streamy2008/jinshanling-yard-dashboard/金山岭小院施工协同网页/planD-3d/sky.jpg

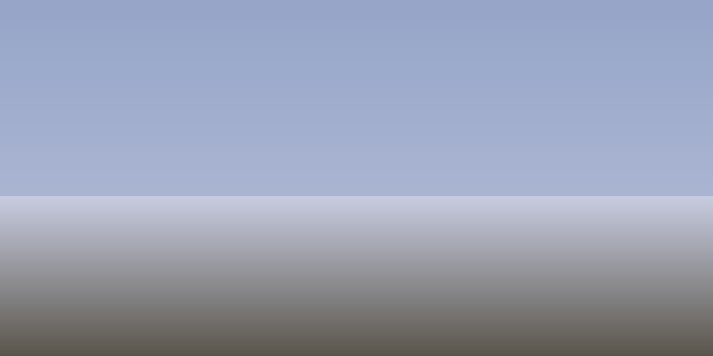
金山岭小院施工协同网页/planD-3d/sky.jpg
