streamy2008/jinshanling-yard-dashboard/20260624金山岭庭院合同/02_栏杆 杆件 置物架 详图_202607.pdf

# 金山岭庭院装置

## 圆钢栏杆、圆钢杆件、置物架详图

## 即作建筑 MINOR lab

（此文件标注为设计尺寸，详厂家二次深化）

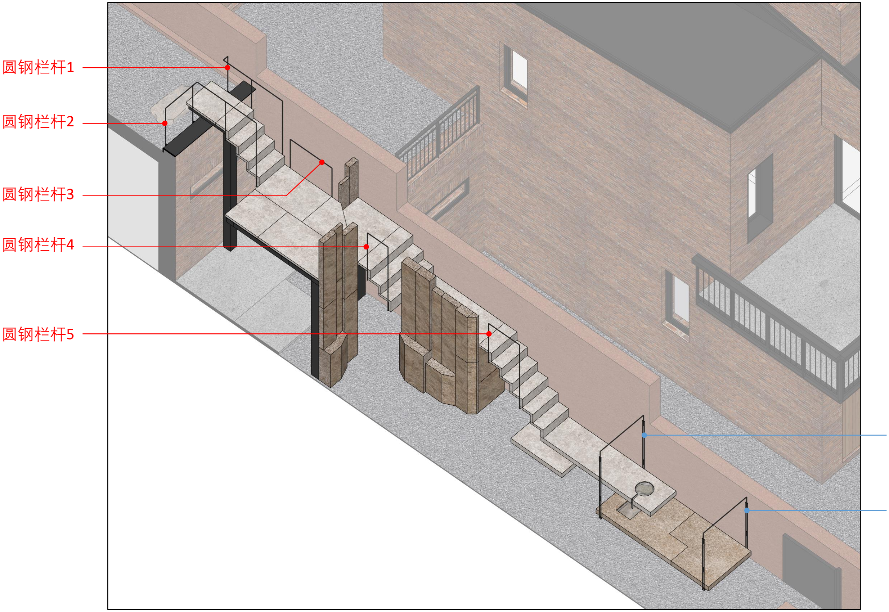
[picture p2: figure]
圆钢栏杆1; 圆钢栏杆2; 圆钢栏杆3; 圆钢栏杆4; 圆钢栏杆5

圆钢杆件A

圆钢杆件B

## 圆钢栏杆、圆钢杆件 索引图

## 圆钢栏杆1

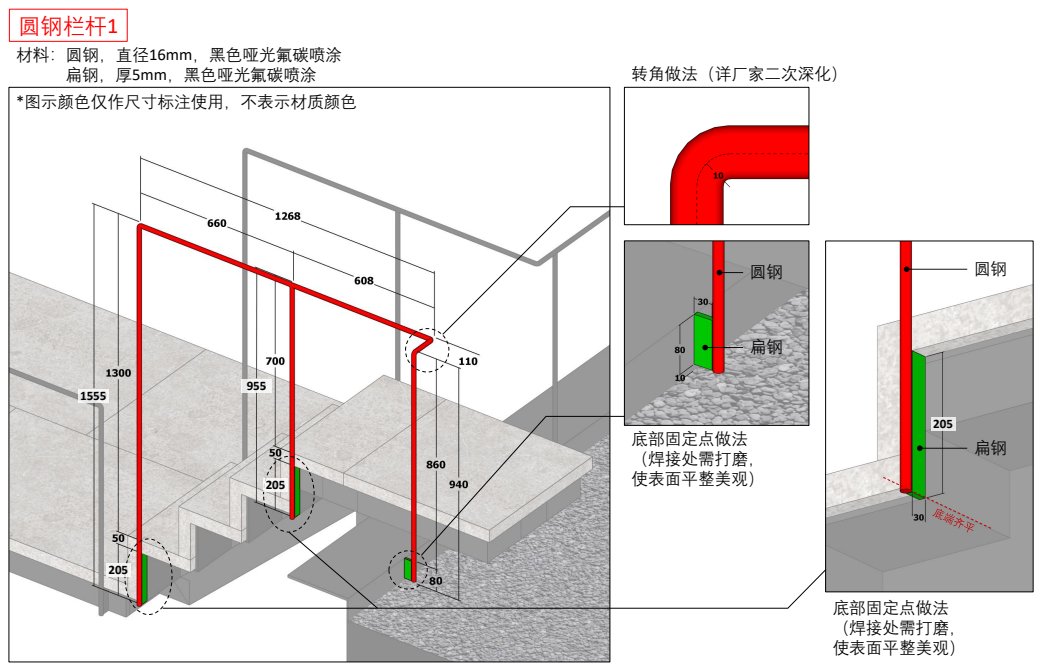
[picture p3: page 3]
转角做法（详厂家二次深化）; 底部固定点做法 （焊接处需打磨， 使表面平整美观）

材料：圆钢，直径16mm，黑色哑光氟碳喷涂
扁钢，厚5mm，黑色哑光氟碳喷涂
*图示颜色仅作尺寸标注使用，不表示材质颜色

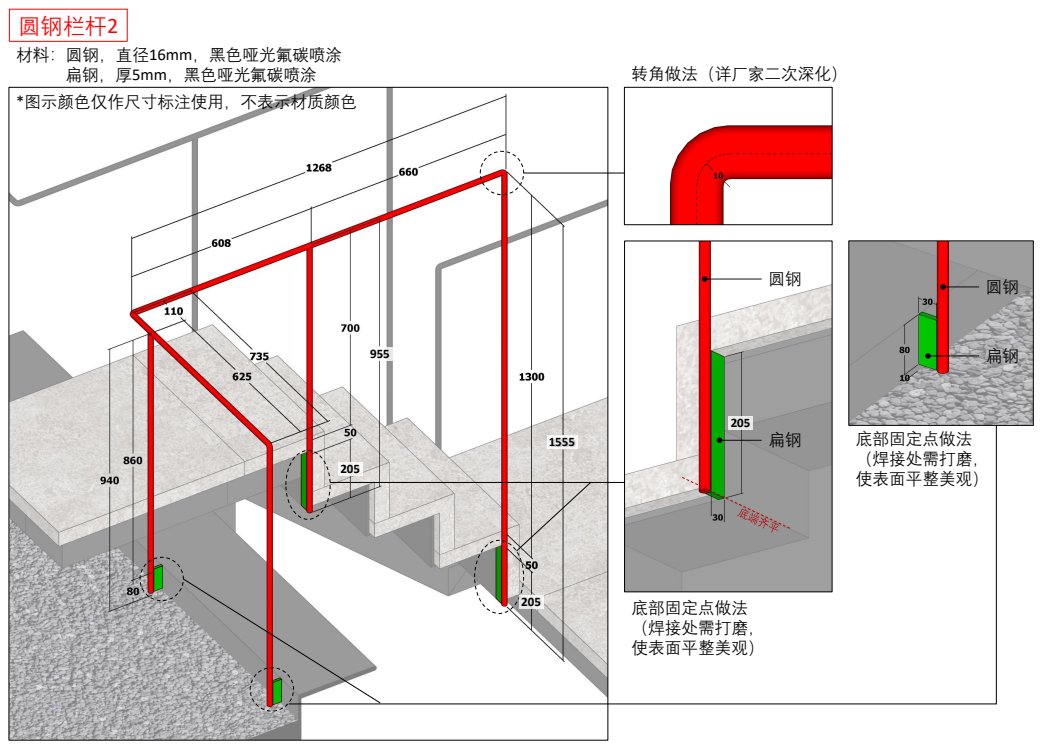
[picture p4: page 4]
底部固定点做法 （焊接处需打磨， 使表面平整美观）; 转角做法（详厂家二次深化）

材料：圆钢，直径16mm，黑色哑光氟碳喷涂
扁钢，厚5mm，黑色哑光氟碳喷涂
*图示颜色仅作尺寸标注使用，不表示材质颜色

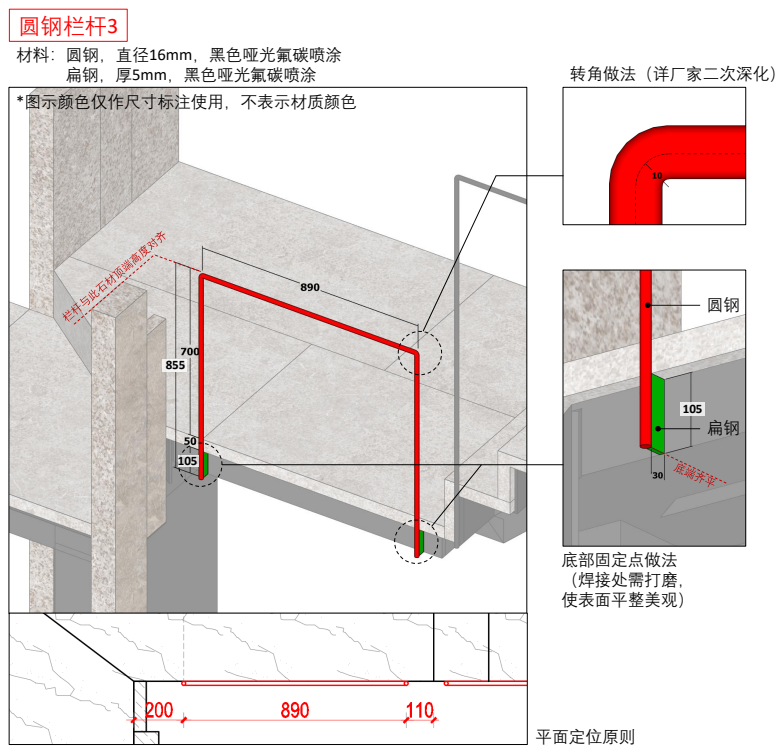
[picture p5: page 5]
底部固定点做法 （焊接处需打磨， 使表面平整美观）; 转角做法（详厂家二次深化）; 平面定位原则

材料：圆钢，直径16mm，黑色哑光氟碳喷涂
扁钢，厚5mm，黑色哑光氟碳喷涂
*图示颜色仅作尺寸标注使用，不表示材质颜色

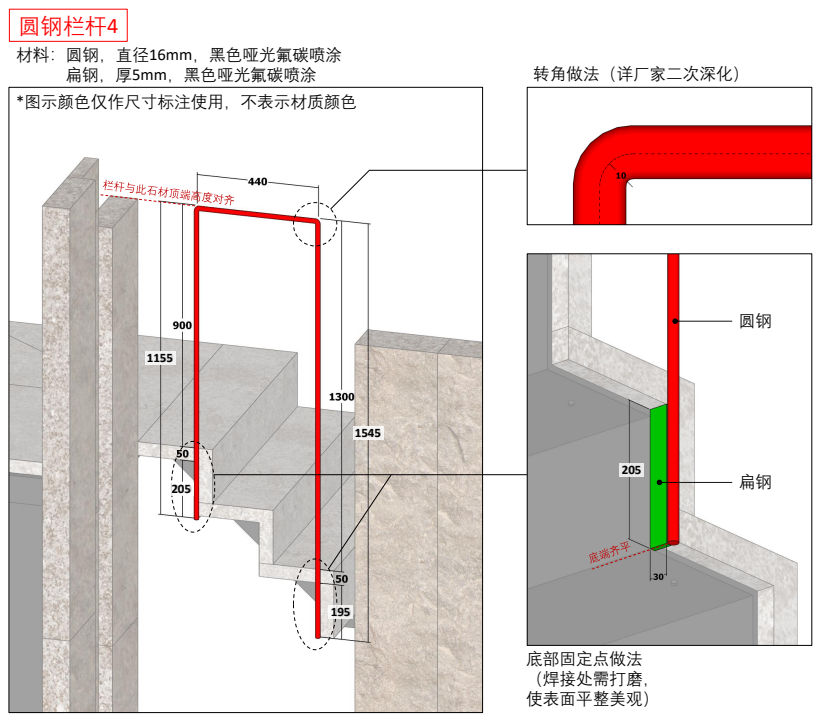
[picture p6: page 6]
底部固定点做法 （焊接处需打磨， 使表面平整美观）; 转角做法（详厂家二次深化）

材料：圆钢，直径16mm，黑色哑光氟碳喷涂
扁钢，厚5mm，黑色哑光氟碳喷涂
*图示颜色仅作尺寸标注使用，不表示材质颜色

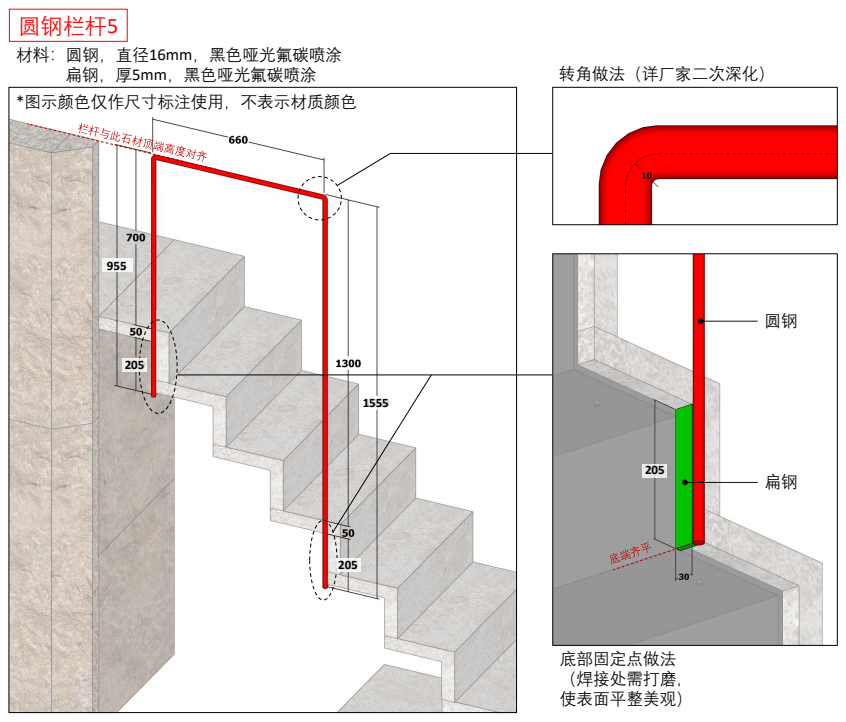
[picture p7: page 7]
底部固定点做法 （焊接处需打磨， 使表面平整美观）; 转角做法（详厂家二次深化）

材料：圆钢，直径16mm，黑色哑光氟碳喷涂
扁钢，厚5mm，黑色哑光氟碳喷涂
*图示颜色仅作尺寸标注使用，不表示材质颜色

## 圆钢杆件A

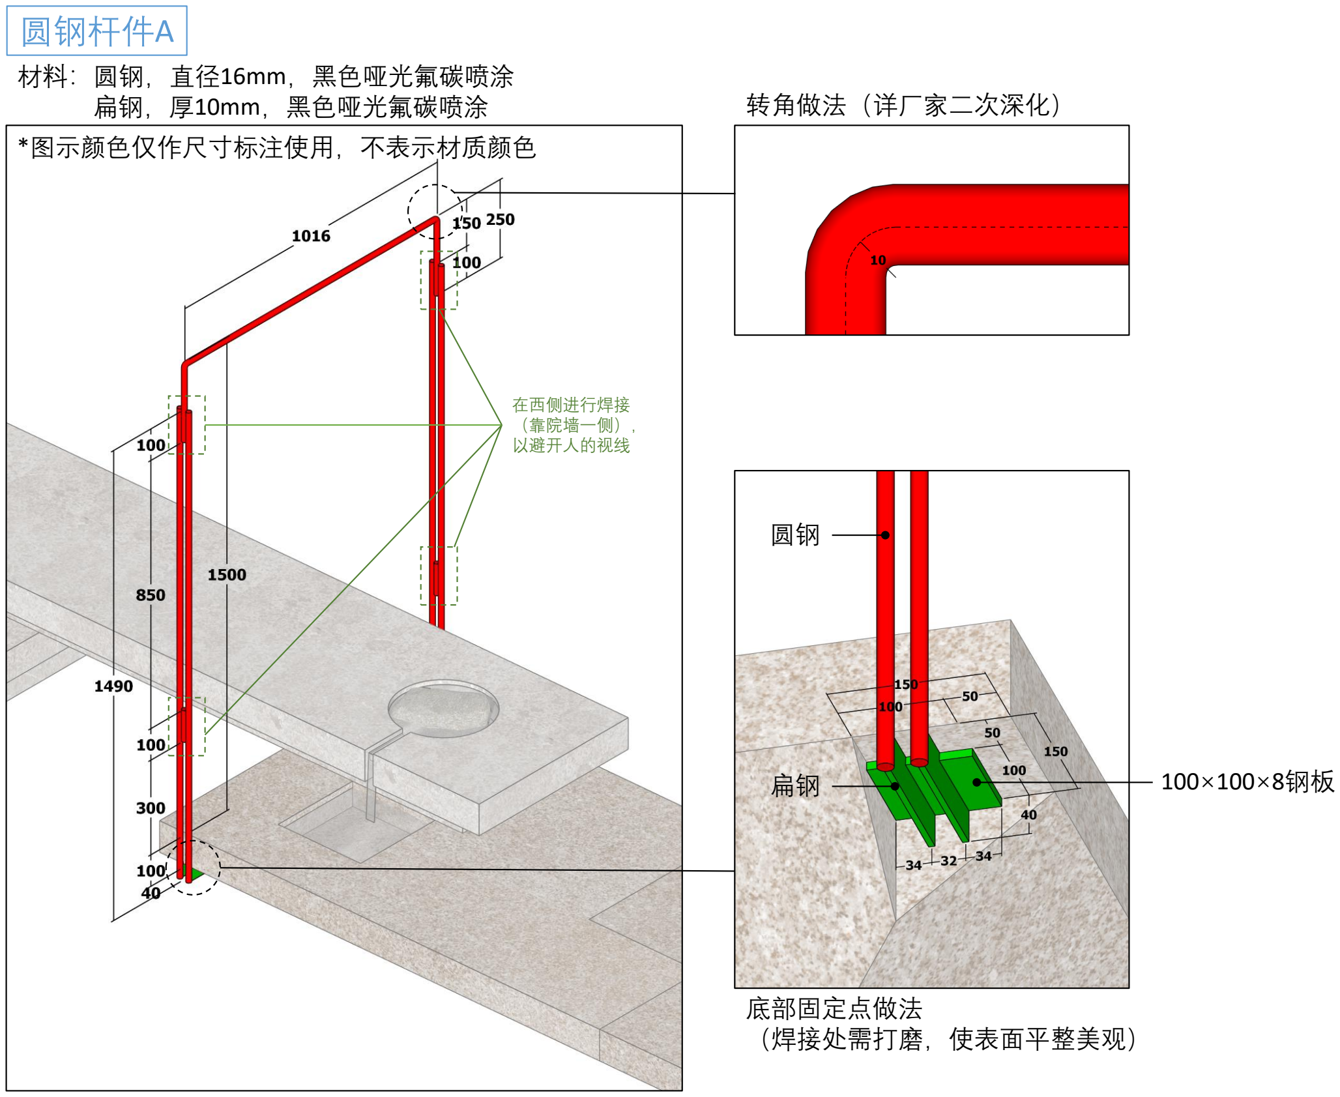
[picture p8: page 8]

*图示颜色仅作尺寸标注使用，不表示材质颜色

材料：圆钢，直径16mm，黑色哑光氟碳喷涂
扁钢，厚10mm，黑色哑光氟碳喷涂

在西侧进行焊接
（靠院墙一侧），
以避开人的视线

转角做法（详厂家二次深化）

底部固定点做法
（焊接处需打磨，使表面平整美观）

扁钢

圆钢

100×100×8钢板

## 圆钢杆件B

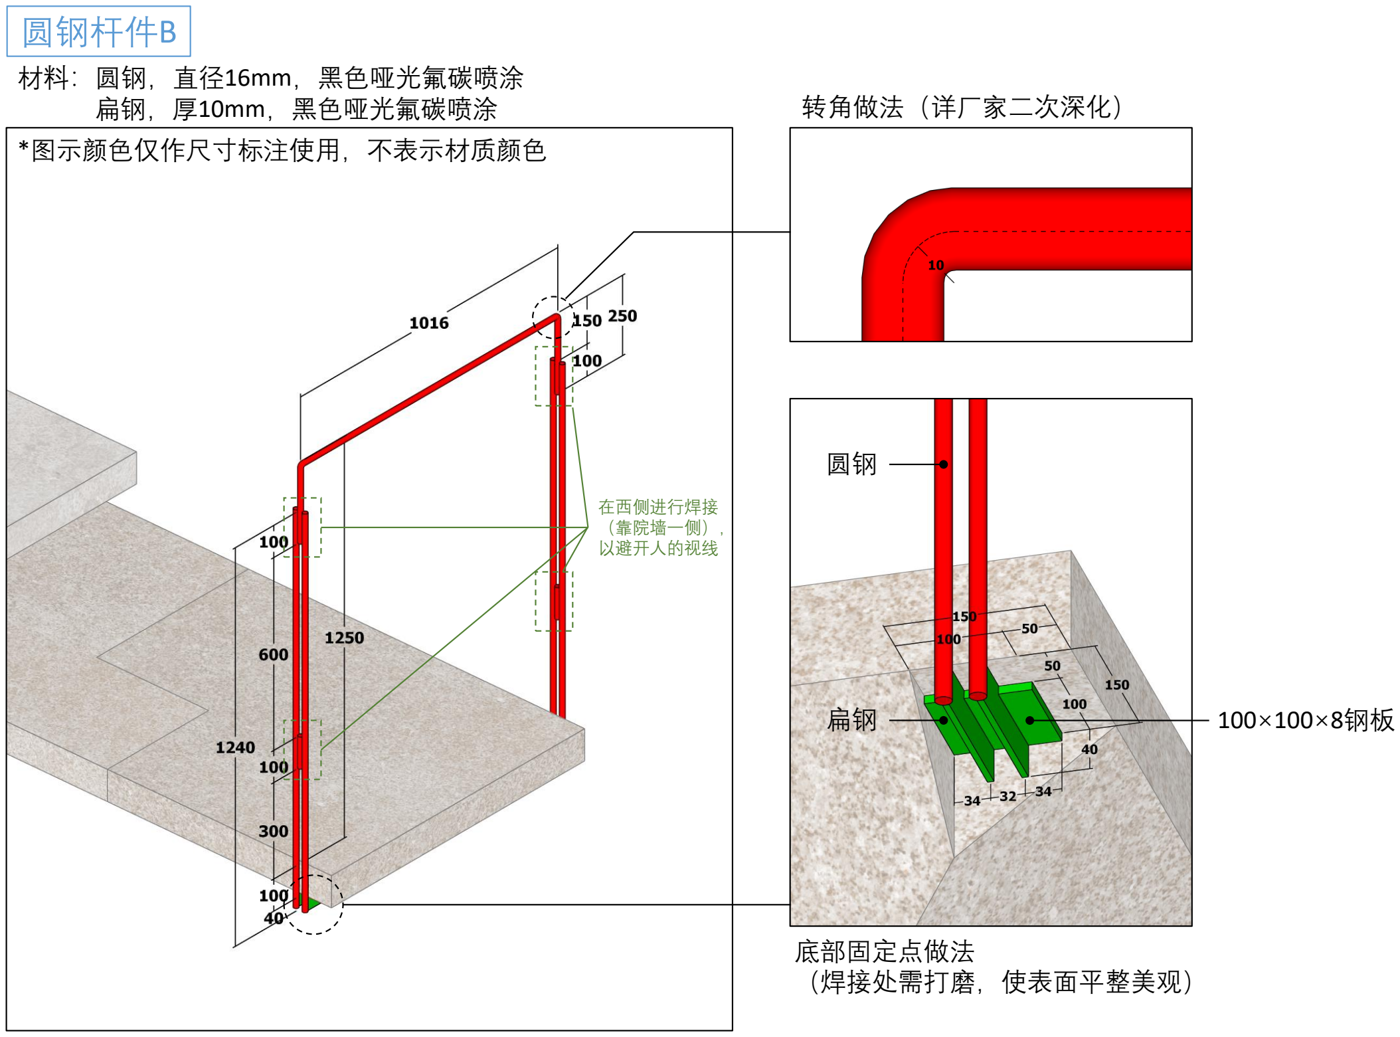
[picture p9: page 9]

*图示颜色仅作尺寸标注使用，不表示材质颜色

材料：圆钢，直径16mm，黑色哑光氟碳喷涂
扁钢，厚10mm，黑色哑光氟碳喷涂

扁钢

圆钢

在西侧进行焊接
（靠院墙一侧），
以避开人的视线

转角做法（详厂家二次深化）

底部固定点做法
（焊接处需打磨，使表面平整美观）

100×100×8钢板

## 置物架

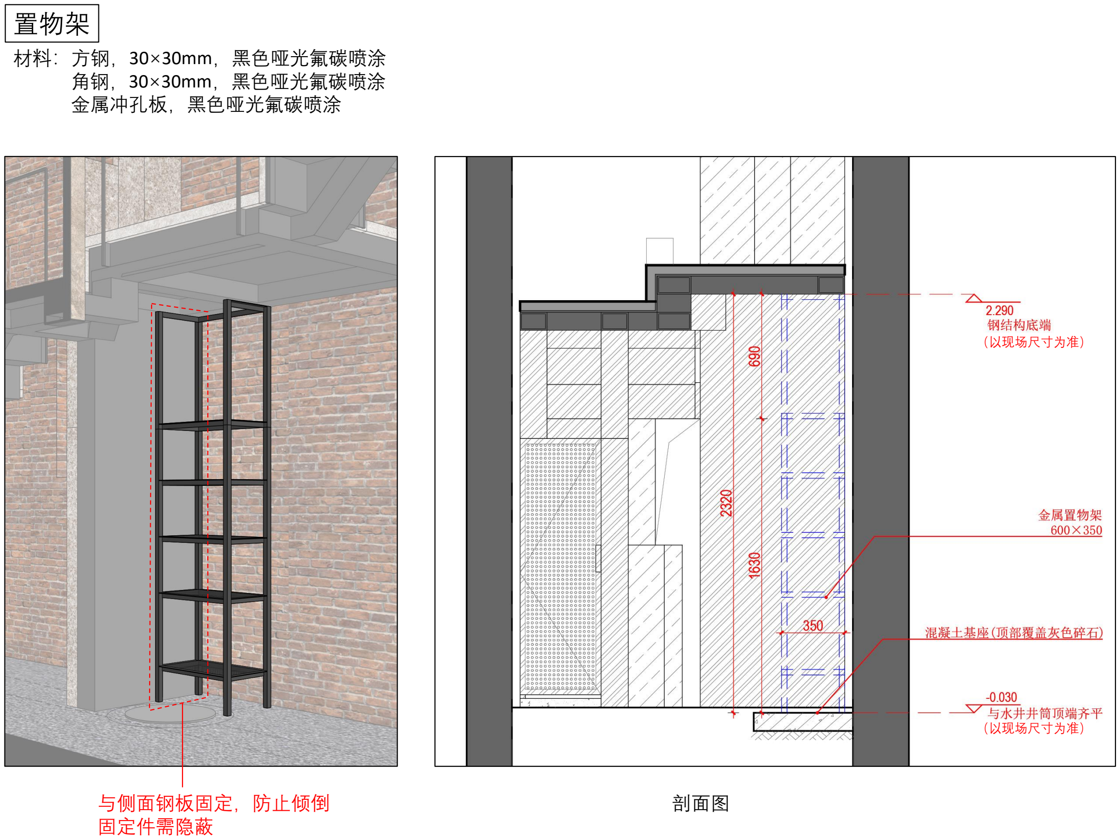
[picture p10: page 10]

材料：方钢，30×30mm，黑色哑光氟碳喷涂
角钢，30×30mm，黑色哑光氟碳喷涂
金属冲孔板，黑色哑光氟碳喷涂

与侧面钢板固定，防止倾倒
固定件需隐蔽

剖面图

（以现场尺寸为准）

（以现场尺寸为准）

## 置物架

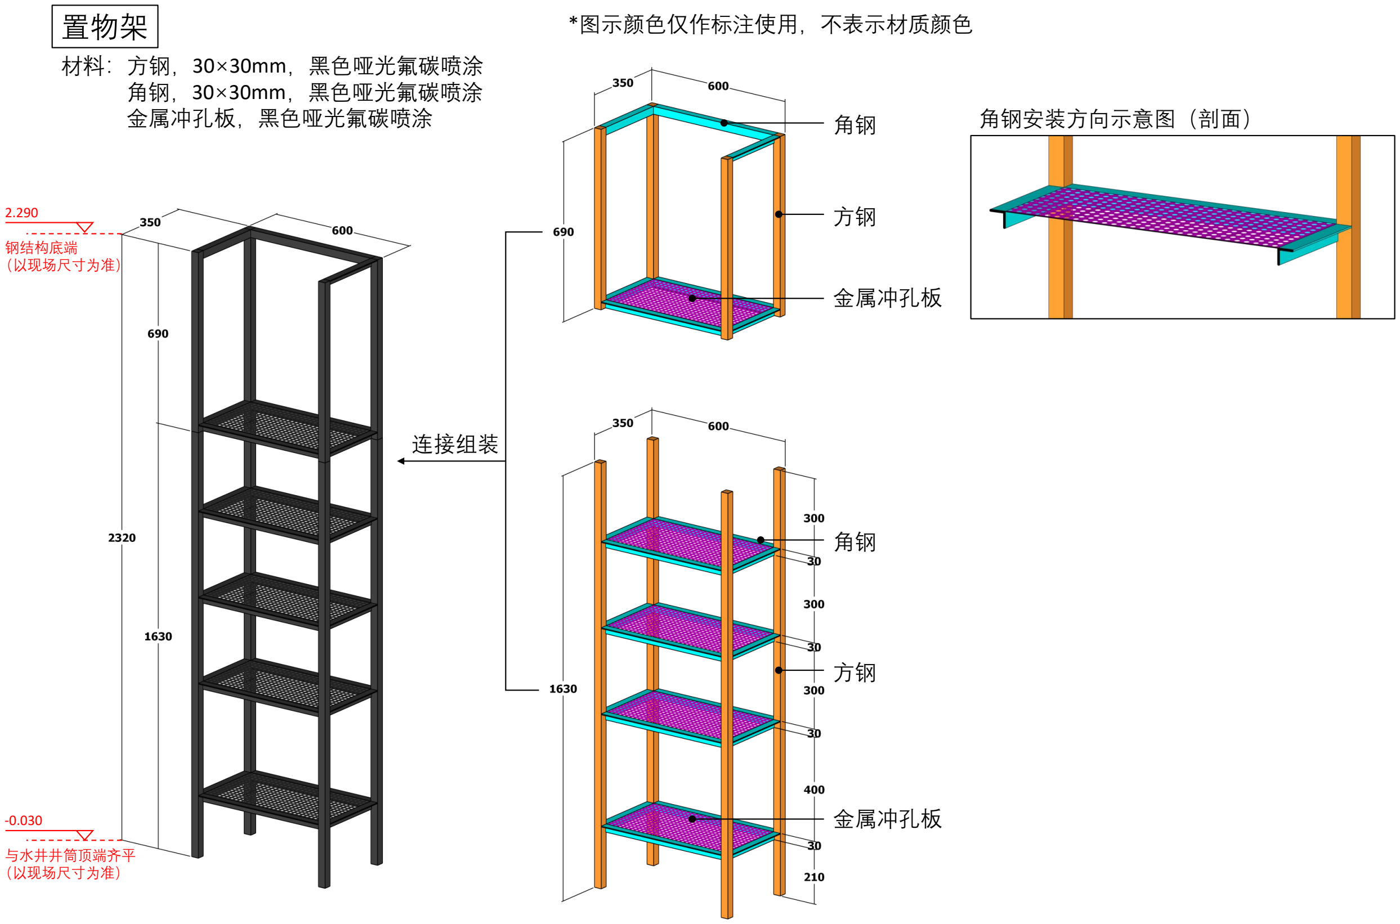
[picture p11: page 11]

2.290

钢结构底端
（以现场尺寸为准）

连接组装

材料：方钢，30×30mm，黑色哑光氟碳喷涂
角钢，30×30mm，黑色哑光氟碳喷涂
金属冲孔板，黑色哑光氟碳喷涂

方钢

金属冲孔板

角钢

方钢

金属冲孔板

角钢

角钢安装方向示意图（剖面）

-0.030

与水井井筒顶端齐平
（以现场尺寸为准）

*图示颜色仅作标注使用，不表示材质颜色
