streamy2008/jinshanling-yard-dashboard/20260624金山岭庭院合同/03_主要产品选型_202607.pdf

# 金山岭庭院装置

# 主 要 产 品 选 型

# 即作建筑 MINOR lab

## （此文件包含跌水装置所需设备选型，建议在石材加工阶段，将相关设备寄送至石材厂家进行安装测试与出水效果测试）

# 跌水装置水循环系统 装配图示

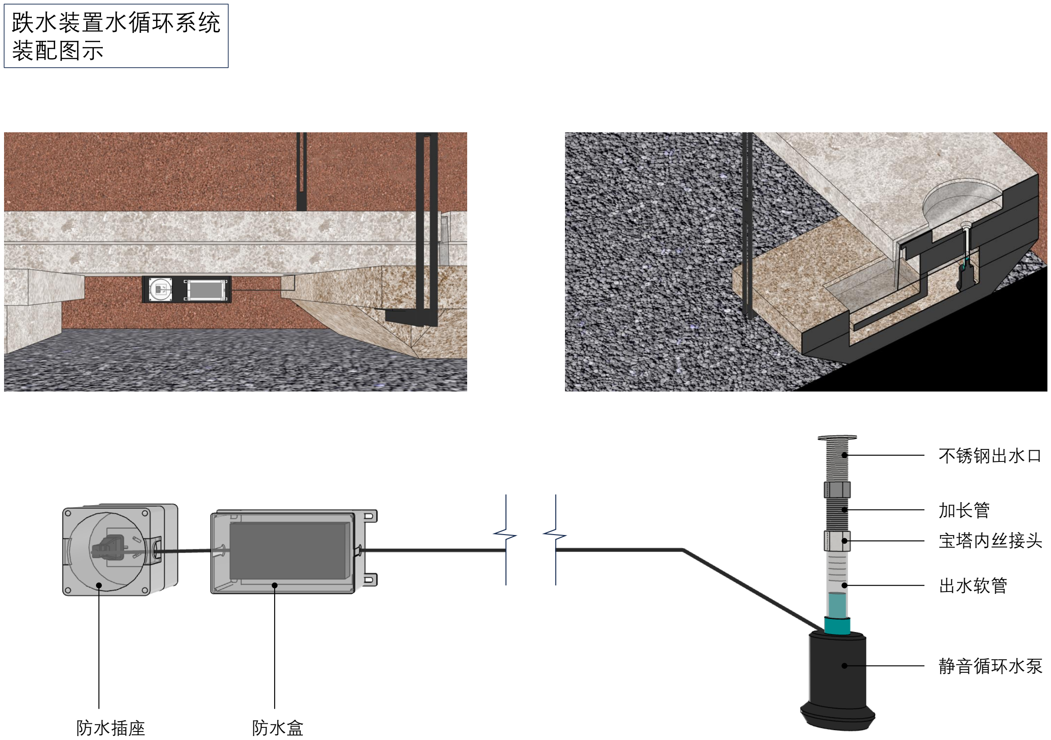
[picture p12: page 2]

## 静音循环水泵

## 出水软管

## 宝塔内丝接头

## 加长管

## 不锈钢出水口

防水插座 | 防水盒

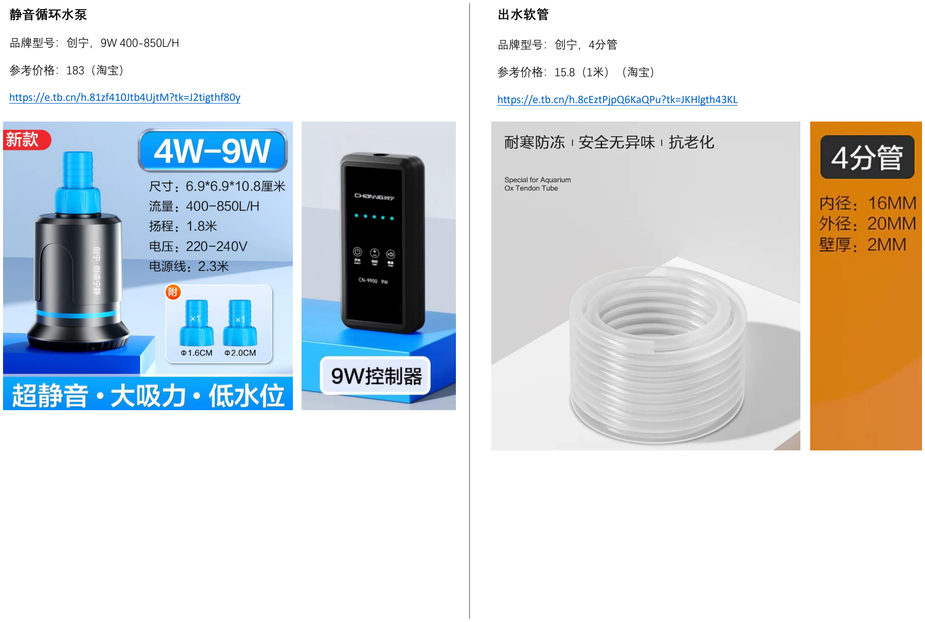
[picture p13: page 3]

静音循环水泵

品牌型号：创宁，9W 400-850L/H

参考价格：183（淘宝）

https://e.tb.cn/h.81zf410Jtb4UjtM?tk=J2tigthf80y

出水软管

品牌型号：创宁，4分管

参考价格：15.8（1米）（淘宝）

https://e.tb.cn/h.8cEztPjpQ6KaQPu?tk=JKHlgth43KL

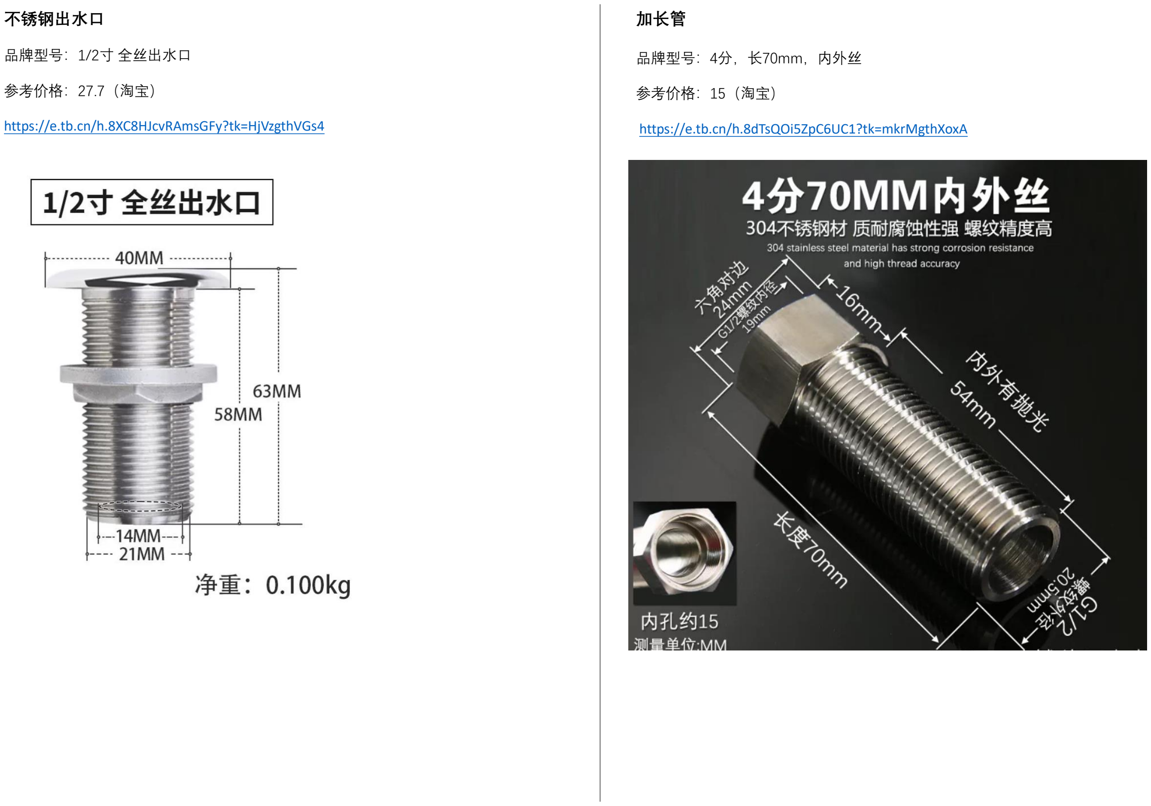
[picture p14: page 4]

加长管

品牌型号：4分，长70mm，内外丝

参考价格：15（淘宝）

https://e.tb.cn/h.8dTsQOi5ZpC6UC1?tk=mkrMgthXoxA

不锈钢出水口

品牌型号：1/2寸 全丝出水口

参考价格：27.7（淘宝）

https://e.tb.cn/h.8XC8HJcvRAmsGFy?tk=HjVzgthVGs4

硅胶垫片

品牌型号：4分，2个（视所需数量购买）

参考价格：0.05（淘宝）

https://e.tb.cn/h.81zX8YceLOrnqbb?tk=CrrwgthcYmJ

宝塔内丝接头

品牌型号：DN15，φ16mm

参考价格：2.6（淘宝）

https://e.tb.cn/h.8dTwWUBnoLqEItm?tk=5Xmhgth4VDz

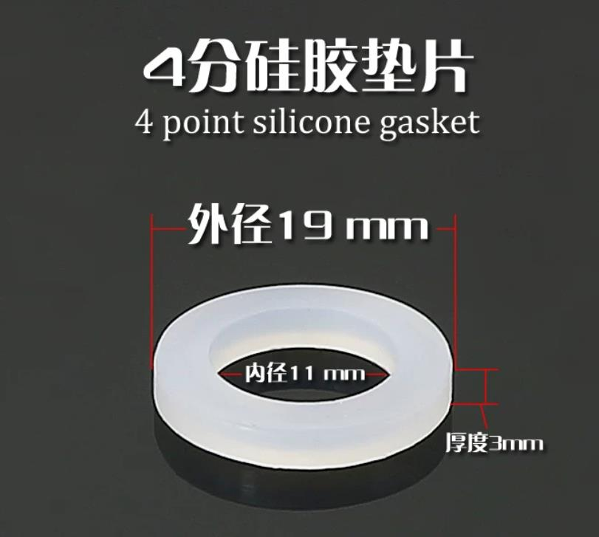
[picture p15: figure]
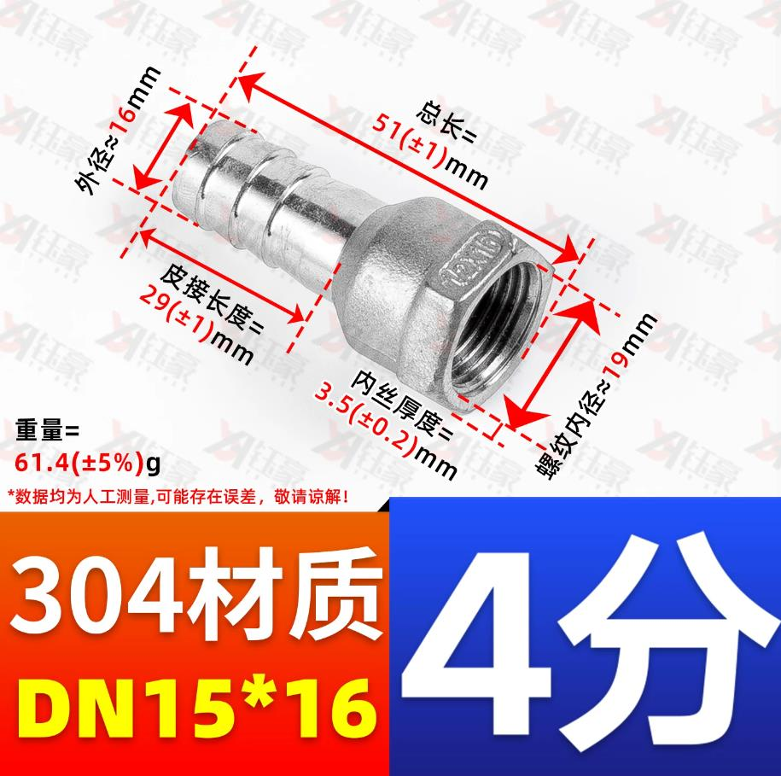
[picture p16: figure]

不锈钢喉箍
品牌型号：16~25，2个（视所需数量购买）

参考价格：0.7（淘宝）

https://e.tb.cn/h.8dTIQYuLtASYbxF?tk=EZXzgth1vkF

*配件

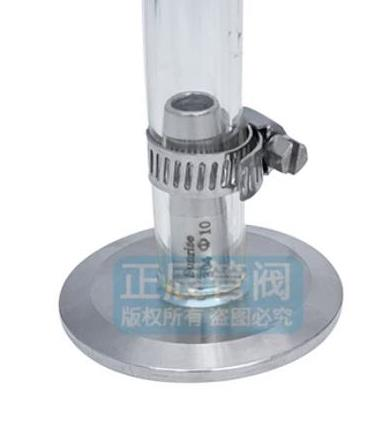
[picture p17: figure]
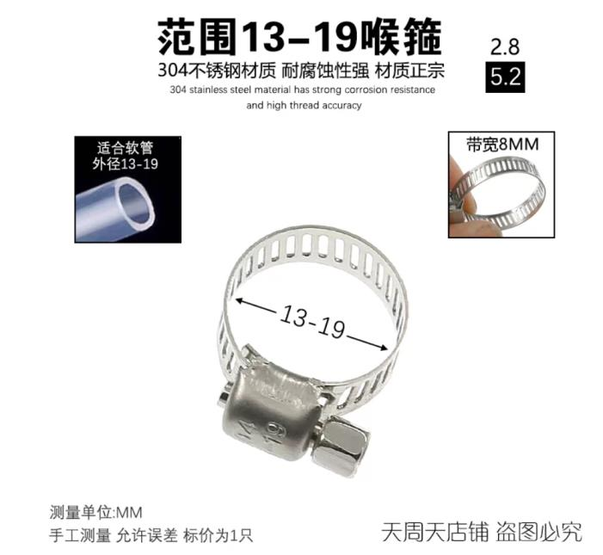
[picture p18: figure]
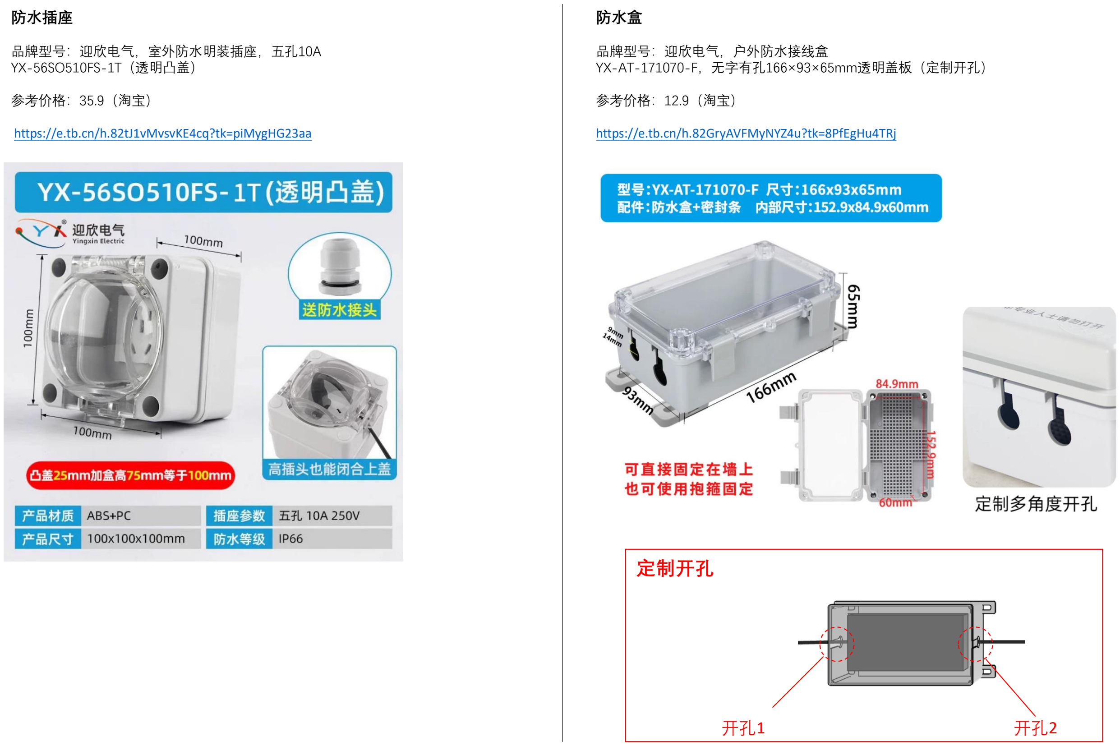
[picture p19: page 6]

防水插座

品牌型号：迎欣电气，室外防水明装插座，五孔10A
YX-56SO510FS-1T（透明凸盖）

参考价格：35.9（淘宝）

https://e.tb.cn/h.82tJ1vMvsvKE4cq?tk=piMygHG23aa

防水盒

品牌型号：迎欣电气，户外防水接线盒
YX-AT-171070-F，无字有孔166×93×65mm透明盖板（定制开孔）

参考价格：12.9（淘宝）

https://e.tb.cn/h.82GryAVFMyNYZ4u?tk=8PfEgHu4TRj

开孔1 | 开孔2

## 定制开孔

地面嵌入式防水射灯

品牌型号：西铁照明
色温：2700K（具体色温需结合现场及周边景观光环境综合确定） 厂家对接人：西铁照明 孙工
微信号：mhksjt

明装防水筒灯

品牌型号：西铁照明
尺寸：长宽80*80 高度83
颜色：黑色
色温：2700K（具体色温需结合现场及周边景观光环境综合确定） 厂家对接人：西铁照明 孙工
微信号：mhksjt

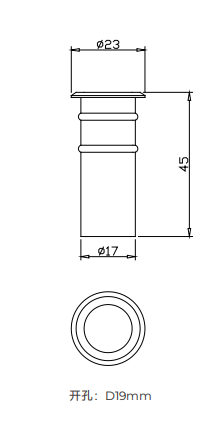
[picture p20: figure]
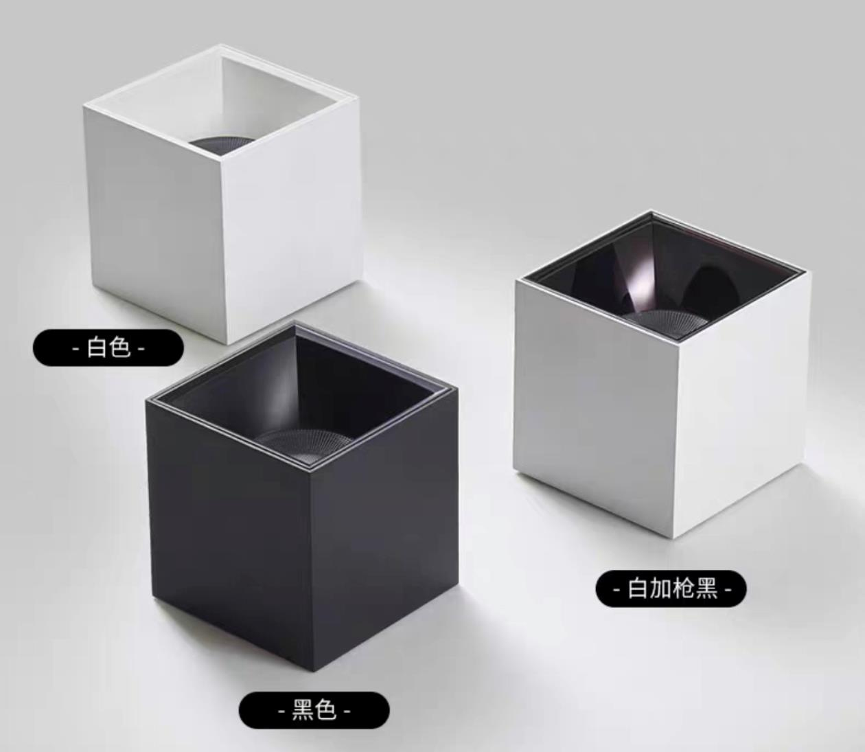
[picture p21: figure]
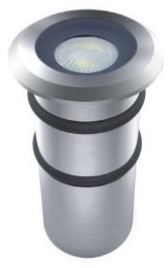
[picture p22: figure]
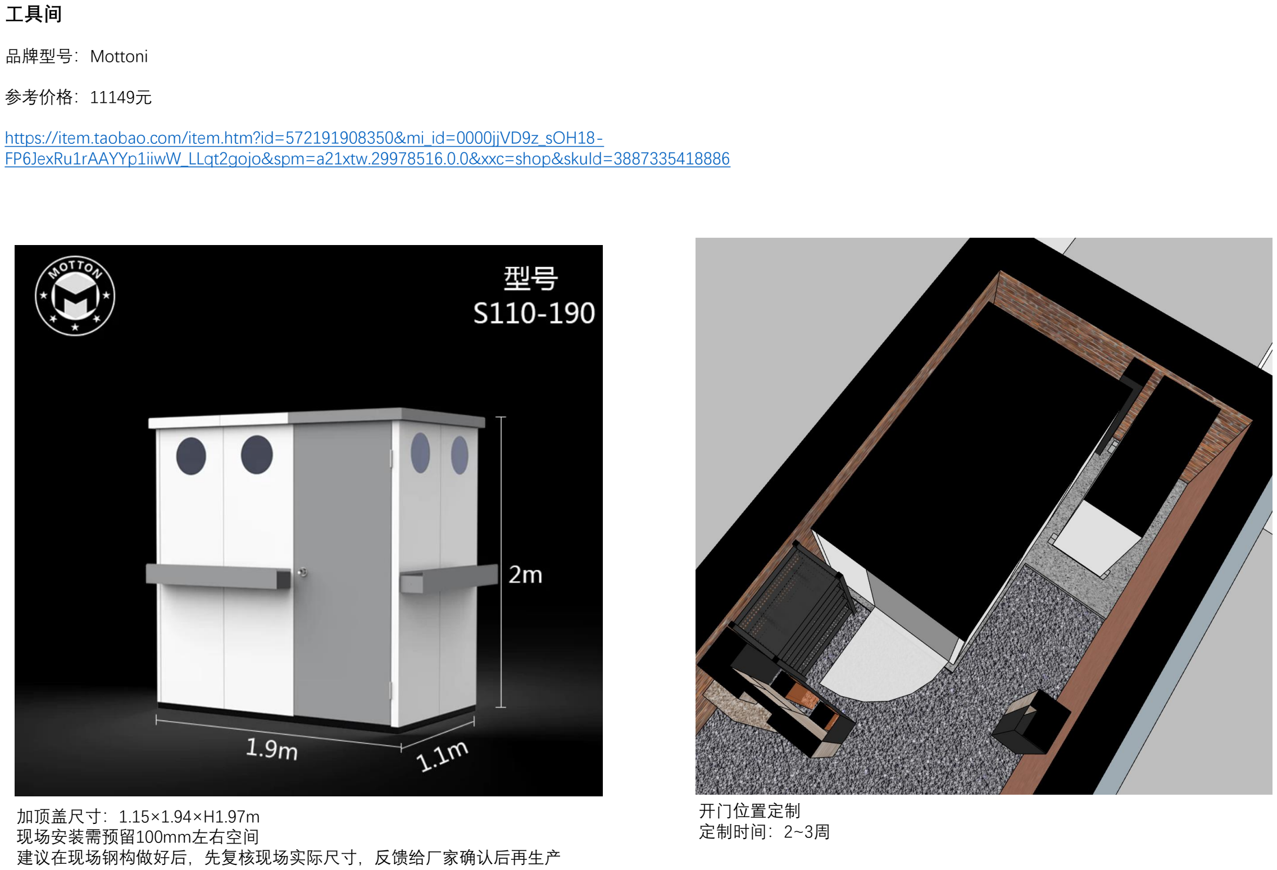
[picture p23: page 8]

工具间

品牌型号：Mottoni

参考价格：11149元

https://item.taobao.com/item.htm?id=572191908350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 (https://item.taobao.com/item.htm?id=572191908350&xxc=shop&skuId=3887335418886)

开门位置定制
定制时间：2~3周

加顶盖尺寸：1.15×1.94×H1.97m
现场安装需预留100mm左右空间
建议在现场钢构做好后，先复核现场实际尺寸，反馈给厂家确认后再生产
