streamy2008/jinshanling-yard-dashboard/20260624金山岭庭院合同/钢楼梯平台报价单_自由写_2026081_自由写_20260811174246.pdf

项目 | 价格（元）
材料 | 12500
加工费 | 3000
安装运输 | 7000
油漆 | 6000
混凝土浇筑 | 23000
栏杆置物架 | 6300
总价 | 57800
