streamy2008/jinshanling-yard-dashboard/金山岭小院施工协同网页/方案C_远山入水_深化大样.jpg

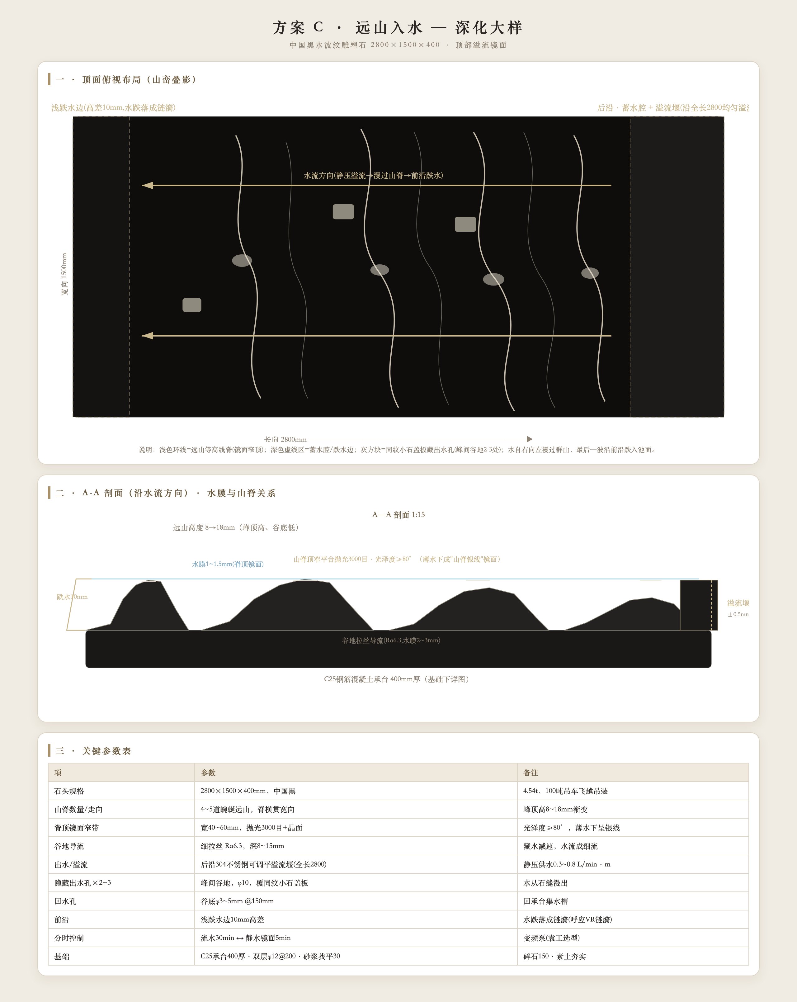
金山岭小院施工协同网页/方案C_远山入水_深化大样.jpg
