streamy2008/jinshanling-yard-dashboard/金山岭小院施工协同网页/水波纹4方案对比.jpg

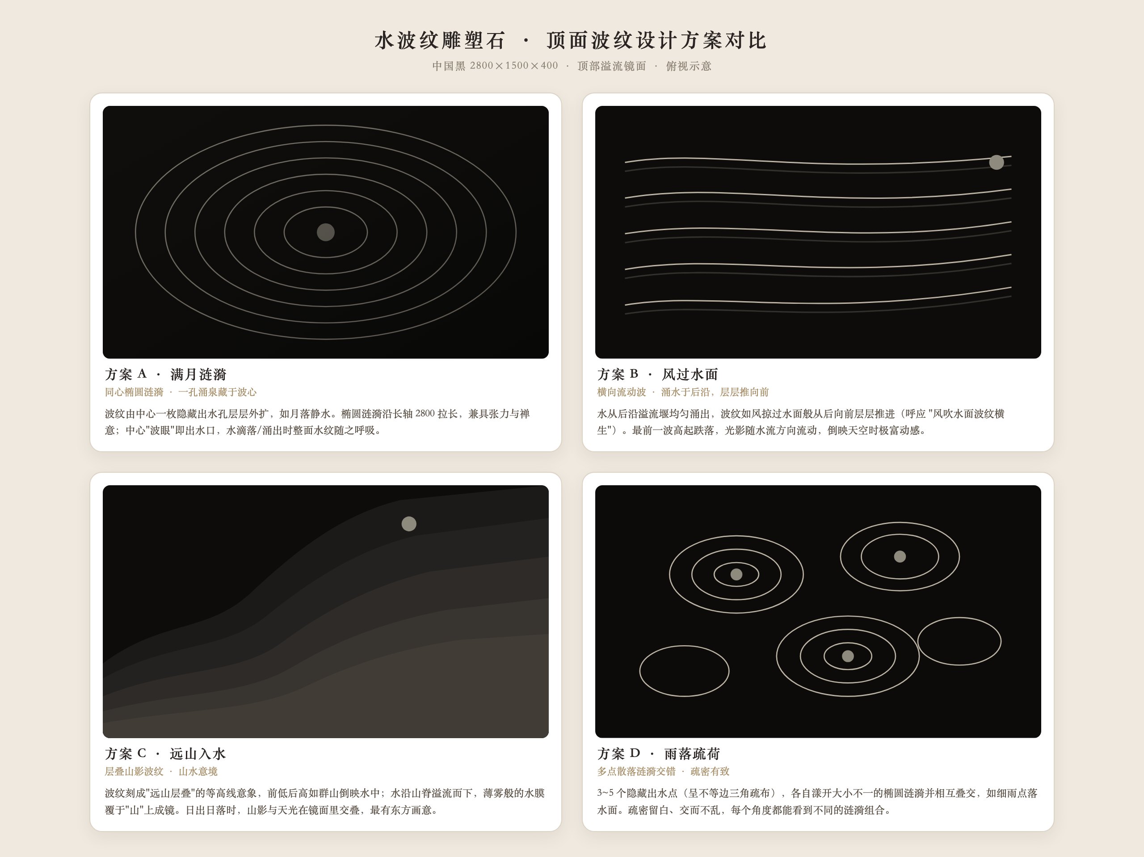
金山岭小院施工协同网页/水波纹4方案对比.jpg
