streamy2008/jinshanling-yard-dashboard/20260624金山岭庭院合同/里山墨石—阿那亚报价清单_按金额排序.xlsx

排序 | 原序号 | 商品名称 | 长 | 宽 | 高/厚 | 单位 | 工程量 | 单价 | 总价（元） | 说明 | 备注
1 | 6 | 中国黑雕塑石 | 3025 | 1400 | 400 | 块 | 1 | 30000 | 30000 | 水波纹雕塑加工
2 | 26 | 黄锈石雕塑D1 | 2400 | 1200 | 250 | 块 | 1 | 26000 | 26000 | 深化分板
3 | 1 | 中国黑石皮 | 1000左右 | 600以内 | 30-80 | m2 | 8.54 | 1800 | 15372
4 | 7 | 黄锈石台阶 | 600 | 270 | 200 | 块 | 10 | 1200 | 12000 | 台阶加工，L加工
5 | 27 | 黄锈石雕塑D2 | 1080 | 750 | 240 | 块 | 1 | 7000 | 7000 | 加工
6 | 9 | 黄锈石平台板 | 1000左右 | 600以内 | 100 | m2 | 3.75 | 1800 | 6750 | 深化分板
7 | 8 | 黄锈石台阶 | 1100 | 270 | 200 | 块 | 3 | 2100 | 6300 | 台阶加工，L加工
8 | 30 | 黄锈石雕塑D5 | 2245 | 600 | 100 | 块 | 1 | 4800 | 4800 | 加工
9 | 18 | 黄锈石雕塑C1 | 380 | 150 | 2150 | 块 | 1 | 4000 | 4000 | 深化分板，雕塑加工
10 | 29 | 黄锈石雕塑D4 | 1640 | 600 | 100 | 块 | 1 | 3500 | 3500 | 深化分板
11 | 21 | 黄锈石雕塑C4 | 400 | 100 | 2300 | 块 | 1 | 3300 | 3300 | 深化分板，雕塑加工
12 | 24 | 黄锈石雕塑C7 | 500 | 200 | 900 | 块 | 1 | 3200 | 3200 | 雕塑加工
13 | 19 | 黄锈石雕塑C2 | 400 | 100 | 2150 | 块 | 1 | 3100 | 3100 | 深化分板，雕塑加工
14 | 3 | 中国黑景石 | 1200 | 800 | 600 | 块 | 3 | 1000 | 3000 | 不加工
15 | 15 | 黄锈石雕塑B2 | 250 | 100 | 3300 | 块 | 1 | 3000 | 3000 | 深化分板，雕塑加工
16 | 20 | 黄锈石雕塑C3 | 300 | 100 | 2300 | 块 | 1 | 2500 | 2500 | 深化分板，雕塑加工
17 | 22 | 黄锈石雕塑C5 | 300 | 100 | 2300 | 块 | 1 | 2500 | 2500 | 深化分板，雕塑加工
18 | 14 | 黄锈石雕塑B1 | 200 | 100 | 3300 | 块 | 1 | 2400 | 2400 | 深化分板，雕塑加工
19 | 25 | 黄锈石雕塑C8 | 450 | 200 | 750 | 块 | 1 | 2400 | 2400 | 雕塑加工
20 | 16 | 黄锈石雕塑B3 | 200 | 100 | 3050 | 块 | 1 | 2200 | 2200 | 深化分板，雕塑加工
21 | 4 | 中国黑景石 | 460 | 300 | 300 | 块 | 4 | 500 | 2000 | 不加工
22 | 17 | 黄锈石雕塑B4 | 350 | 200 | 750 | 块 | 1 | 1900 | 1900 | 雕塑加工
23 | 28 | 黄锈石雕塑D3 | 900 | 600 | 100 | 块 | 1 | 1900 | 1900 | 雕塑加工
24 | 10 | 黄锈石雕塑A1 | 300 | 200 | 850 | 块 | 1 | 1800 | 1800 | 雕塑加工
25 | 2 | 中国黑景石 | 2200 | 800 | 600 | 块 | 1 | 1700 | 1700 | 不加工
26 | 13 | 黄锈石雕塑A4 | 200 | 100 | 2200 | 块 | 1 | 1600 | 1600 | 雕塑加工
27 | 23 | 黄锈石雕塑C6 | 200 | 100 | 1600 | 块 | 1 | 1200 | 1200 | 深化分板，雕塑加工
28 | 5 | 中国黑景石 | 1000 | 600 | 600 | 块 | 1 | 600 | 600 | 不加工
29 | 11 | 黄锈石雕塑A2 | 150 | 50 | 600 | 块 | 1 | 500 | 500 | 雕塑加工
30 | 12 | 黄锈石雕塑A3 | 150 | 100 | 600 | 块 | 1 | 500 | 500 | 雕塑加工
 | 合计 |  |  |  |  |  |  | 157022 | 157022
 | 税金1% |  |  |  |  |  |  | 1570 | 1570
 | 共计（不含安装、不含运费、不含卸车） |  |  |  |  |  |  | 158592 | 158592
