streamy2008/jinshanling-yard-dashboard/20260624金山岭庭院合同/里山墨石—阿那亚报价清单对比_20260829_vs_20260830.xlsx

Sheet: 总体对比汇总
里山墨石—阿那亚报价清单 (20260829 vs 20260830) 总体对比汇总表
生成时间: 2026-08-30 | 对比说明: 20260830版针对老皮黄锈石雕塑D4/D5及D1进行了单价与尺寸优化调整
对比维度 / 项目 | 20260829 版 | 20260830 版 | 差异额 (20260830 - 20260829) | 变化比例 | 核心变化说明
工程总条目数 | 56 项 | 56 项 | 0 项 | 0.0% | 品类与规格项完全一致 (均包含#1~#9景石及A~D组雕塑)
报价清单合计金额 (不含税) | ¥219716.00 | ¥205716.00 | -¥14000.00 | -6.37% | D4降1.2万，D5降2千，D1规格价格调整相抵
税金 (1%) | ¥2197.16 | ¥2057.16 | -¥140.00 | -6.37% | 按不含税小计金额的 1% 随动计算
共计总金额 (不含安装/运费/卸车) | ¥221913.16 | ¥207773.16 | -¥14140.00 | -6.37% | 整体造价直降 14,140 元 (下降 6.37%)

Sheet: 56项全明细对比
里山墨石—阿那亚报价清单 56项明细逐项对比表 (20260829 vs 20260830)
序号 | 商品名称 | 规格尺寸 (长×宽×高/厚 mm) | 单位 | 工程量 | 20260829 单价(元) | 20260829 总价(元) | 20260830 单价(元) | 20260830 总价(元) | 单价变动(元) | 总价变动(元) | 变化状态 | 加工/备注说明
1 | 中国黑石皮 | 1000左右 × 600以内 × 30-80 | m2 | 6.50 | ¥1800 | ¥11700 | ¥1800 | ¥11700 | ¥0 | ¥0 | 持平 | 加工
2 | 太行金踏步板 | 2700 × 600 × 100 | 块 | 1 | ¥5000 | ¥5000 | ¥5000 | ¥5000 | ¥0 | ¥0 | 持平 | 整板加工
3 | 中国黑景石#1 | 1600 × 1300 × 500 | 块 | 1 | ¥2000 | ¥2000 | ¥2000 | ¥2000 | ¥0 | ¥0 | 持平 | 不加工
4 | 中国黑景石#2 | 1100 × 700 × 350 | 块 | 1 | ¥1500 | ¥1500 | ¥1500 | ¥1500 | ¥0 | ¥0 | 持平 | 加工
5 | 中国黑景石#3 | 530 × 400 × 550 | 块 | 1 | ¥600 | ¥600 | ¥600 | ¥600 | ¥0 | ¥0 | 持平 | 加工，切角， 合缝
6 | 中国黑景石#4 | 580 × 300 × 250 | 块 | 1 | ¥500 | ¥500 | ¥500 | ¥500 | ¥0 | ¥0 | 持平 | 加工，合缝
7 | 中国黑景石#5 | 1250 × 500 × 600 | 块 | 1 | ¥2000 | ¥2000 | ¥2000 | ¥2000 | ¥0 | ¥0 | 持平 | 背切平，加工 合缝
8 | 中国黑雕塑石 | 2800 × 1500 × 400 | 块 | 1 | ¥30000 | ¥30000 | ¥30000 | ¥30000 | ¥0 | ¥0 | 持平 | 水波纹雕塑加 工
9 | 中国黑景石#6 | 650 × 330 × 250 | 块 | 1 | ¥600 | ¥600 | ¥600 | ¥600 | ¥0 | ¥0 | 持平 | 加工，切角，
10 | 中国黑雕塑石 | 200 × 200 × 350 | 块 | 2 | ¥1100 | ¥2200 | ¥1100 | ¥2200 | ¥0 | ¥0 | 持平 | 内凹磨光雕塑 景石
11 | 中国黑景石#7 | 600 × 600 × 350 | 块 | 1 | ¥700 | ¥700 | ¥700 | ¥700 | ¥0 | ¥0 | 持平 | 加工，切角， 合缝
12 | 中国黑景石#8 | 600 × 500 × 500 | 块 | 1 | ¥800 | ¥800 | ¥800 | ¥800 | ¥0 | ¥0 | 持平 | 加工，切角， 合缝
13 | 中国黑景石#9 | 650 × 500 × 200 | 块 | 1 | ¥800 | ¥800 | ¥800 | ¥800 | ¥0 | ¥0 | 持平 | 加工切底
14 | 黄绣石地铺 老皮拉槽面穿插 | 1300 × 800 × 80 | m2 | 4.14 | ¥1000 | ¥4140 | ¥1000 | ¥4140 | ¥0 | ¥0 | 持平 | 加工
15 | 黄绣石桥面 老皮拉槽面穿插 | 1400 × 800 × 130 | m2 | 1.03 | ¥1600 | ¥1648 | ¥1600 | ¥1648 | ¥0 | ¥0 | 持平 | 两块拼接蝴蝶 榫 底部内凹 50*50凹槽
16 | 黄绣石入户踏步 老皮拉槽面穿插 | 1600 × 1070 × 180 | m2 | 1.69 | ¥2200 | ¥3718 | ¥2200 | ¥3718 | ¥0 | ¥0 | 持平 | 加工
17 | 黄绣石 太行金老皮面穿 插地铺 | 1800 × 500 × 80 | m2 | 5.52 | ¥1000 | ¥5520 | ¥1000 | ¥5520 | ¥0 | ¥0 | 持平 | 加工
18 | 太行金老皮踏步 | 1400 × 350 × 100 | m2 | 0.38 | ¥1200 | ¥456 | ¥1200 | ¥456 | ¥0 | ¥0 | 持平 | 加工
19 | 太行金老皮踏步 | 1500 × 450 × 200 | m2 | 0.58 | ¥2400 | ¥1392 | ¥2400 | ¥1392 | ¥0 | ¥0 | 持平 | 加工
20 | 黄锈石台阶 | 600 × 270 × 200 | 块 | 10 | ¥1200 | ¥12000 | ¥1200 | ¥12000 | ¥0 | ¥0 | 持平 | 台阶加工，L 加工
21 | 黄锈石台阶 | 1100 × 270 × 200 | 块 | 3 | ¥2100 | ¥6300 | ¥2100 | ¥6300 | ¥0 | ¥0 | 持平 | 台阶加工，L 加工
22 | 黄锈石平台 | 1510 × 600 × 100 | m2 | 0.91 | ¥1800 | ¥1638 | ¥1800 | ¥1638 | ¥0 | ¥0 | 持平 | 加工
23 |  | 1300 × 700 × 100 | m2 | 0.91 | ¥1800 | ¥1638 | ¥1800 | ¥1638 | ¥0 | ¥0 | 持平 | 加工
24 |  | 700 × 700 × 100 | m2 | 0.49 | ¥1800 | ¥882 | ¥1800 | ¥882 | ¥0 | ¥0 | 持平 | 加工
25 |  | 1000 × 700 × 100 | m2 | 0.70 | ¥1800 | ¥1260 | ¥1800 | ¥1260 | ¥0 | ¥0 | 持平 | 加工
26 |  | 1000 × 700 × 200 | m2 | 0.70 | ¥3600 | ¥2520 | ¥3600 | ¥2520 | ¥0 | ¥0 | 持平 | 整石L角踏步
27 |  | 1000 × 900 × 100 | m2 | 0.90 | ¥1800 | ¥1620 | ¥1800 | ¥1620 | ¥0 | ¥0 | 持平 | 加工
28 |  | 600 × 630 × 100 | m2 | 0.38 | ¥1800 | ¥684 | ¥1800 | ¥684 | ¥0 | ¥0 | 持平 | 加工
29 | 老皮黄锈石雕塑 A1 | 300 × 200 × 850 | 块 | 1 | ¥2300 | ¥2300 | ¥2300 | ¥2300 | ¥0 | ¥0 | 持平 | 雕塑加工
30 | 老皮黄锈石雕塑 A2 | 150 × 50 × 600 | 块 | 1 | ¥700 | ¥700 | ¥700 | ¥700 | ¥0 | ¥0 | 持平 | 雕塑加工
31 | 老皮黄锈石雕塑 A3 | 150 × 100 × 600 | 块 | 1 | ¥1400 | ¥1400 | ¥1400 | ¥1400 | ¥0 | ¥0 | 持平 | 雕塑加工
32 | 老皮黄锈石雕塑 A4 | 200 × 100 × 1500 | 块 | 1 | ¥1400 | ¥1400 | ¥1400 | ¥1400 | ¥0 | ¥0 | 持平 | 加工
33 |  | 200 × 100 × 1700 | 块 | 1 | ¥1500 | ¥1500 | ¥1500 | ¥1500 | ¥0 | ¥0 | 持平
34 |  | 200 × 50 × 850 | 块 | 1 | ¥1000 | ¥1000 | ¥1000 | ¥1000 | ¥0 | ¥0 | 持平
35 | 老皮黄锈石雕塑 B1 | 300 × 100 × 1600 | 块 | 1 | ¥2200 | ¥2200 | ¥2200 | ¥2200 | ¥0 | ¥0 | 持平 | 加工
36 | 老皮黄锈石雕塑 B2 | 200 × 50 × 1300 | 块 | 1 | ¥600 | ¥600 | ¥600 | ¥600 | ¥0 | ¥0 | 持平 | 加工
37 | 老皮黄锈石雕塑 B3 | 300 × 100 × 1550 | 块 | 1 | ¥2100 | ¥2100 | ¥2100 | ¥2100 | ¥0 | ¥0 | 持平 | 加工
38 | 老皮黄锈石雕塑 B4 | 300 × 100 × 1000 | 块 | 1 | ¥1400 | ¥1400 | ¥1400 | ¥1400 | ¥0 | ¥0 | 持平 | 加工
39 | 老皮黄锈石雕塑 B5 | 200 × 50 × 1300 | 块 | 1 | ¥600 | ¥600 | ¥600 | ¥600 | ¥0 | ¥0 | 持平 | 加工
40 | 老皮黄锈石雕塑 B6 | 300 × 100 × 1650 | 块 | 1 | ¥2200 | ¥2200 | ¥2200 | ¥2200 | ¥0 | ¥0 | 持平 | 加工
41 | 老皮黄锈石雕塑 B7 | 500 × 250 × 850 | 块 | 1 | ¥4800 | ¥4800 | ¥4800 | ¥4800 | ¥0 | ¥0 | 持平 | 加工
42 | 老皮黄锈石雕塑 C1 | 300 × 150 × 1700 | 块 | 1 | ¥3000 | ¥3000 | ¥3000 | ¥3000 | ¥0 | ¥0 | 持平 | 加工
43 | 老皮黄锈石雕塑 C2 | 300 × 150 × 1700 | 块 | 1 | ¥3400 | ¥3400 | ¥3400 | ¥3400 | ¥0 | ¥0 | 持平 | 加工
44 | 老皮黄锈石雕塑 C3 | 200 × 100 × 1650 | 块 | 1 | ¥1500 | ¥1500 | ¥1500 | ¥1500 | ¥0 | ¥0 | 持平 | 加工
45 | 老皮黄锈石雕塑 C4 | 350 × 100 × 1650 | 块 | 1 | ¥2600 | ¥2600 | ¥2600 | ¥2600 | ¥0 | ¥0 | 持平 | 加工
46 | 老皮黄锈石雕塑 C5 | 360 × 150 × 1100 | 块 | 1 | ¥2700 | ¥2700 | ¥2700 | ¥2700 | ¥0 | ¥0 | 持平 | 加工
47 | 老皮黄锈石雕塑 C6 | 360 × 150 × 1300 | 块 | 1 | ¥3200 | ¥3200 | ¥3200 | ¥3200 | ¥0 | ¥0 | 持平 | 加工
48 | 老皮黄锈石雕塑 C7 | 550 × 250 × 750 | 块 | 1 | ¥4600 | ¥4600 | ¥4600 | ¥4600 | ¥0 | ¥0 | 持平 | 加工
49 | 老皮黄锈石雕塑 C8 | 600 × 300 × 950 | 块 | 1 | ¥7700 | ¥7700 | ¥7700 | ¥7700 | ¥0 | ¥0 | 持平 | 加工
50 | 老皮黄锈石雕塑 C9 | 900 × 600 × 50 | 块 | 1 | ¥1200 | ¥1200 | ¥1200 | ¥1200 | ¥0 | ¥0 | 持平 | 加工
51 | 老皮黄锈石雕塑 C10 | 750 × 600 × 50 | 块 | 1 | ¥1000 | ¥1000 | ¥1000 | ¥1000 | ¥0 | ¥0 | 持平 | 加工
52 | 老皮黄锈石雕塑 D1 | 2340 × 600 × 200 | 块 | 1 | ¥15000 | ¥15000 | ¥15000 | ¥15000 | ¥0 | ¥0 | 持平 | 雕塑加工
53 | 老皮黄锈石雕塑 D2 | 1090 × 671 × 100 | 块 | 1 | ¥3300 | ¥3300 | ¥3300 | ¥3300 | ¥0 | ¥0 | 持平 | 加工
54 | 老皮黄锈石雕塑 D3 | 990 × 570 × 100 | 块 | 1 | ¥2500 | ¥2500 | ¥2500 | ¥2500 | ¥0 | ¥0 | 持平 | 加工
55 | 老皮黄锈石雕塑 D4 | 1600 × 1000 × 200 | 块 | 1 | ¥29000 | ¥29000 | ¥17000 | ¥17000 | -¥12000 | -¥12000 | 单价下调 | 雕塑加工
56 | 老皮黄锈石雕塑 D5 | 1200 × 1000 × 200 | 块 | 1 | ¥13000 | ¥13000 | ¥11000 | ¥11000 | -¥2000 | -¥2000 | 单价下调 | 加工
合计 |  |  |  |  |  | ¥219716 |  | ¥205716 |  | -¥14000 | 总体下降1.4万

Sheet: 关键变化项分析
里山墨石—阿那亚报价清单 (20260829 vs 20260830) 关键差异变动分析
序号 | 商品名称 | 规格尺寸 (mm) | 20260829 单价 | 20260830 单价 | 单价降幅 | 总价差额 (元) | 调整原因及优化分析
55 | 老皮黄锈石雕塑 D4 | 1600 × 1000 × 200 | ¥29000 | ¥17000 | -41.38% | -¥12000 | 大幅调低单价 (-41.38%)。该雕塑构件尺寸较宽，经过优化切割分板方案与加工工时核算后大幅让利 12,000 元。
56 | 老皮黄锈石雕塑 D5 | 1200 × 1000 × 200 | ¥13000 | ¥11000 | -15.38% | -¥2000 | 调低单价 (-15.38%)。结合 D4 构件整体工艺让利 2,000 元。
52 | 老皮黄锈石雕塑 D1 | 2340 × 600 × 200 | ¥15000 | ¥15000 | 0.00% | ¥0 | 保持 15,000 元总价不变（相比0624初始版26,000元大幅瘦身降价后，在0829与0830两版中维持稳定优惠价格）。
