streamy2008/jinshanling-yard-dashboard/20260624金山岭庭院合同/金山岭小院_9月3日现场交底智能BOM协同表.xlsx

Sheet: 9月3日现场交底SmartCheck
金山岭小院 9月3日四方现场交底与协同 Smart CheckList
会议时间: 2026-09-03 11:00 AM | 参会方: 业主、建筑设计(MINOR lab)、石材厂(里山墨石)、施工方(总包/钢构)、园林设计
模块分类 | 子项编号 | 核对/交底事项核心内容 | 涉及图纸/报价依据 | 责任确认方 | 现场实测数据 / 现场决定 | 状态评估 (下拉选择) | 整改/落实行动计划 | 预计完成时间 | 复核确认人
第一部分：现场测量、标高与地下隐蔽工程核对（现场实测与探摸）
现场测量 | 1.1 | 边界与定位轴线复核：依据建施A-1.1复核院墙边界、建筑边界及首层踏步起始点绝对尺寸。 | 建施 A-1.1 | 施工方 + 建筑设计 | 现场实测净宽___mm，较图纸偏差___mm | 未复核 | 图纸尺寸现场放线撒灰线确认 | 2026-09-03
现场测量 | 1.2 | 地下水井与井盖对接：核对原有水井、井筒顶标高及地下管线埋深，确认混凝土基座标高-0.030。 | 建施 A-1.2 | 施工方 + 园林设计 | 井筒顶标高实测___，需提高/降低___mm | 未复核 | 调整井筒标高，基座预留水泵控制器支架 | 2026-09-04
现场测量 | 1.3 | ±0.000标高与排水坡度：核对首层室内±0.000与庭院碎石铺地、水泥压光地面1%坡度走向。 | 建施 A-1.2 | 施工方 + 园林设计 | 坡度走向与水井井盖标高匹配 | 未复核 | 开挖坡度向井盖倾斜，避免积水倒灌 | 2026-09-05
现场测量 | 1.4 | 二层露台高差与反坎：核对一楼地面至二层露台(+3.090/+3.250)实际结构净高。 | 建施 A-1.3 | 施工方 + 建筑设计 | 实测二层露台底板标高为___ | 未复核 | 核算钢楼梯踏步步数与坡度 | 2026-09-03
第二部分：石材加工与 1:1 预制细节交底（里山墨石 18.8万元合同）
石材加工 | 2.1 | 水波纹大雕塑石(2800×1500×400)：确认水景边落位坐标与下方4.5吨承重垫层。 | 0830报价单#8 | 石材厂 + 建筑设计 | 落位坐标放线确认，下垫C25混凝土 | 未复核 | 施工方先打素混凝土垫层再吊装 | 2026-09-06
石材加工 | 2.2 | D1~D5雕塑与平台拆分板：确认D4(1600×1000×200)17000元优惠价及矿山选石照片。 | 0830报价单#55 | 石材厂 + 建筑设计 | 矿山毛料编号确认，三方拍照留存 | 未复核 | 里山墨石提供矿山选石高清图三方确认 | 2026-09-05
石材加工 | 2.3 | 黄锈石台阶与L型加工：核对13块定制台阶(600/1100长)与现场踏步基座预留50mm结合层。 | 0830报价单#20-21 | 石材厂 + 施工方 | 现场台阶基层尺寸留出50mm | 未复核 | 石材侧边做防碱背涂处理 | 2026-09-08
石材加工 | 2.4 | 灯具预留开孔/开槽：对照建施A-1.5/1.6，核对嵌入式防水射灯与地灯在石材上的工厂开槽。 | 建施 A-1.5/1.6 | 石材厂 + 园林设计 | 提供灯具开孔尺寸图(LT01/02) | 未复核 | 工厂预留灯槽，严禁现场强行打孔 | 2026-09-07
石材加工 | 2.5 | 厂内1:1试拼验收节点：约定里山墨石厂内1:1组装完成时间与线上视频验收流程。 | 里山墨石合同 | 石材厂 + 业主/设计 | 约定厂内1:1试拼完成日期为___ | 未复核 | 试拼验收合格后安排发货 | 2026-09-15
第三部分：钢楼梯平台、栏杆与施工工序衔接（施工方 & 钢构 5.78万元）
钢构平台 | 3.1 | 钢楼梯偏心柱脚基础(2.3万预算)：对照结施S-101，核对-120×160×16预埋钢板定位与300mm基础。 | 结施 S-101 | 施工方 + 建筑结构 | 预埋件中心坐标已打轴线定位 | 未复核 | 优先开挖浇筑钢柱脚基础 | 2026-09-05
钢构平台 | 3.2 | 主梁与踏步托板结构：核对150×100钢梁与5mm托板、石材底螺栓辅助固定方式。 | 结施 S-401 | 施工方 + 石材厂 | 石材底部预留螺栓定位眼 | 未复核 | 采用1mm专用胶+底部螺栓双重固定 | 2026-09-08
钢构平台 | 3.3 | 圆钢栏杆与杆件A/B(详图02)：核对Φ16圆钢与100×100×8钢板在墙侧的焊接点，避开视线。 | 详图02 P3-P9 | 施工方 + 建筑设计 | 圆钢焊缝打磨平整，隐蔽焊接 | 未复核 | 工厂预制杆件，现场螺栓/焊接组合 | 2026-09-10
钢构平台 | 3.4 | 防腐涂装标准：确认钢结构、栏杆、金属置物架全件采用黑色哑光氟碳喷涂(6000元预算)。 | 钢楼梯报价单 | 施工方 | 氟碳喷涂涂层厚度>40μm | 未复核 | 现场焊缝除锈后补二次氟碳漆 | 2026-09-12
第四部分：工序逻辑与防碰撞冲突控制
施工工序 | 4.1 | 工序1-管线探摸与撒灰线：施工方探摸地下水井管线，现场撒粉放线，确认零碰撞。 | 建施 A-1.2 | 施工方 | 地下管线无碰撞/有管线冲突 | 未复核 | 先探摸管线再机械开挖 | 2026-09-03
施工工序 | 4.2 | 工序2-钢柱脚基础&景石垫层浇筑：优先浇筑2.3万预算钢基础及水波纹石垫层，养护期7天。 | 结施 S-101 | 施工方 | 混凝土基座养护期排期___天 | 未复核 | 严禁先铺景观石后做基础 | 2026-09-04
施工工序 | 4.3 | 工序3-钢楼梯主骨架吊装：150×100钢梁及二层平台框架整体安装到位。 | 结施 S-201 | 施工方 | 钢框架安装垂直度<2mm | 未复核 | 校正钢梁水平度与标高 | 2026-09-10
施工工序 | 4.4 | 工序4-石材进场与吊装铺贴：18.8万元石材进场，随车吊落位，铺设黄锈石与中国黑景石。 | 0830报价单 | 石材厂 + 施工方 | 吊装使用柔性吊带保护石角 | 未复核 | 成品表面覆盖珍珠棉保护 | 2026-09-16

Sheet: 施工进度与资金里程碑
金山岭小院 施工进度与资金解封里程碑甘特表 (WBS Timeline)
WBS阶段编号 | 工序 / 节点名称 | 责任主导方 | 计划开始时间 | 计划完成时间 | 工期(天) | 关联合同 / 资金解封节点 | 解封金额(元) | 前置依赖工序 | 节点状态
WBS-01 | 现场放线与地下管线探摸 | 施工方 | 2026-09-03 | 2026-09-03 | 1 | 准备阶段 | ¥0 | 无 | 待执行
WBS-02 | 里山墨石合同签署与预付款 | 业主 + 石材厂 | 2026-09-03 | 2026-09-04 | 1 | 石材合同首期定金 (30%) | ¥56400 | WBS-01 | 待执行
WBS-03 | 钢楼梯柱脚基础&景石垫层浇筑 | 施工方 | 2026-09-04 | 2026-09-06 | 2 | 钢楼梯基础预付款 (30%) | ¥17340 | WBS-01 | 待执行
WBS-04 | 矿山选石照片三方确认 | 石材厂 + 设计方 | 2026-09-04 | 2026-09-06 | 2 | 石材选型节点 | ¥0 | WBS-02 | 待执行
WBS-05 | 混凝土基础7天养护期 | 施工方 | 2026-09-06 | 2026-09-12 | 7 | 基础完工节点 | ¥0 | WBS-03 | 待执行
WBS-06 | 钢楼梯主骨架&平台框架安装 | 施工方 | 2026-09-10 | 2026-09-12 | 2 | 钢楼梯中期进度款 (40%) | ¥23120 | WBS-05 | 待执行
WBS-07 | 里山墨石厂内 1:1 试拼验收 | 石材厂 + 业主/设计 | 2026-09-12 | 2026-09-14 | 2 | 石材尾款支付节点 (70%) | ¥131600 | WBS-04 | 待执行
WBS-08 | 石材进场、吊装与铺贴 | 石材厂 + 施工方 | 2026-09-15 | 2026-09-18 | 3 | 石材到场节点 | ¥0 | WBS-06, WBS-07 | 待执行
WBS-09 | 圆钢栏杆焊接与氟碳漆补漆 | 施工方 | 2026-09-18 | 2026-09-20 | 2 | 钢楼梯尾款 (30%) | ¥17340 | WBS-08 | 待执行
WBS-10 | 暗敷灯具线路接通与整体验收 | 全员 | 2026-09-20 | 2026-09-22 | 2 | 项目整体验收款 | ¥0 | WBS-09 | 待执行

Sheet: 造价与资金穿透看板
金山岭小院 项目合同造价与资金穿透看板
合同模块 | 乙方/责任单位 | 初始报价(元) | 最终确认合同金额(元) | 已付金额(元) | 未付尾款(元) | 当前支付阶段 | 备注说明
景观石材与艺术雕塑 | 里山墨石 (汤) | ¥207773.16 | ¥188000.00 | ¥0.00 | ¥188000.00 | 待签署合同并付30%定金 | 含56项石材，优惠价18.8万元
钢楼梯平台全包 | 施工方/钢构团队 | ¥57800.00 | ¥57800.00 | ¥0.00 | ¥57800.00 | 待开工付基础启动款 | 含钢梁、栏杆、氟碳漆及2.3万混凝土基础
现场物流与吊装预备费 | 第三方物流/吊装 | ¥20000.00 | ¥18000.00 | ¥0.00 | ¥18000.00 | 按实结算 | 预留随车吊与卸车人工预算
合计 | — | ¥285573.16 | ¥263800.00 | ¥0.00 | ¥263800.00 | 项目总预算控制在26.38万元内 | 造价立减21,773元
