streamy2008/jinshanling-yard-dashboard/20260624金山岭庭院合同/金山岭小院_完整施工与采购工程量清单汇总表.xlsx

Sheet: 全项目综合清单汇总
金山岭小院 建筑装置与园林景观 完整综合施工与采购工程量清单
编制日期: 2026-08-30 | 依据文件: 《01_施工图纸》《02_栏杆详图》《0830里山墨石清单》《钢楼梯报价单》
模块分类 | 工程项目 / 构件内容 | 核心规格与技术参数 | 计量单位 | 工程量 | 最终确认单价(元) | 合价金额(元) | 预估重量(吨) | 图纸/报价依据文件 | 现场施工与安装节点说明
一、里山墨石 - 景观石材与艺术雕塑供货清单（已议定最终总价：188,000 元）
1.1 石材供货 | 中国黑水波纹大雕塑石 (#8) | 2800×1500×400 mm (水波纹加工) | 块 | 1 | ¥30000 | ¥30000 | 4.54 | 0830报价单#8 | 4.54吨超重单件，需100吨吊车吊装，下垫C25混凝土垫层
1.2 石材供货 | 中国黑景石群 (#1~#9) | 如 #1: 1600×1300×500, #5: 1250×500×600 等 | 块 | 11 | ¥800 | ¥10200 | 7.08 | 0830报价单#3-13 | 背切平、合缝加工，与水景/景墙贴合落位
1.3 石材供货 | 中国黑石皮与内凹雕塑石 | 石皮: 1000×600×30-80mm; 雕塑: 200×200×350 | m²/块 | 8.50 | ¥1800 | ¥13900 | 1.48 | 0830报价单#1,10 | 水景立面与景墙贴皮饰面，挂贴/粘结固定
1.4 石材供货 | 黄锈石/太行金雕塑群 (D1~D5) | D4: 1600×1000×200; D1: 2340×600×200 等 | 块 | 5 | ¥9700 | ¥48800 | 2.62 | 0830报价单#52-56 | D4优惠至1.7万元，深化分板，平台侧面及立面安装
1.5 石材供货 | 黄锈石雕塑构件群 (A/B/C组) | 含A1~A4, B1~B7, C1~C10 共有 21 件构件 | 块 | 21 | ¥2600 | ¥54600 | 3.08 | 0830报价单#29-51 | 按照设计图纸组合装配，厂内1:1试拼验收后发货
1.6 石材供货 | 太行金大踏步板与老皮地铺 | 踏步板: 2700×600×100; 地铺: 1800×500×80 | m²/块 | 13.70 | ¥1200 | ¥22684 | 4.88 | 0830报价单#2,14-19 | 1:3干硬性砂浆铺贴，防碱背涂，结合层留50mm
1.7 石材供货 | 黄锈石定制台阶与拆分平台板 | 台阶: 600/1100×270×200; 平台: 7块分板 | m²/块 | 18.00 | ¥1800 | ¥25532 | 1.70 | 0830报价单#20-28 | L型加工台阶，平台板底部螺栓+1mm专用胶固定
1.8 石材让利 | 里山墨石合同议定总价让利 | 全包56项石材构件整单优惠 | 项 | 1 | -¥17716 | -¥17716 | 0.00 | 里山墨石商务谈判 | 初始小计205,716元，议定最终含税总结算价为 188,000 元
二、钢楼梯平台与建筑装置全包清单（已议定最终总价：57,800 元）
2.1 钢结构平台 | 主结构钢梁与踏步托板 | 150×100 矩形钢管主梁 + 5mm 钢托板 | 项 | 1 | ¥12500 | ¥12500 | 1.20 | 钢楼梯报价单/结施 | 连接一楼与二层露台，焊缝打磨平整，承重石材踏步
2.2 钢结构平台 | 钢构件厂内加工与下料 | 矩形钢管切割、坡口焊接与拼装 | 项 | 1 | ¥30000 | ¥3000 | 0.00 | 钢楼梯报价单 | 依据结施 S-401/402 节点详图下料加工
2.3 金属构件 | 圆钢栏杆 1~5 与杆件 A/B | Φ16mm 圆钢 + 5/10mm 扁钢 + 100×100×8 钢板 | 项 | 1 | ¥3500 | ¥3500 | 0.35 | 详图 02 P3-P9 | 隐蔽焊接，避开视线，挂布帘/竹帘
2.4 金属构件 | 定制金属置物架 | 30×30mm 方钢/角钢 + 金属冲孔网板 | 项 | 1 | ¥2800 | ¥2800 | 0.15 | 详图 02 P10-11 | 底端连接至-0.030，与水井顶齐平，侧面隐蔽固定
2.5 防腐涂装 | 黑色哑光氟碳喷涂 | 全件除锈 + 氟碳底漆/面漆 (>40μm) | 项 | 1 | ¥6000 | ¥6000 | 0.00 | 钢楼梯报价单 | 工厂预喷涂，现场焊缝除锈后做二次氟碳漆补漆
2.6 现场安装 | 钢结构平台与栏杆现场吊装安装 | 现场定位、预埋件焊接与螺栓紧固 | 项 | 1 | ¥7000 | ¥7000 | 0.00 | 钢楼梯报价单 | 配吊装机械与焊工，与石材安装交错配合
2.7 隐蔽工程 | 偏心柱脚基础与混凝土垫层浇筑 | 300mm厚C25混凝土基础 + -120×160×16埋件 | 项 | 1 | ¥23000 | ¥23000 | 8.50 | 结施 S-101 基础图 | 优先开挖浇筑，养护7天后再铺设周边景石与台阶
三、长途物流与现场大吨位吊装工程量预备清单（预估金额：18,000 元）
3.1 跨省运输 | 石材长途卡车运输 | 13.5米高栏/平板卡车 (河北厂 ➔ 阿那亚) | 趟 | 1 | ¥4500 | ¥4500 | 24.34 | 物流市场行情 | 运载24.34吨石材，中间垫珍珠棉，木托盘固定
3.2 现场吊装 | 100吨大吨位汽车吊台班 | 100吨汽车吊 (工作半径 25 米) | 台班 | 1 | ¥8500 | ¥8500 | 0.00 | 起重力矩核算 | 吊装 4.54吨水波纹大石至25m远处，含进出场调车费
3.3 吊装辅助 | 专业卸车/吊装指挥与柔性吊具 | 高强柔性吊带 + 3名专业吊装信号工 | 项 | 1 | ¥2500 | ¥2500 | 0.00 | 现场施工安全 | 严禁用钢丝绳，保护石角，现场溜绳微调落位
3.4 二次运送 | 现场短驳与成品保护预备 | 小履带车/手动液压车 + 珍珠棉保护板 | 项 | 1 | ¥2500 | ¥2500 | 0.00 | 成品保护 | 场地狭窄区域石材二次短驳与铺贴后覆盖防护
全项目工程总计 |  |  |  |  |  | ¥263800 | 34.38 |  | 造价锁定在 26.38 万元，含石材、钢构、基础与25米大吊车服务

Sheet: 里山墨石56项石材加工明细
里山墨石 56项石材采购、几何尺寸、加工要求与单件重量明细表
序号 | 商品名称 | 长(mm) | 宽(mm) | 高/厚(mm) | 单位 | 工程量 | 单价(元) | 0830原总价(元) | 单件重量(kg) | 总重量(吨) | 加工要求 / 说明
1 | 中国黑石皮 | 1000左右 | 600以内 | 30-80 | m2 | 6.50 | ¥1800 | ¥11700 | 148.5 | 0.97 | 加工
2 | 太行金踏步板 | 2700 | 600 | 100 | 块 | 1.00 | ¥5000 | ¥5000 | 437.4 | 0.44 | 整板加工
3 | 中国黑景石#1 | 1600 | 1300 | 500 | 块 | 1.00 | ¥2000 | ¥2000 | 2808.0 | 2.81 | 不加工
4 | 中国黑景石#2 | 1100 | 700 | 350 | 块 | 1.00 | ¥1500 | ¥1500 | 727.6 | 0.73 | 加工
5 | 中国黑景石#3 | 530 | 400 | 550 | 块 | 1.00 | ¥600 | ¥600 | 314.8 | 0.31 | 加工，切角， 合缝
6 | 中国黑景石#4 | 580 | 300 | 250 | 块 | 1.00 | ¥500 | ¥500 | 117.5 | 0.12 | 加工，合缝
7 | 中国黑景石#5 | 1250 | 500 | 600 | 块 | 1.00 | ¥2000 | ¥2000 | 1012.5 | 1.01 | 背切平，加工 合缝
8 | 中国黑雕塑石 | 2800 | 1500 | 400 | 块 | 1.00 | ¥30000 | ¥30000 | 4536.0 | 4.54 | 水波纹雕塑加 工
9 | 中国黑景石#6 | 650 | 330 | 250 | 块 | 1.00 | ¥600 | ¥600 | 144.8 | 0.14 | 加工，切角，
10 | 中国黑雕塑石 | 200 | 200 | 350 | 块 | 2.00 | ¥1100 | ¥2200 | 37.8 | 0.08 | 内凹磨光雕塑 景石
11 | 中国黑景石#7 | 600 | 600 | 350 | 块 | 1.00 | ¥700 | ¥700 | 340.2 | 0.34 | 加工，切角， 合缝
12 | 中国黑景石#8 | 600 | 500 | 500 | 块 | 1.00 | ¥800 | ¥800 | 405.0 | 0.41 | 加工，切角， 合缝
13 | 中国黑景石#9 | 650 | 500 | 200 | 块 | 1.00 | ¥800 | ¥800 | 175.5 | 0.18 | 加工切底
14 | 黄绣石地铺 老皮拉槽面穿插 | 1300 | 800 | 80 | m2 | 4.14 | ¥1000 | ¥4140 | 216.0 | 0.89 | 加工
15 | 黄绣石桥面 老皮拉槽面穿插 | 1400 | 800 | 130 | m2 | 1.03 | ¥1600 | ¥1648 | 351.0 | 0.36 | 两块拼接蝴蝶 榫 底部内凹 50*50凹槽
16 | 黄绣石入户踏步 老皮拉槽面穿插 | 1600 | 1070 | 180 | m2 | 1.69 | ¥2200 | ¥3718 | 486.0 | 0.82 | 加工
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
55 | 老皮黄锈石雕塑 D4 | 1600 | 1000 | 200 | 块 | 1.00 | ¥17000 | ¥17000 | 864.0 | 0.86 | 雕塑加工
56 | 老皮黄锈石雕塑 D5 | 1200 | 1000 | 200 | 块 | 1.00 | ¥11000 | ¥11000 | 648.0 | 0.65 | 加工
小计/合计 |  |  |  |  |  |  |  | ¥205716 |  | 24.34 | 商务议定最终优惠价：188,000 元
