streamy2008/jinshanling-yard-dashboard/(list of files, cad)

Other CAD files:
20260624金山岭庭院合同/01-2_结构专业施工图_202607.dwg
20260624金山岭庭院合同/01-3_原始图纸_院内排水平面图.dwg
20260624金山岭庭院合同/01-1_建筑专业施工图_202607.dwg
