streamy2008/jinshanling-yard-dashboard/20260624金山岭庭院合同/01_施工图纸_金山岭庭院装置项目_202607_.pdf

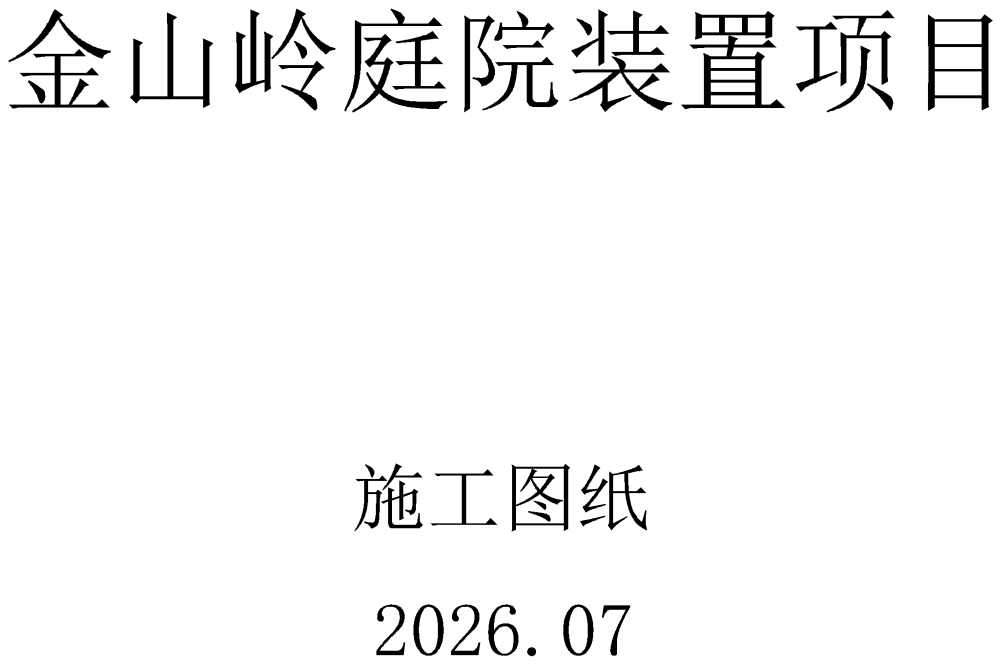
[picture p28: page 1]
金山岭庭院装置项目 2026.07 施工图纸

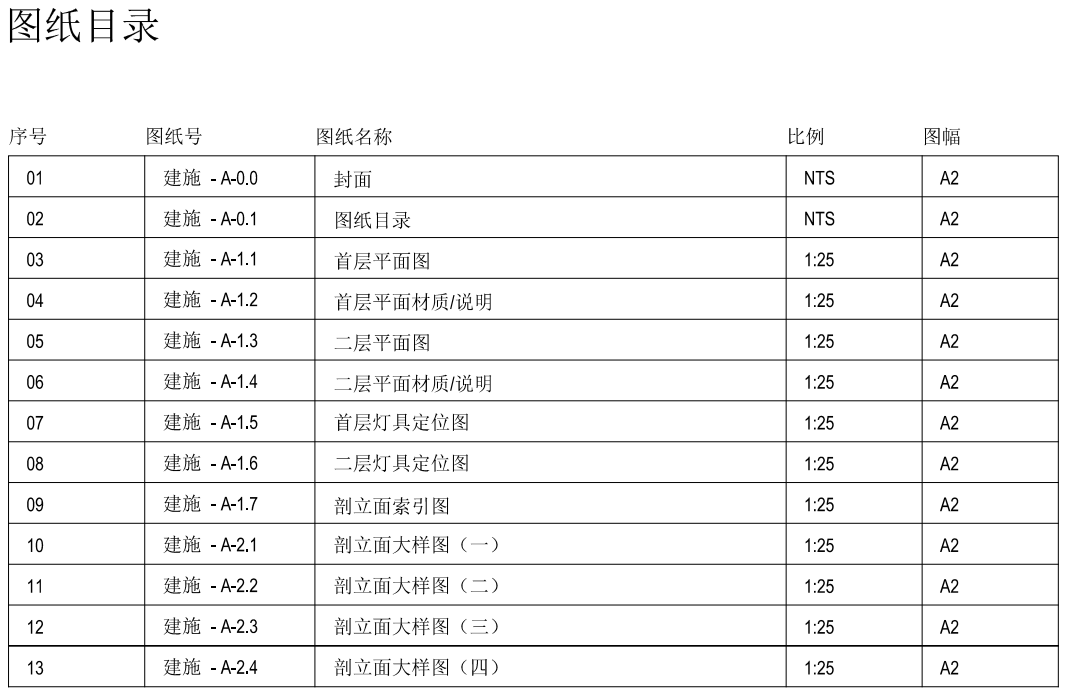
[picture p29: page 2]
建施 - A-0.1 图纸号; 图纸名称; 图幅 图纸目录; 建施 - A-1.6 图纸目录; 二层灯具定位图 首层灯具定位图 建施 - A-0.0; 首层平面材质

序号01020304050607080910111213 | 建施 - A-1.1 建施 - A-1.3 | 首层平面图 二层平面图 二层平面材质 /说明 | NTS 1:25 | A2 建施 - A-1.4 建施 - A-1.5

剖立面大样图（一） 剖立面大样图（二） 建施 - A-2.3 剖立面大样图（三） 建施 - A-2.4 剖立面大样图（四） | NTS | A2A2A2A2A2A2A2A2A2A2A2A2 1:25 1:25 1:25 1:25 1:25 1:25 1:25 1:25 1:25 1:25 建施 - A-2.2

剖立面索引图

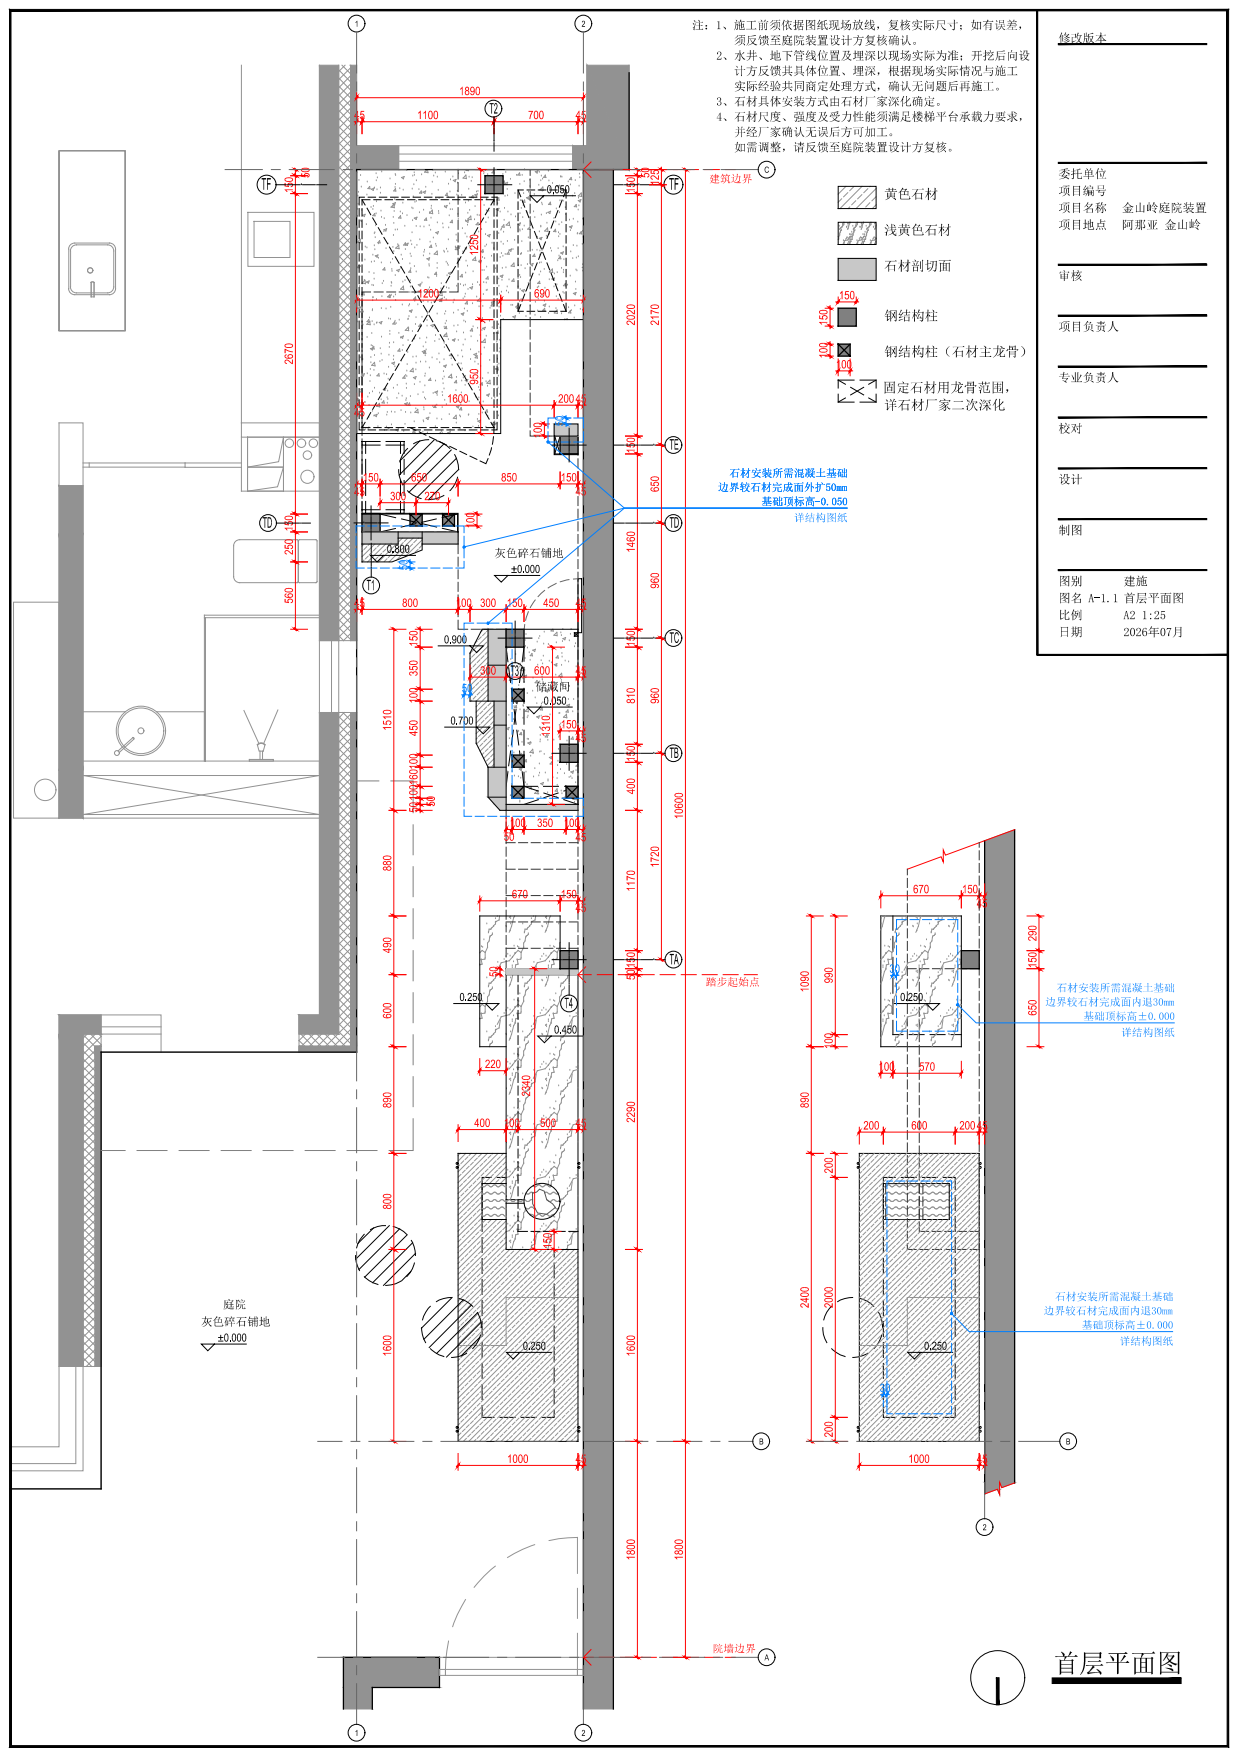
[picture p30: page 3]
A2 1:25 修改版本 图别; 金山岭庭院装置 阿那亚 金山岭; 储藏间 1; CBA; 50 10045 100 350 50 45 石材安装所需混凝土基础; 如需调整，请反馈至庭院装置设计方复核。; A-1.1 首层平面图 详结构图纸; 详结构图纸 TDTATBTCTETF T2 T1; T4 TDTF

注：1、施工前须依据图纸现场放线，复核实际尺寸；如有误差，

须反馈至庭院装置设计方复核确认。
2、水井、地下管线位置及埋深以现场实际为准；开挖后向设
计方反馈其具体位置、埋深，根据现场实际情况与施工
实际经验共同商定处理方式，确认无问题后再施工。
3、石材具体安装方式由石材厂家深化确定。
4、石材尺度、强度及受力性能须满足楼梯平台承载力要求，
并经厂家确认无误后方可加工。

950 1250 0.250 0.450 0.250 0.700 0.900 0.800 0.050 0.050 1310 ±0.000 庭院 灰色碎石铺地 ±0.000 灰色碎石铺地 0.250 0.250 150

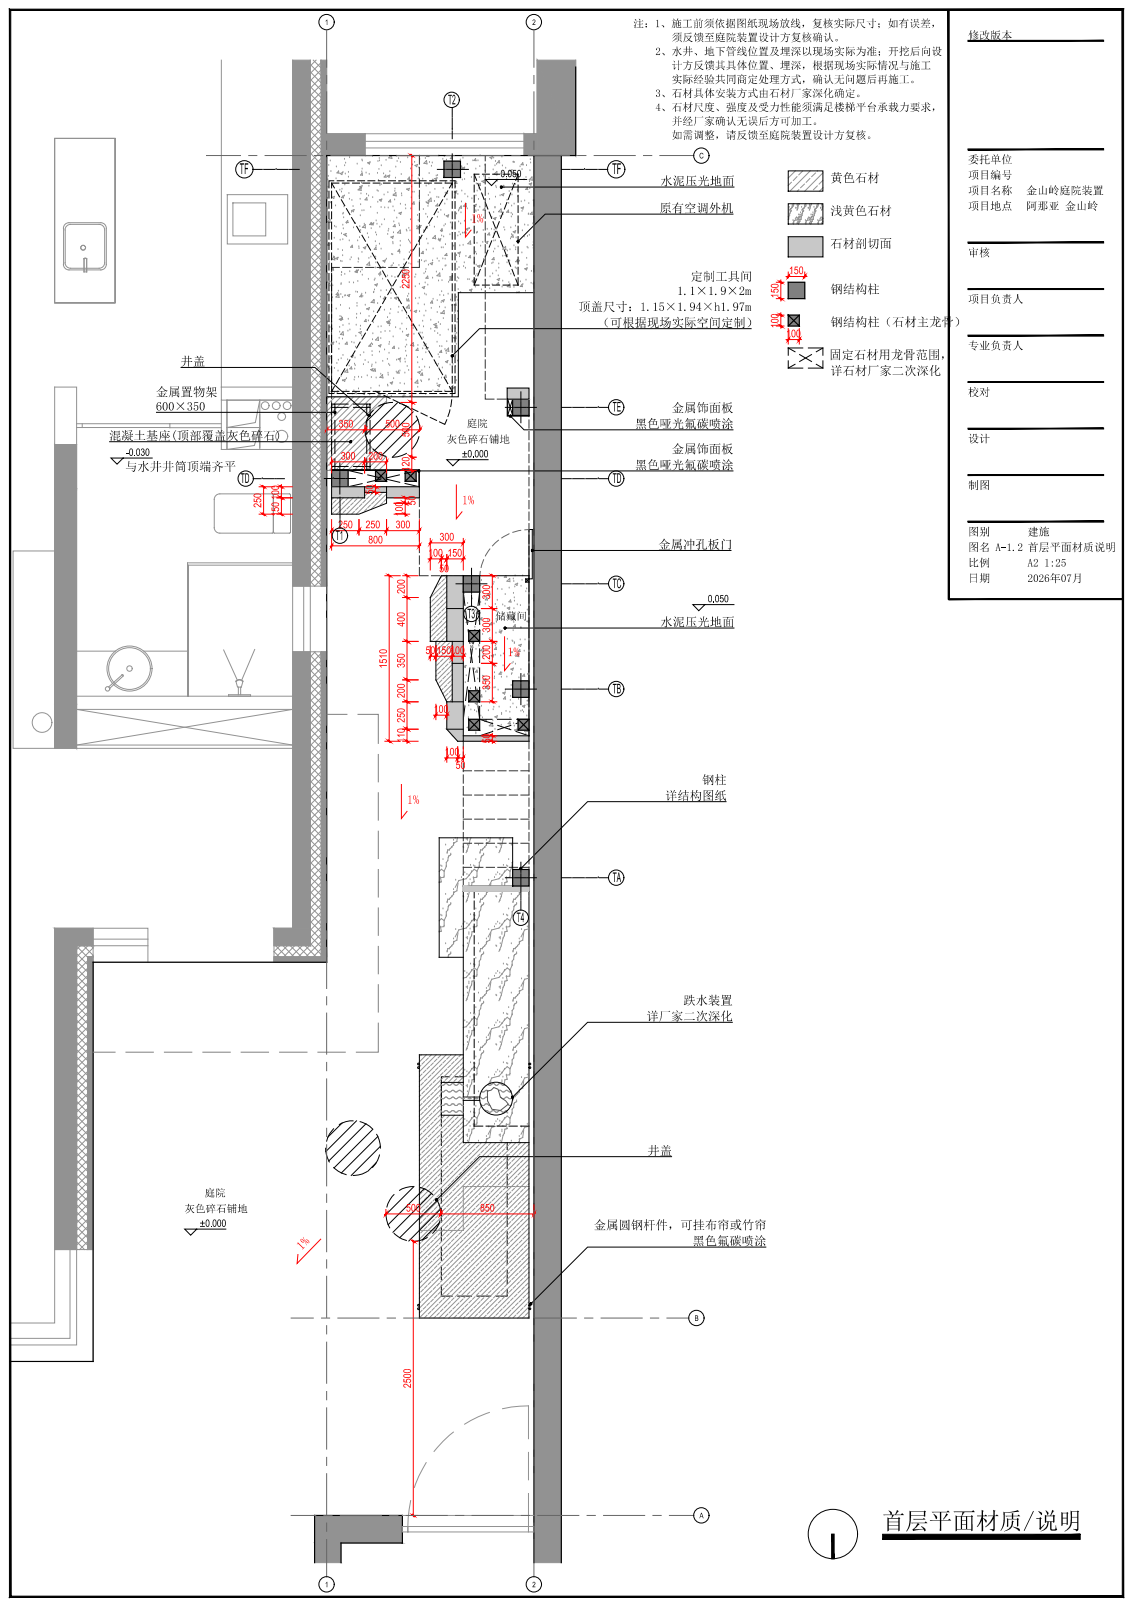
[picture p31: page 4]
定制工具间 1.1×1.9×2m 顶盖尺寸：1.15×1.94×h1.97m; 灰色碎石铺地; 0.050 金属置物架 600×350; 金属冲孔板门; 水泥压光地面 1% 1% 1%; 0.050 ±0.000 庭院 灰色碎石铺地

300 300 200 350 50 150 10050 100 50 100 50150 100300 委托单位 项目编号 项目名称 项目地点 图名比例日期 2026年07月 审核项目负责人 专业负责人 校对设计制图 A2 1:25 修改版本 图别 金山岭庭院装置 阿那亚 金山岭 1% 储藏间 1 2 1 2 CBA 混凝土基座(顶部覆盖灰色碎石) -0.030 与水井井筒顶端齐平 注：1、施工前须依据图纸现场放线，复核实际尺寸；如有误差， 须反馈至庭院装置设计方复核确认。 2、水井、地下管线位置及埋深以现场实际为准；开挖后向设 计方反馈其具体位置、埋深，根据现场实际情况与施工 实际经验共同商定处理方式，确认无问题后再施工。 3、石材具体安装方式由石材厂家深化确定。 4、石材尺度、强度及受力性能须满足楼梯平台承载力要求， 并经厂家确认无误后方可加工。 如需调整，请反馈至庭院装置设计方复核。 A-1.2 首层平面材质说明 TDTATBTCTETF T2 T1 T3 T4 TDTF 建施
黑色哑光氟碳喷涂 850

2250 500 120 500 井盖 井盖 1% 水泥压光地面

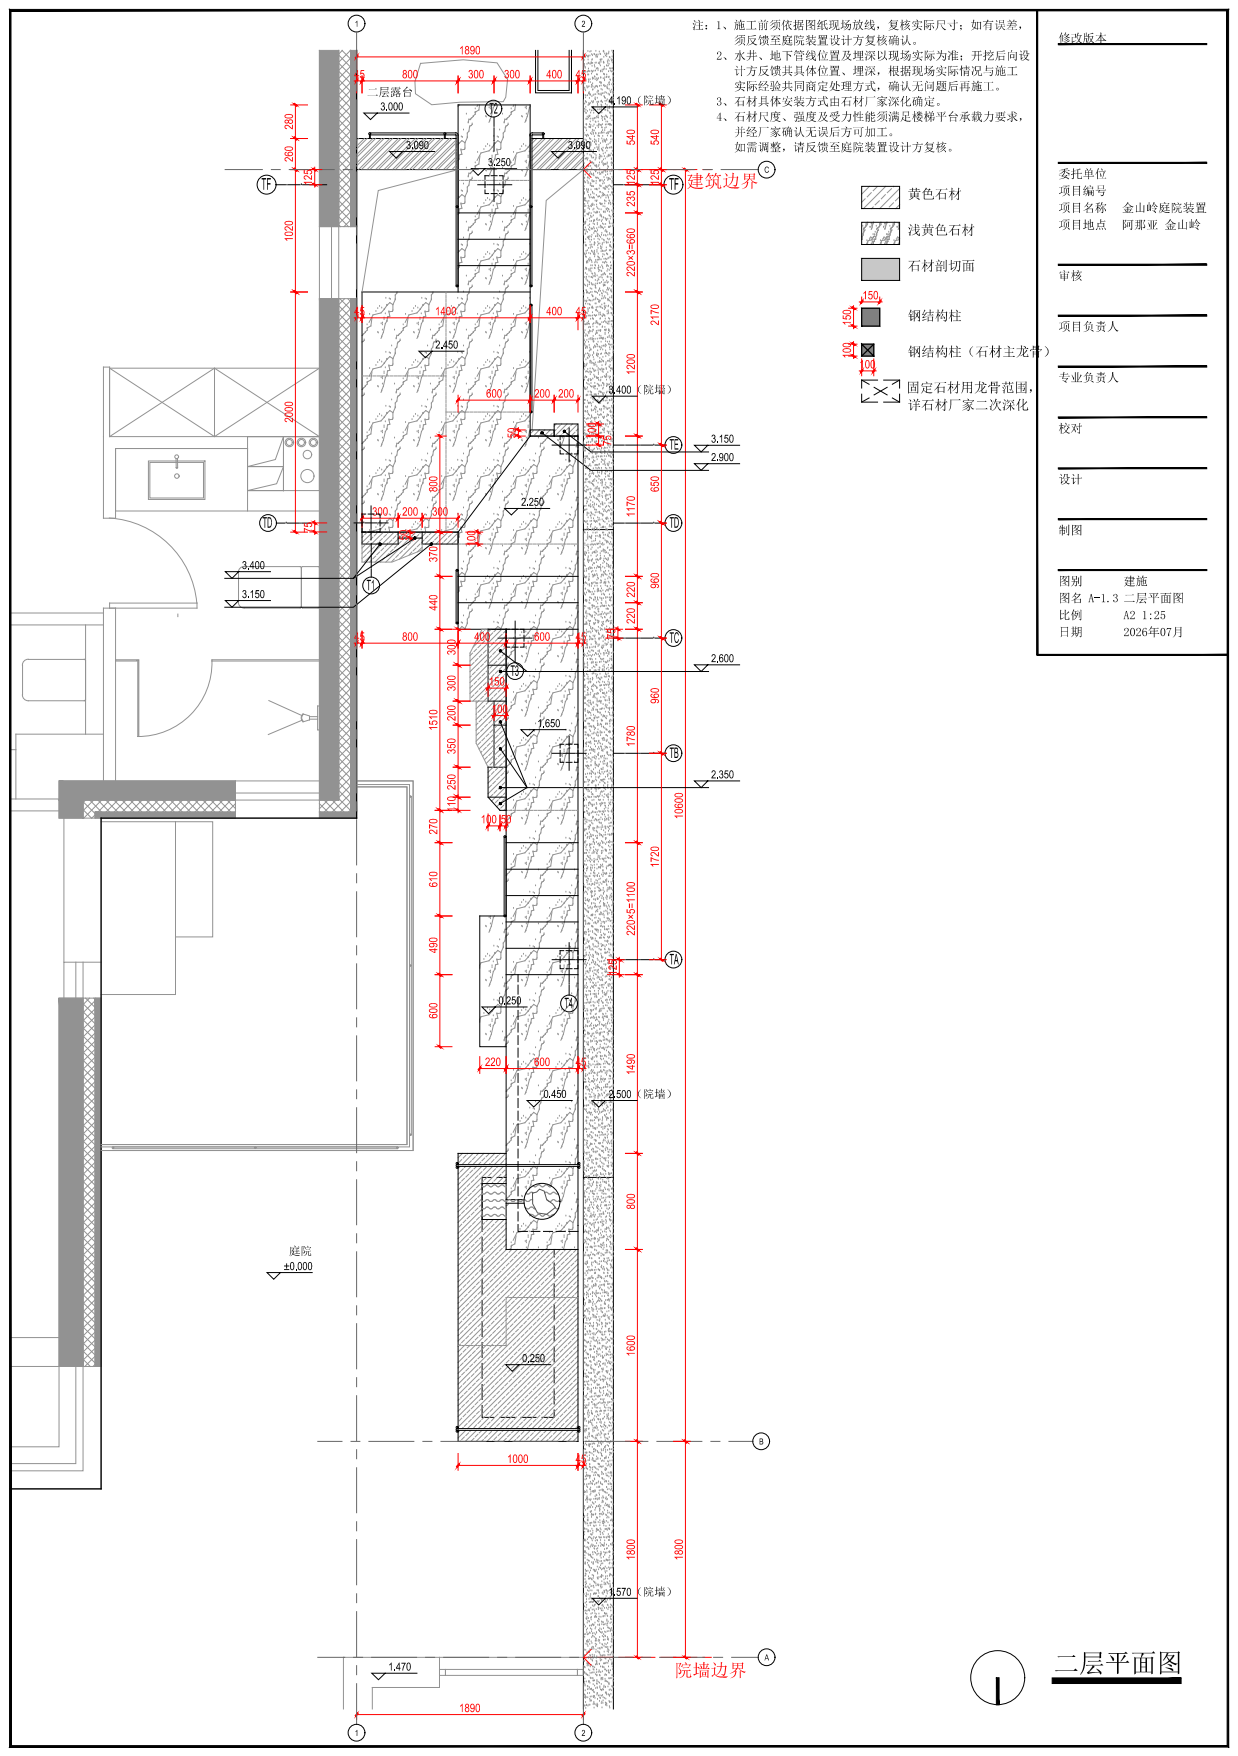
[picture p32: page 5]
A2 1:25 修改版本 图别; 金山岭庭院装置 阿那亚 金山岭 0.450 0.2501.650 2.250 2.450; 600 490 600 45 二层露台 2.350 100 50 100 300 200 300; 二层平面图 1.570（院墙） 4.190（院墙） 2.500（院墙） 3.400（院墙） 1890 1; CBA 注：1、施工前须依据图纸现场放线，复核实际尺寸；如有误差， 须反馈至庭院装置设计方复核确认。 2、水井、地下管线位置及埋深以现场实际为准；开挖后向设 计方反馈其具体位置、埋深，根据现场实际情况与施工 实际经验共同商定处理方式，确认无问题后再施工。 3、石材具体安装方式由石材厂家深化确定。 4、石材尺度、强度及受力性能须满足楼梯平台承载力要求， 并经厂家确认无误后方可加工。 如需调整，请反馈至庭院装置设计方复核。; A-1.3 二层平面图 TDTATBTCTETF T2 T1; T4 TDTF

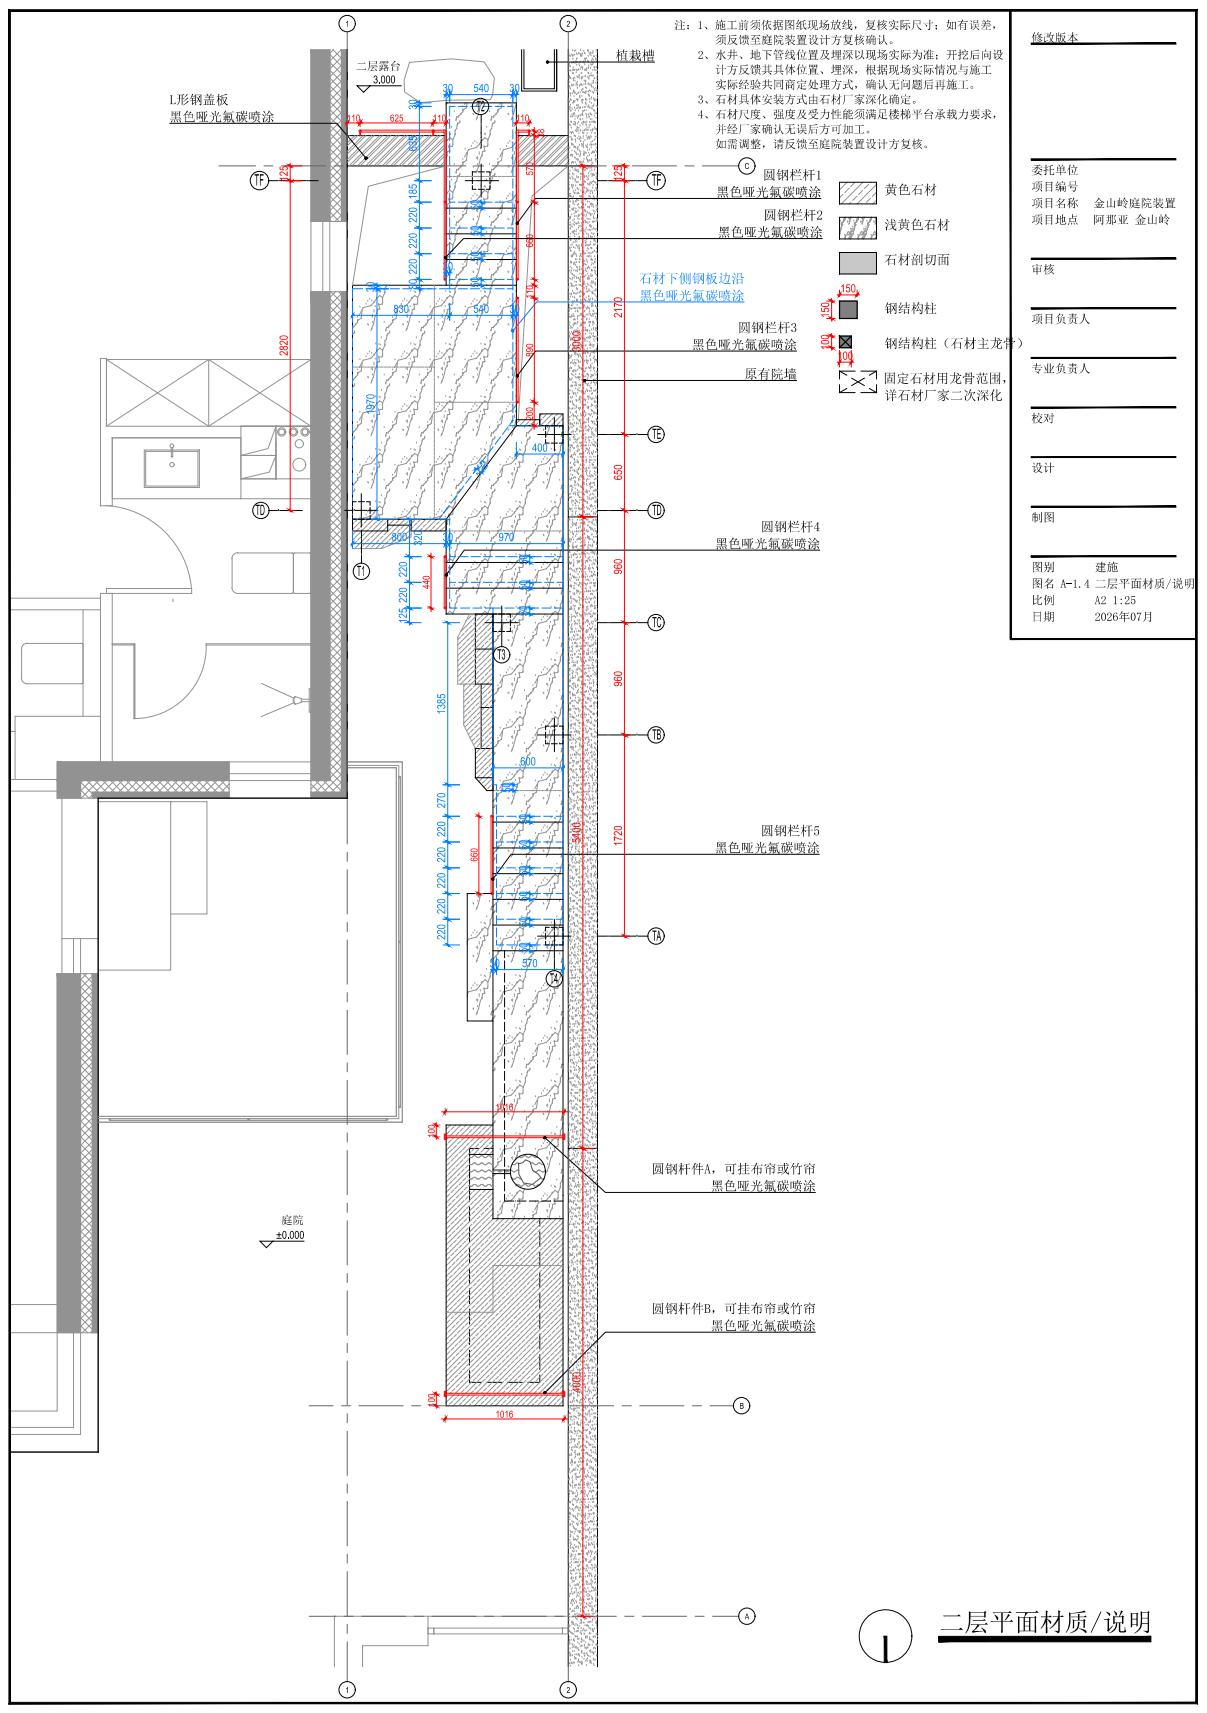
[picture p33: page 6]
二层平面材质/说明 30 3.000 1; CBA; 如需调整，请反馈至庭院装置设计方复核。; A-1.4 二层平面材质/说明 TDTATBTCTETF T2 T1; T4 TDTF

注：1、施工前须依据图纸现场放线，复核实际尺寸；如有误差，

50 50 30 委托单位 项目编号 项目名称 项目地点 图名比例日期 2026年07月 审核项目负责人 专业负责人 校对设计制图 A2 1:25 修改版本 图别 金山岭庭院装置 阿那亚 金山岭

须反馈至庭院装置设计方复核确认。
2、水井、地下管线位置及埋深以现场实际为准；开挖后向设
计方反馈其具体位置、埋深，根据现场实际情况与施工
实际经验共同商定处理方式，确认无问题后再施工。
3、石材具体安装方式由石材厂家深化确定。
4、石材尺度、强度及受力性能须满足楼梯平台承载力要求，
并经厂家确认无误后方可加工。

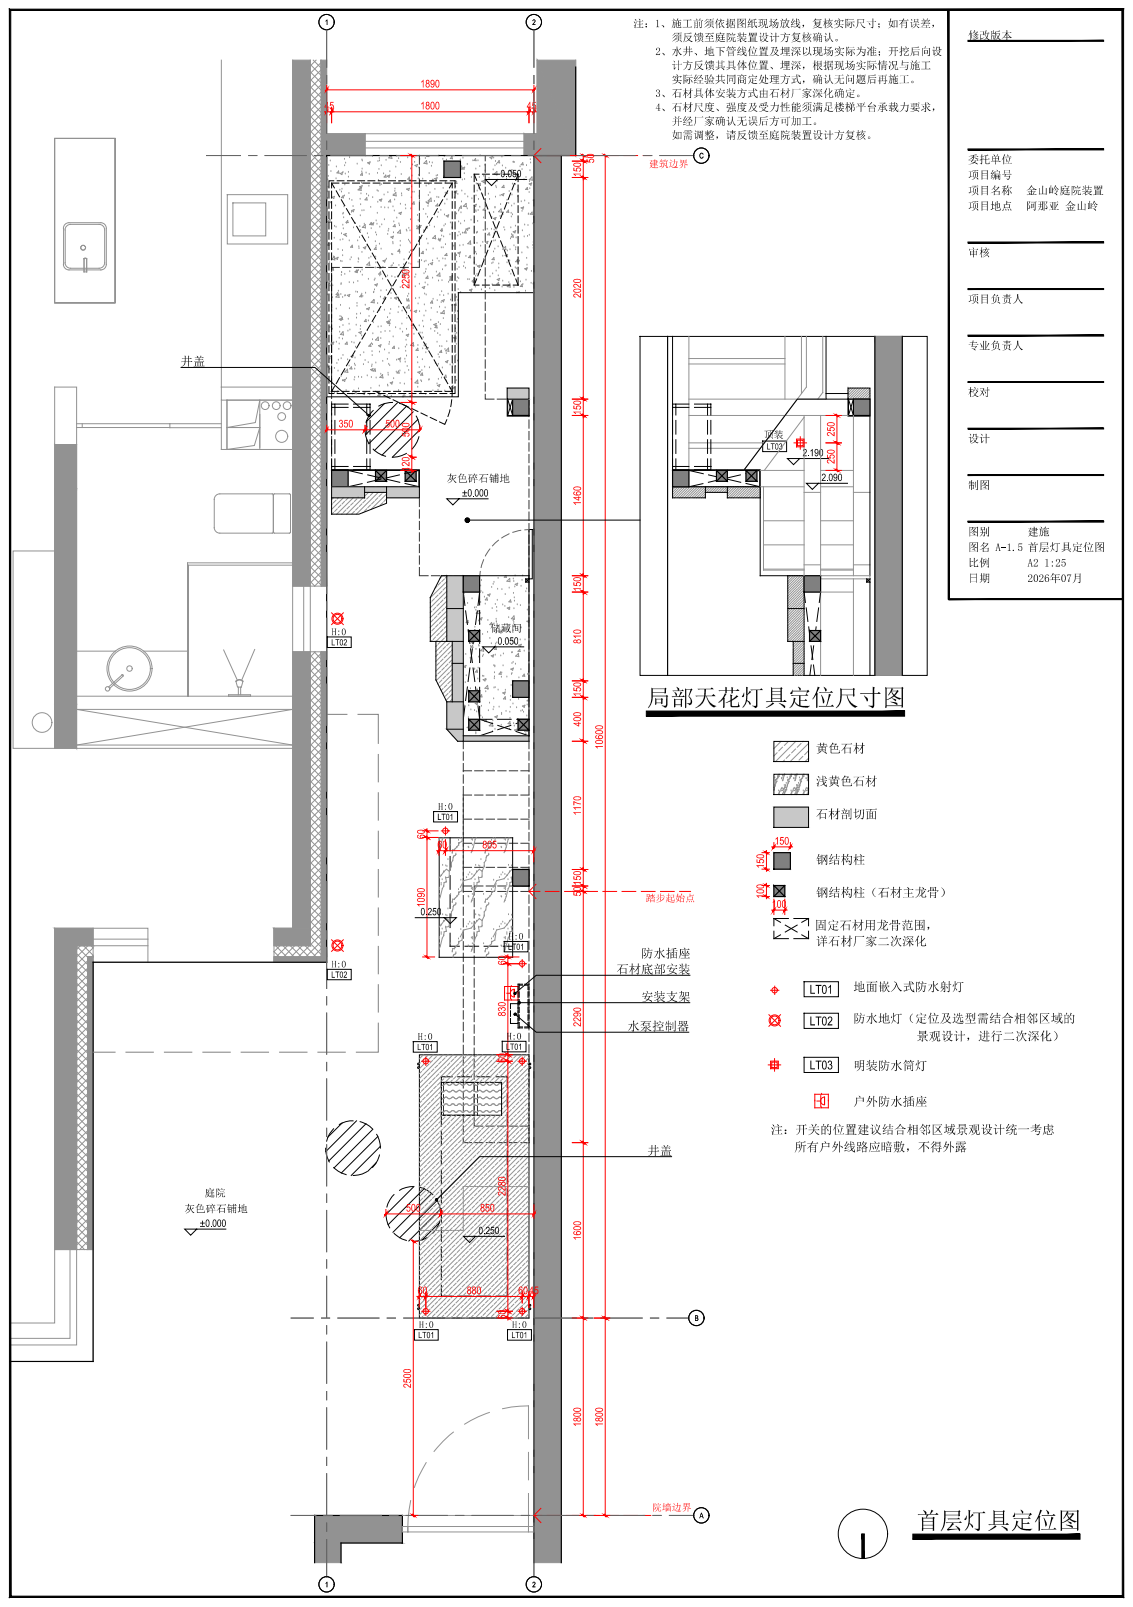
[picture p34: page 7]
CBA; 顶装LT03; 首层灯具定位图 2.190 局部天花灯具定位尺寸图; A2 1:25 修改版本 图别; 金山岭庭院装置 阿那亚 金山岭; 储藏间 1; 钢结构柱（石材主龙骨） LT03; 明装防水筒灯 LT02; 防水地灯（定位及选型需结合相邻区域的 LT01; 地面嵌入式防水射灯 景观设计，进行二次深化）; 如需调整，请反馈至庭院装置设计方复核。; A-1.5 首层灯具定位图 0.250 0.250; 院墙边界 建筑边界 踏步起始点

注：1、施工前须依据图纸现场放线，复核实际尺寸；如有误差，

须反馈至庭院装置设计方复核确认。
2、水井、地下管线位置及埋深以现场实际为准；开挖后向设
计方反馈其具体位置、埋深，根据现场实际情况与施工
实际经验共同商定处理方式，确认无问题后再施工。
3、石材具体安装方式由石材厂家深化确定。
4、石材尺度、强度及受力性能须满足楼梯平台承载力要求，
并经厂家确认无误后方可加工。

50 150 400 0.050 0.050 ±0.000 庭院 灰色碎石铺地 ±0.000 灰色碎石铺地

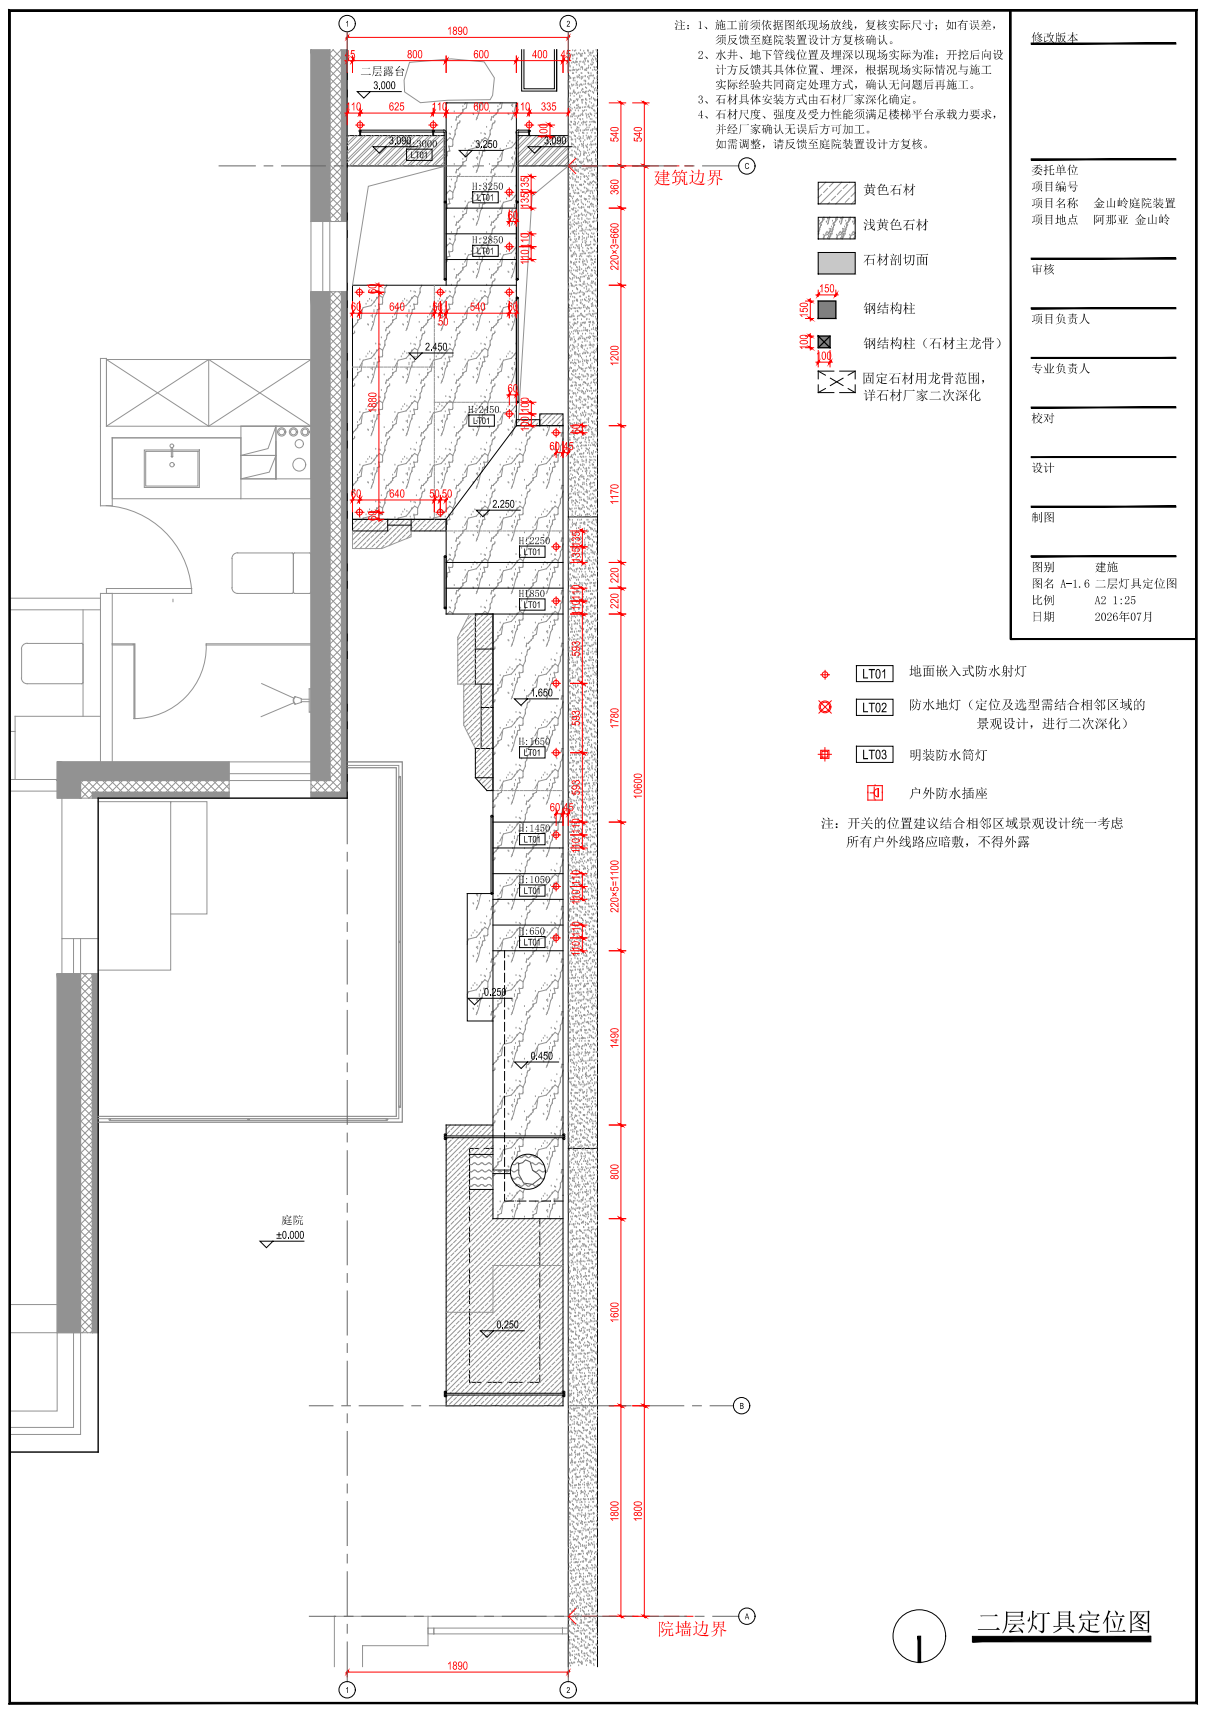
[picture p35: page 8]
A2 1:25 修改版本 图别; 金山岭庭院装置 阿那亚 金山岭 3.000 ±0.000 庭院; 如需调整，请反馈至庭院装置设计方复核。; A-1.6 二层灯具定位图 0.450 0.250 1.650 2.250 2.450

10600 540 800 600 400 1890 45 45 二层露台 1890 1 2 1 2 CBA 二层灯具定位图 LT03 明装防水筒灯 LT02 防水地灯（定位及选型需结合相邻区域的 LT01 地面嵌入式防水射灯 景观设计，进行二次深化） 注：开关的位置建议结合相邻区域景观设计统一考虑 户外防水插座 所有户外线路应暗敷，不得外露 H:650 LT01 H:1050 LT01 H:1450 LT01 H:1650 LT01 H:2250 LT01 H:2450 LT01 H:2850 LT01 H:3250 LT01 H:3000 LT01 H1850 LT01 60 45

注：1、施工前须依据图纸现场放线，复核实际尺寸；如有误差，

须反馈至庭院装置设计方复核确认。
2、水井、地下管线位置及埋深以现场实际为准；开挖后向设
计方反馈其具体位置、埋深，根据现场实际情况与施工
实际经验共同商定处理方式，确认无问题后再施工。
3、石材具体安装方式由石材厂家深化确定。
4、石材尺度、强度及受力性能须满足楼梯平台承载力要求，
并经厂家确认无误后方可加工。

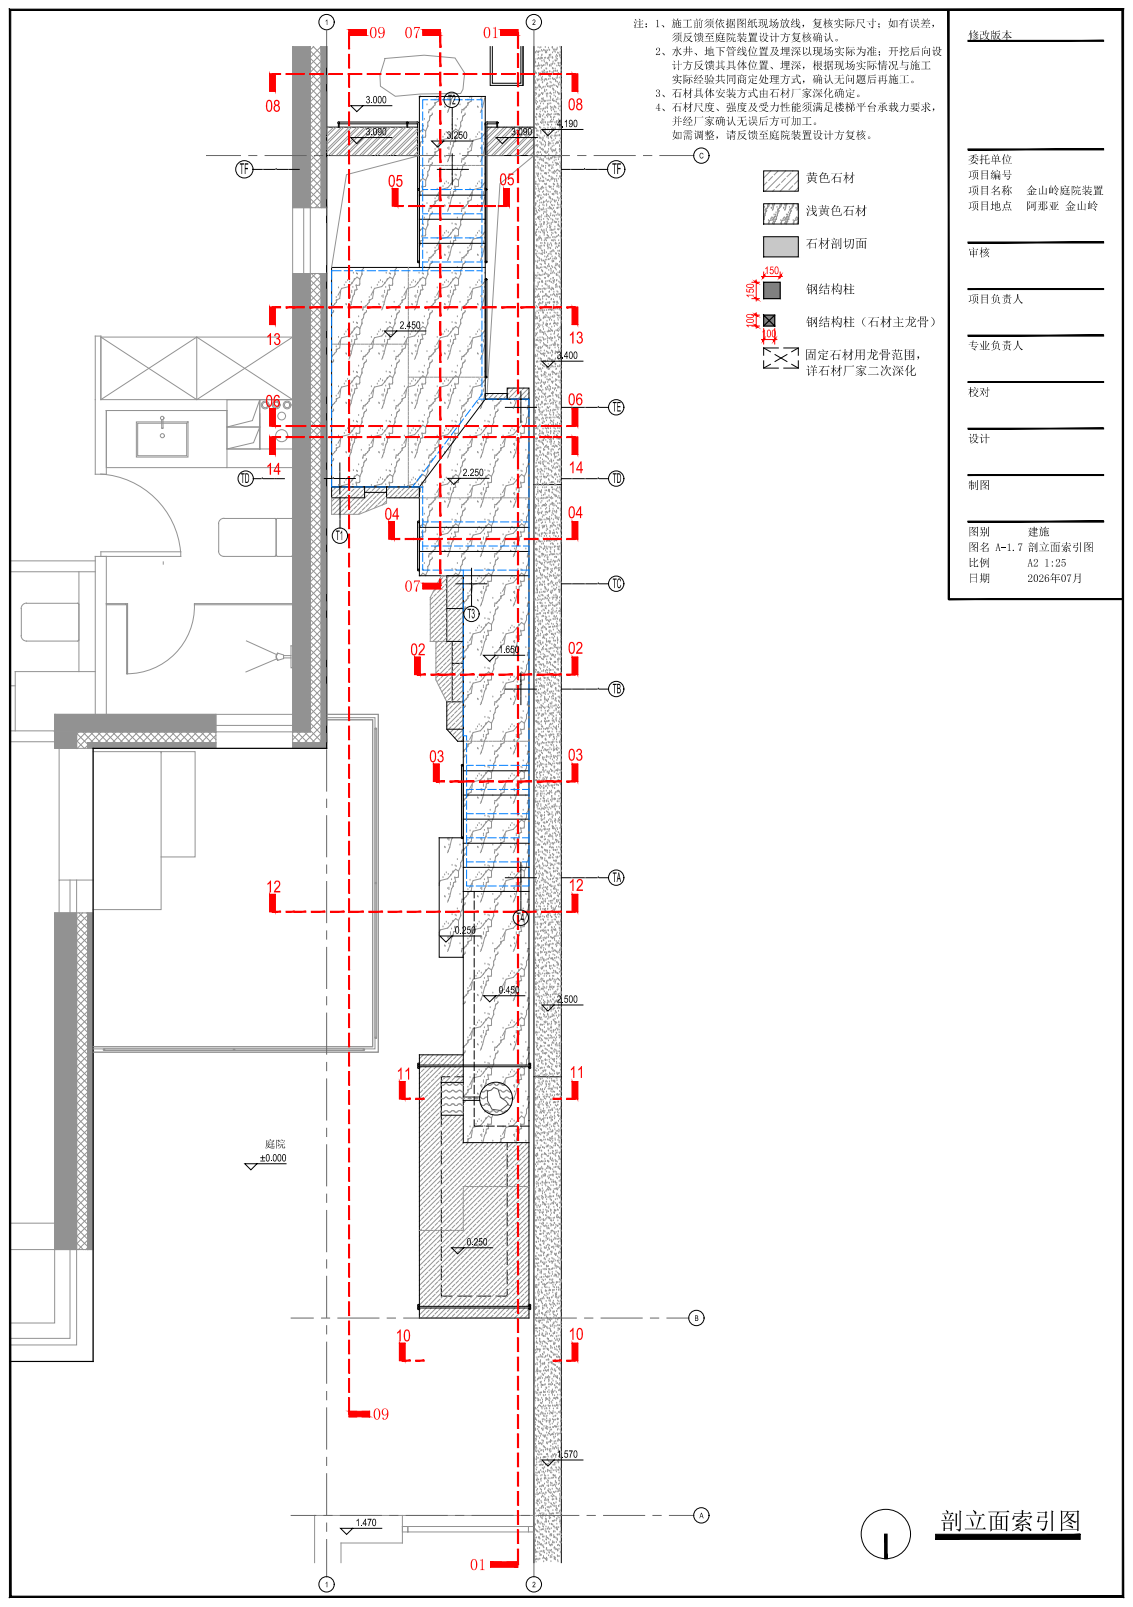
[picture p36: page 9]
A2 1:25 修改版本 图别; 金山岭庭院装置 阿那亚 金山岭 01 01; CBA 03; 剖立面索引图 12; 注：1、施工前须依据图纸现场放线，复核实际尺寸；如有误差， 须反馈至庭院装置设计方复核确认。 2、水井、地下管线位置及埋深以现场实际为准；开挖后向设 计方反馈其具体位置、埋深，根据现场实际情况与施工 实际经验共同商定处理方式，确认无问题后再施工。 3、石材具体安装方式由石材厂家深化确定。 4、石材尺度、强度及受力性能须满足楼梯平台承载力要求， 并经厂家确认无误后方可加工。 如需调整，请反馈至庭院装置设计方复核。; A-1.7 剖立面索引图 TDTATBTCTETF T2 T1; T4 TDTF

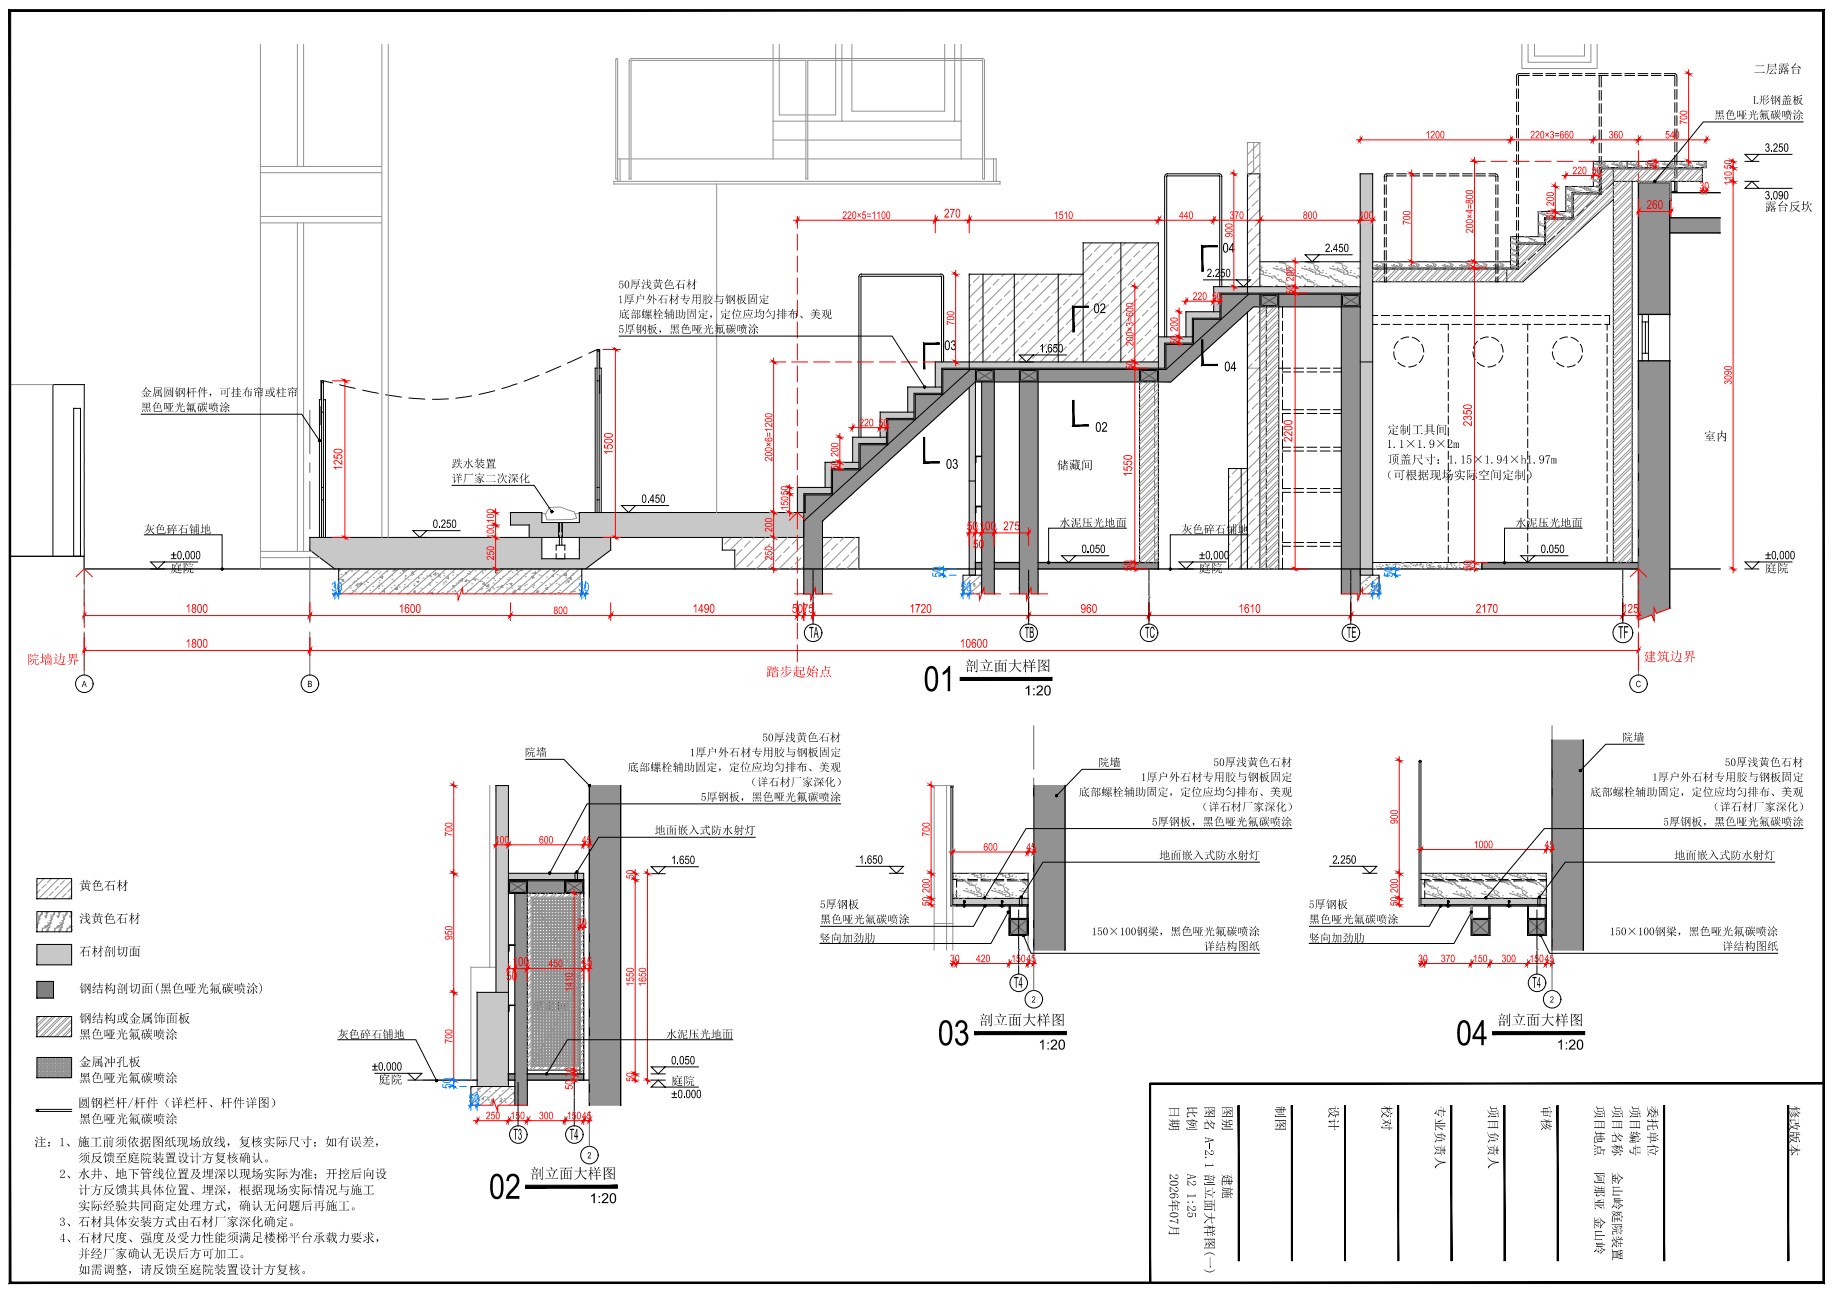
[picture p37: page 10]
剖立面大样图 03; 剖立面大样图 04; C 剖立面大样图 01; 2350 50 700 日期比例图名; 项目地点 项目名称 项目编号; 阿那亚 金山岭; 2 剖立面大样图 02; 详结构图纸 200; 剖立面大样图(一) A-2.1

底部螺栓辅助固定，定位应均匀排布、美观

圆钢栏杆/杆件（详栏杆、杆件详图）
黑色哑光氟碳喷涂

注：1、施工前须依据图纸现场放线，复核实际尺寸；如有误差，

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

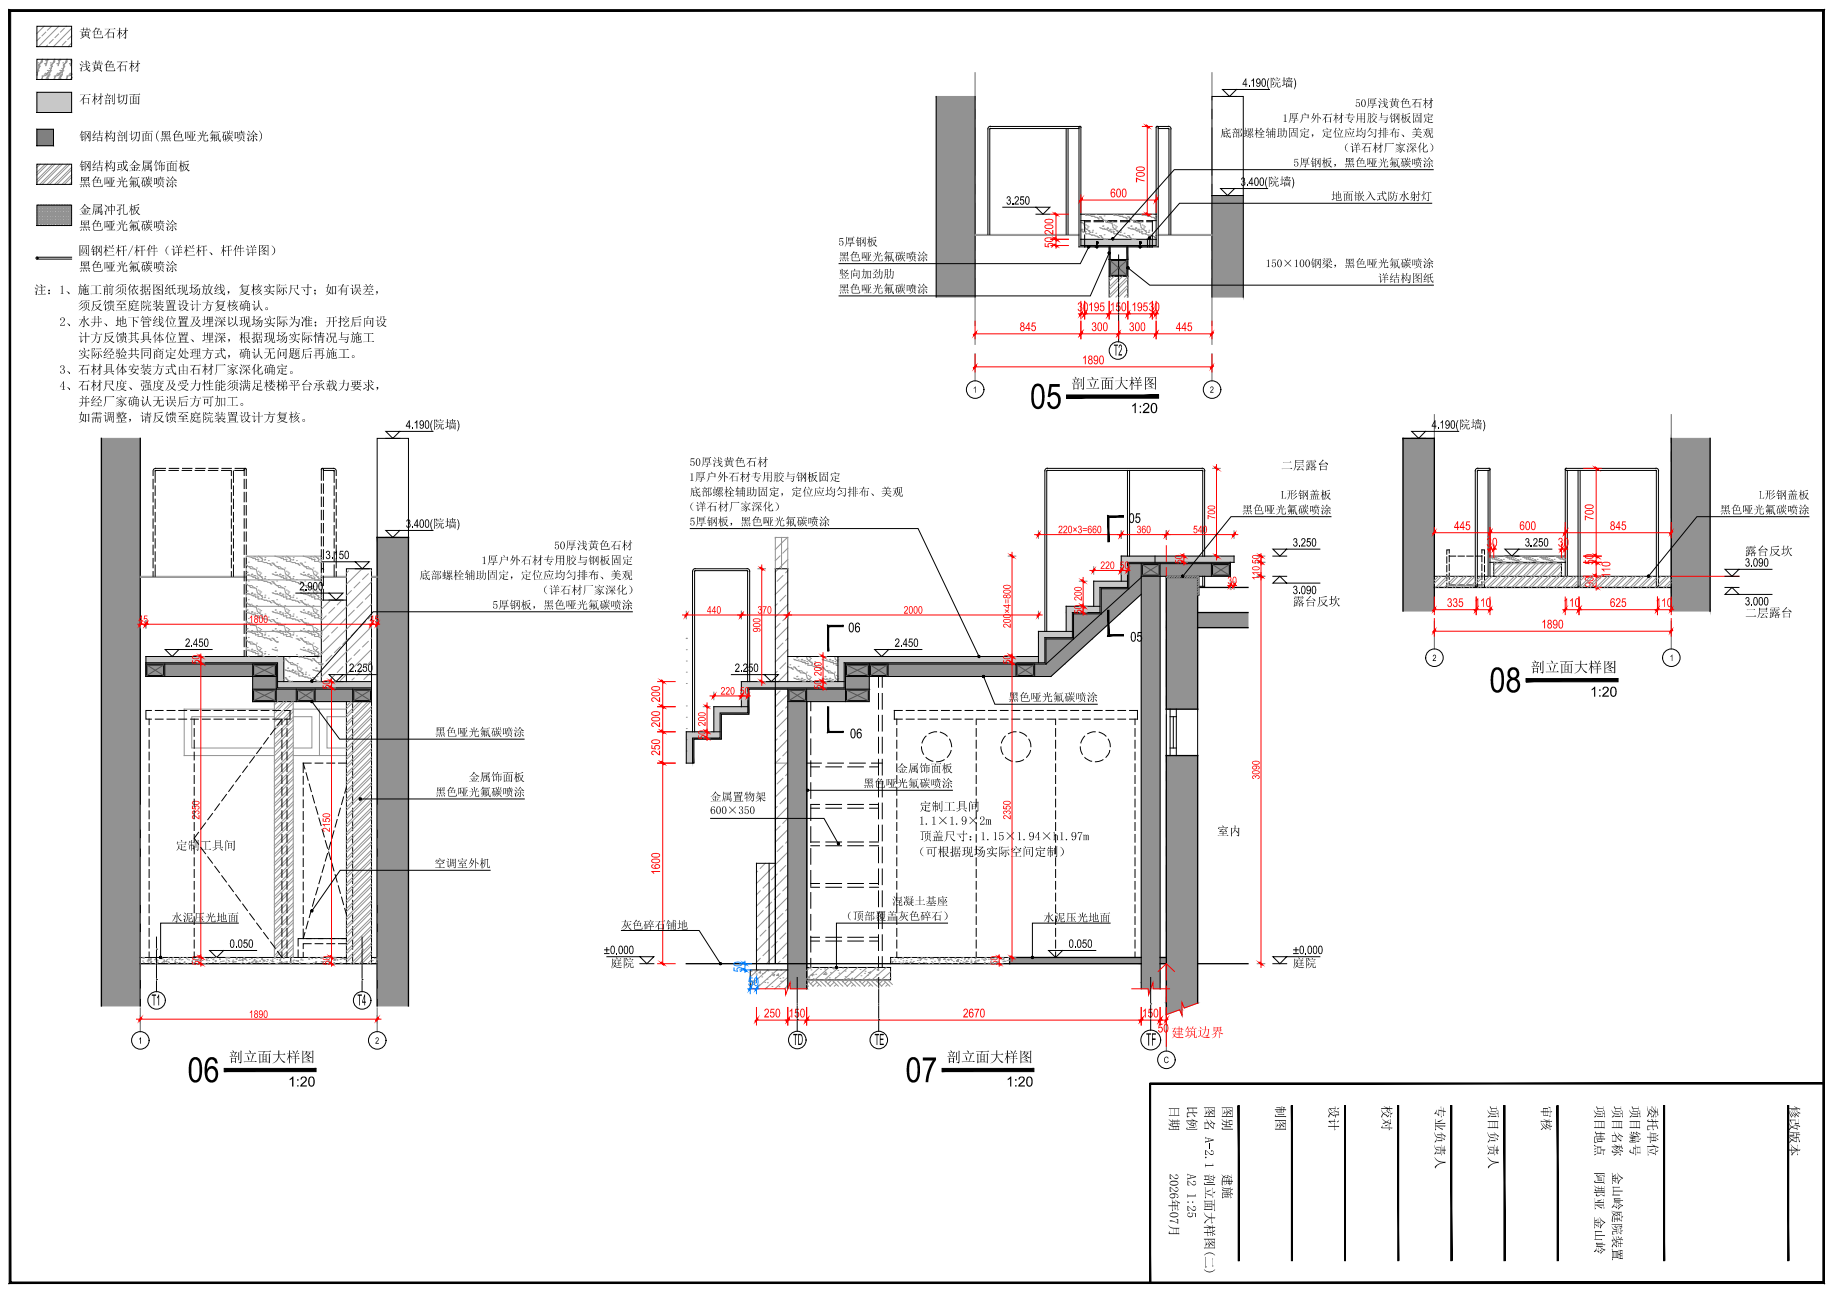
[picture p38: page 11]
剖立面大样图 05; 剖立面大样图; 阿那亚 金山岭; 剖立面大样图 06; 剖立面大样图 08; 二层露台 110 90; 剖立面大样图(二) A-2.1

底部螺栓辅助固定，定位应均匀排布、美观

圆钢栏杆/杆件（详栏杆、杆件详图）
黑色哑光氟碳喷涂

注：1、施工前须依据图纸现场放线，复核实际尺寸；如有误差，

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

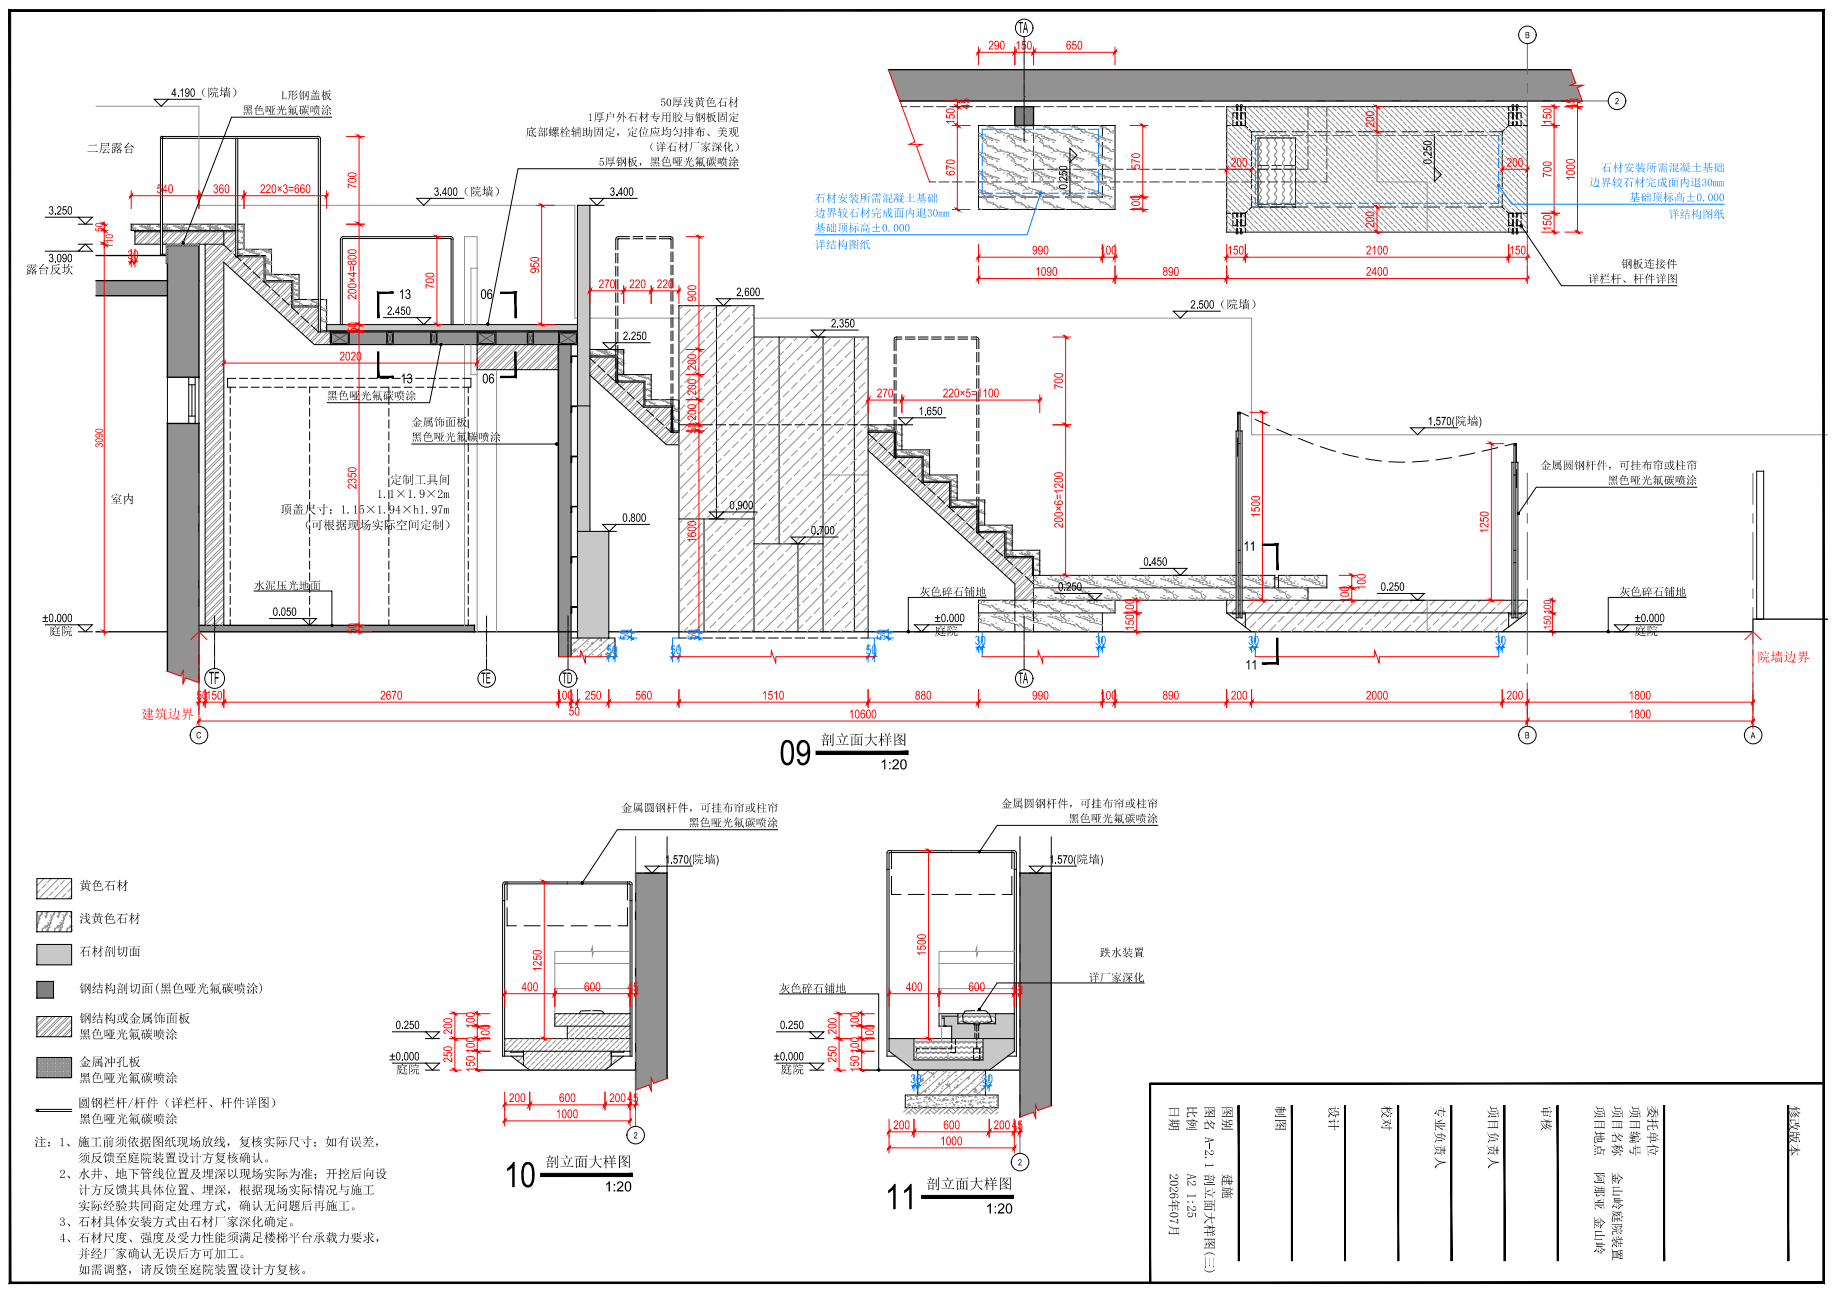
[picture p39: page 12]
150 100 日期比例图名; 阿那亚 金山岭; 金山岭庭院装置 670; 建筑边界 110 50 3090; 剖立面大样图; 剖立面大样图 10; 剖立面大样图 11; 剖立面大样图(三) A-2.1

底部螺栓辅助固定，定位应均匀排布、美观

圆钢栏杆/杆件（详栏杆、杆件详图）
黑色哑光氟碳喷涂

注：1、施工前须依据图纸现场放线，复核实际尺寸；如有误差，

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

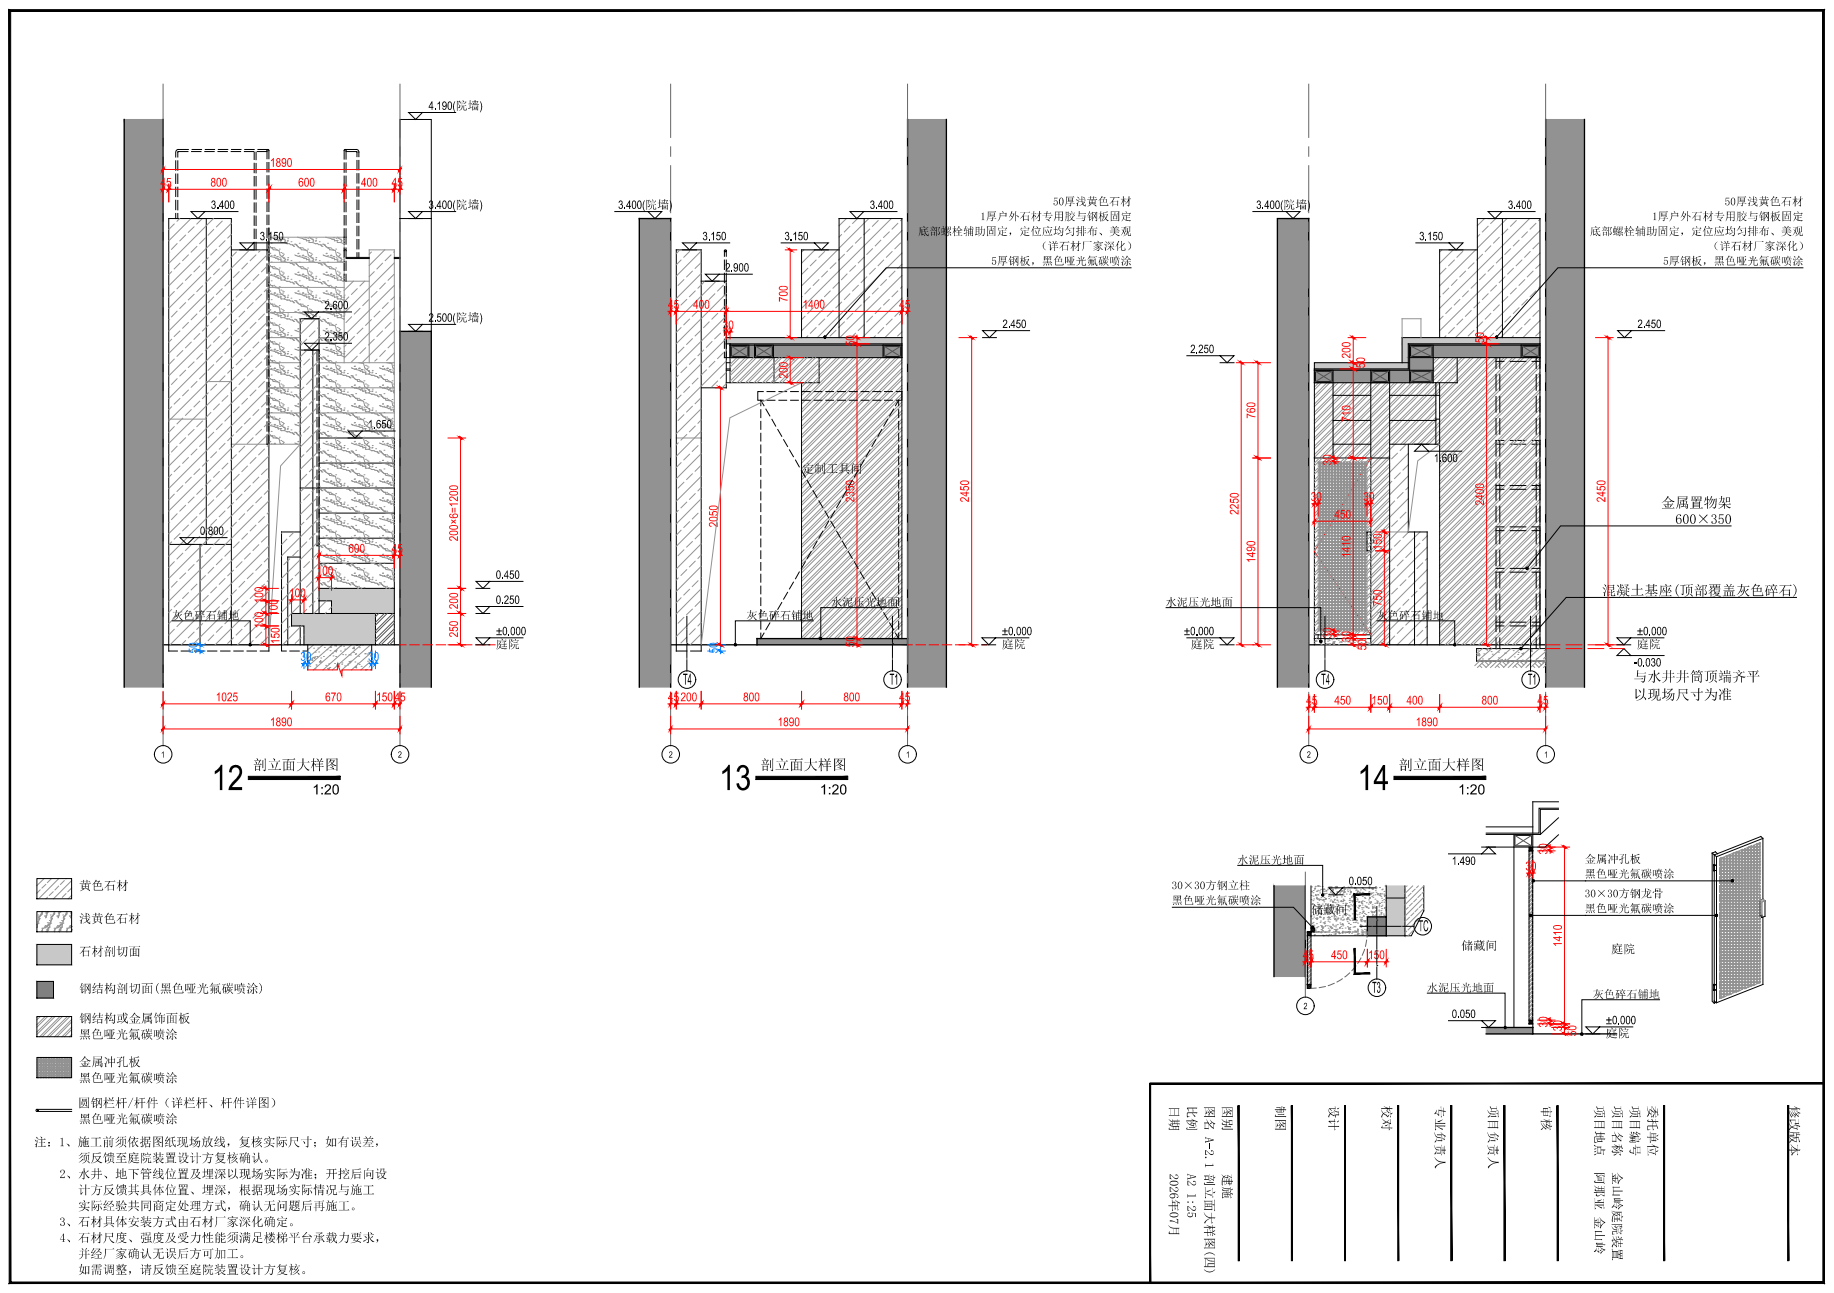
[picture p40: page 13]
阿那亚 金山岭; 剖立面大样图 12; 剖立面大样图 13; 剖立面大样图 14; 以现场尺寸为准 200; 水泥压光地面; 剖立面大样图(四) A-2.1

底部螺栓辅助固定，定位应均匀排布、美观

圆钢栏杆/杆件（详栏杆、杆件详图）
黑色哑光氟碳喷涂

注：1、施工前须依据图纸现场放线，复核实际尺寸；如有误差，

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

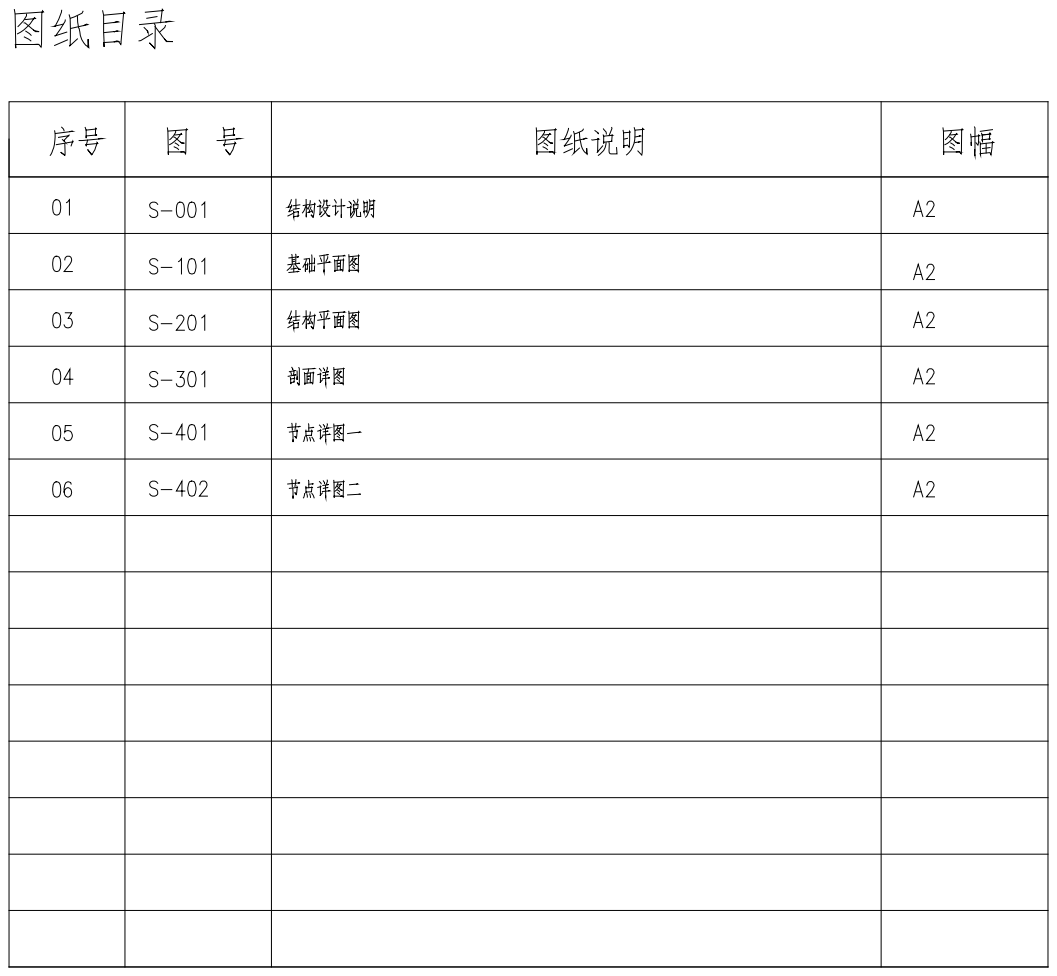
[picture p41: page 14]

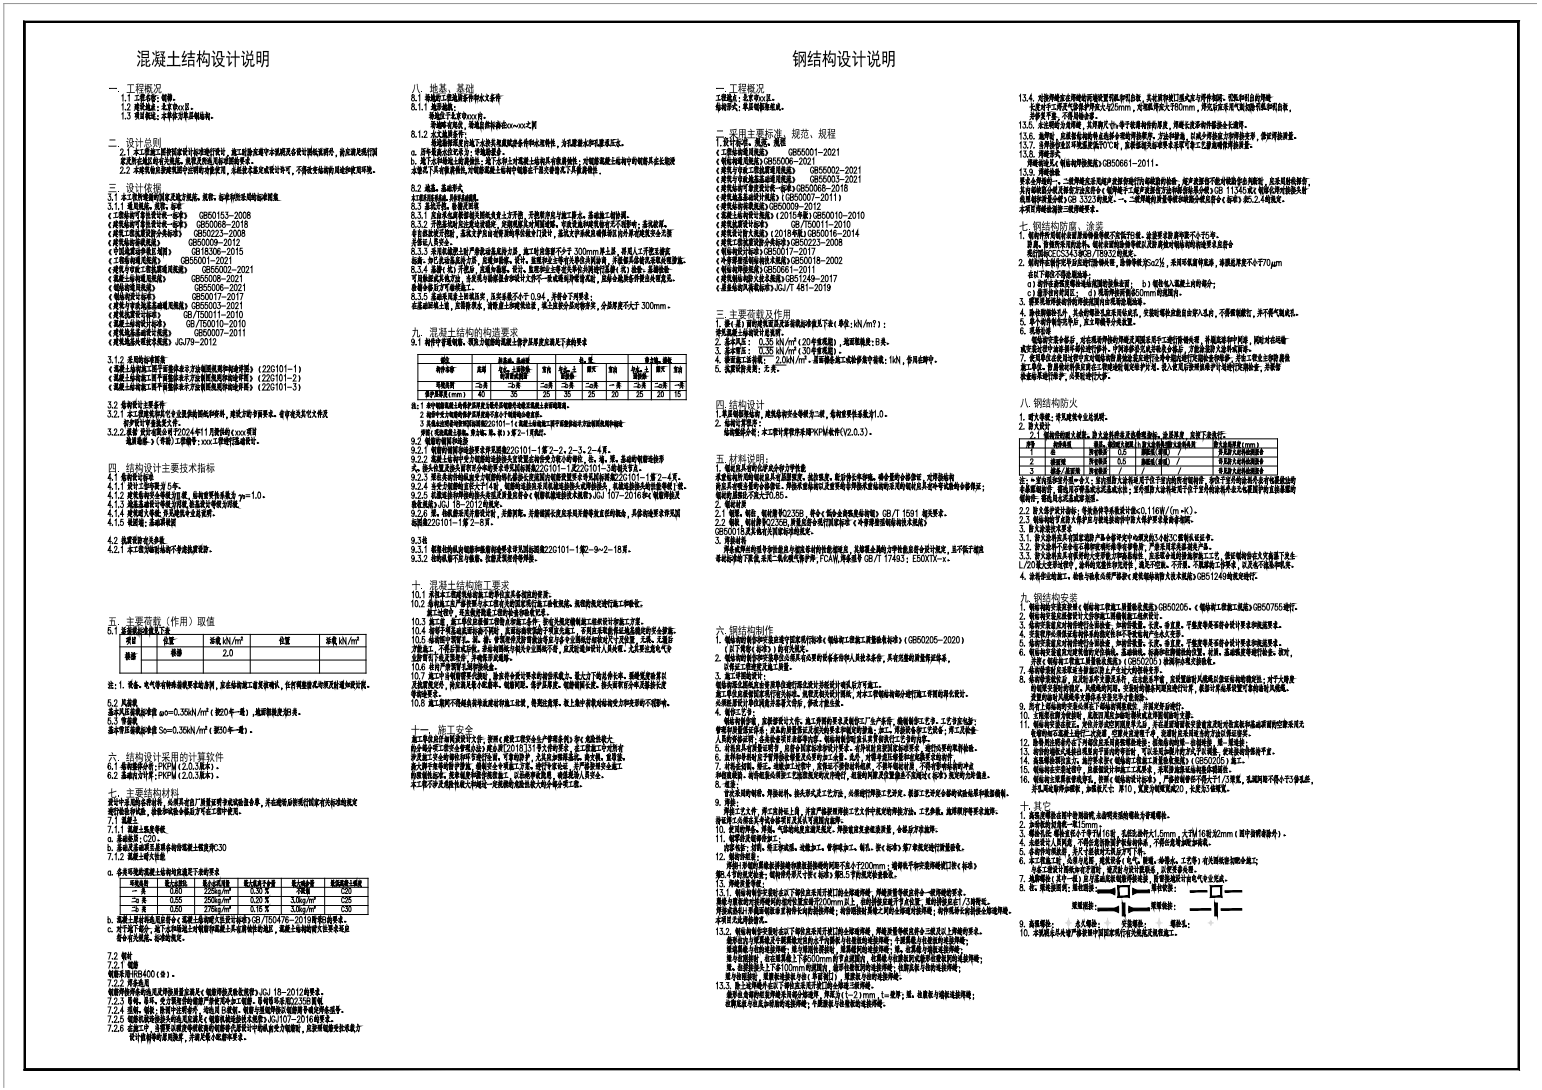
[picture p42: page 15]
三. 设计依据; 一. 工程概况; 二. 设计总则; 四. 结构设计主要技术指标; 六. 结构设计采用的计算软件; 七. 主要结构材料; 九. 混凝土结构的构造要求; 十. 混凝土结构施工要求; 十一. 施工安全

二.采用主要标准、规范、规程

五. 主要荷载（作用）取值

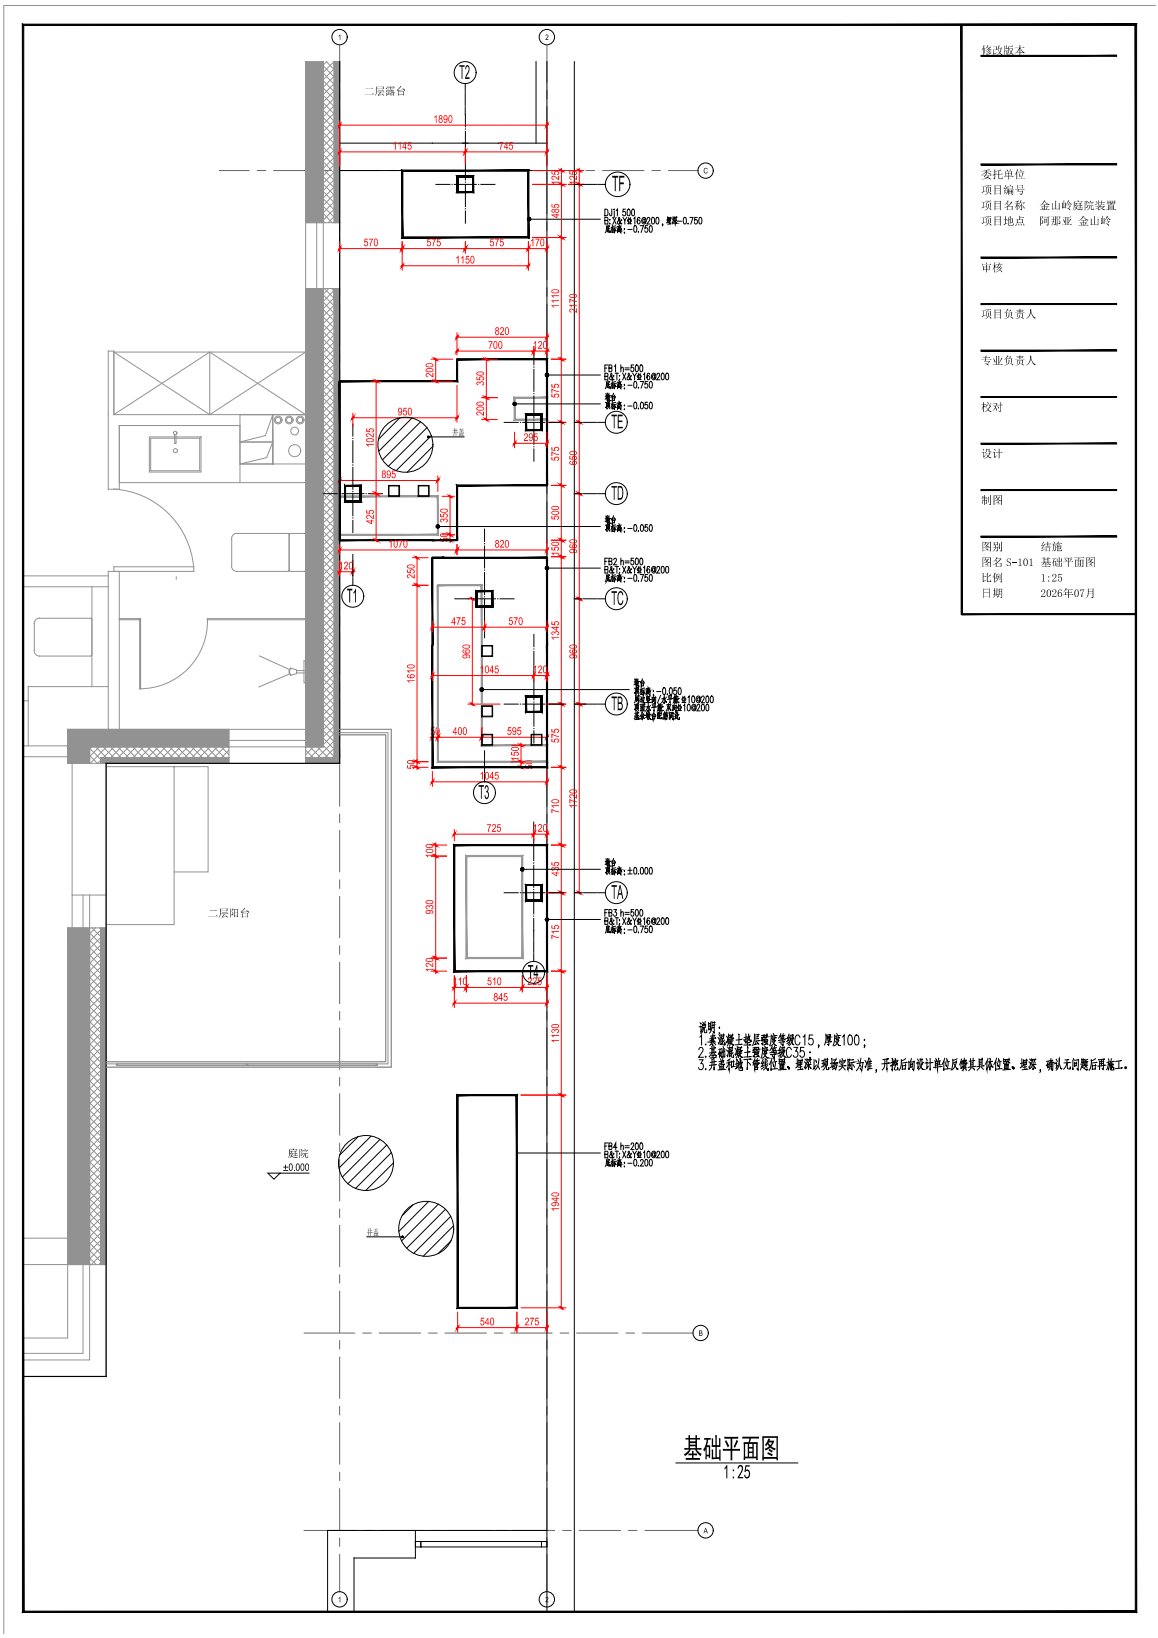
[picture p43: page 16]
CBA; 1:25 基础平面图; 二层阳台; S-101 基础平面图

125 2170 650 960 960 1720 120 1145 745 委托单位 项目编号 项目名称 项目地点 图名比例日期 2026年07月 审核项目负责人 专业负责人 校对设计制图 1:25 修改版本 金山岭庭院装置 阿那亚 金山岭 图别 二层露台

350 200 TDTATBTCTETF T2 T1 T3 T4 结施 井盖

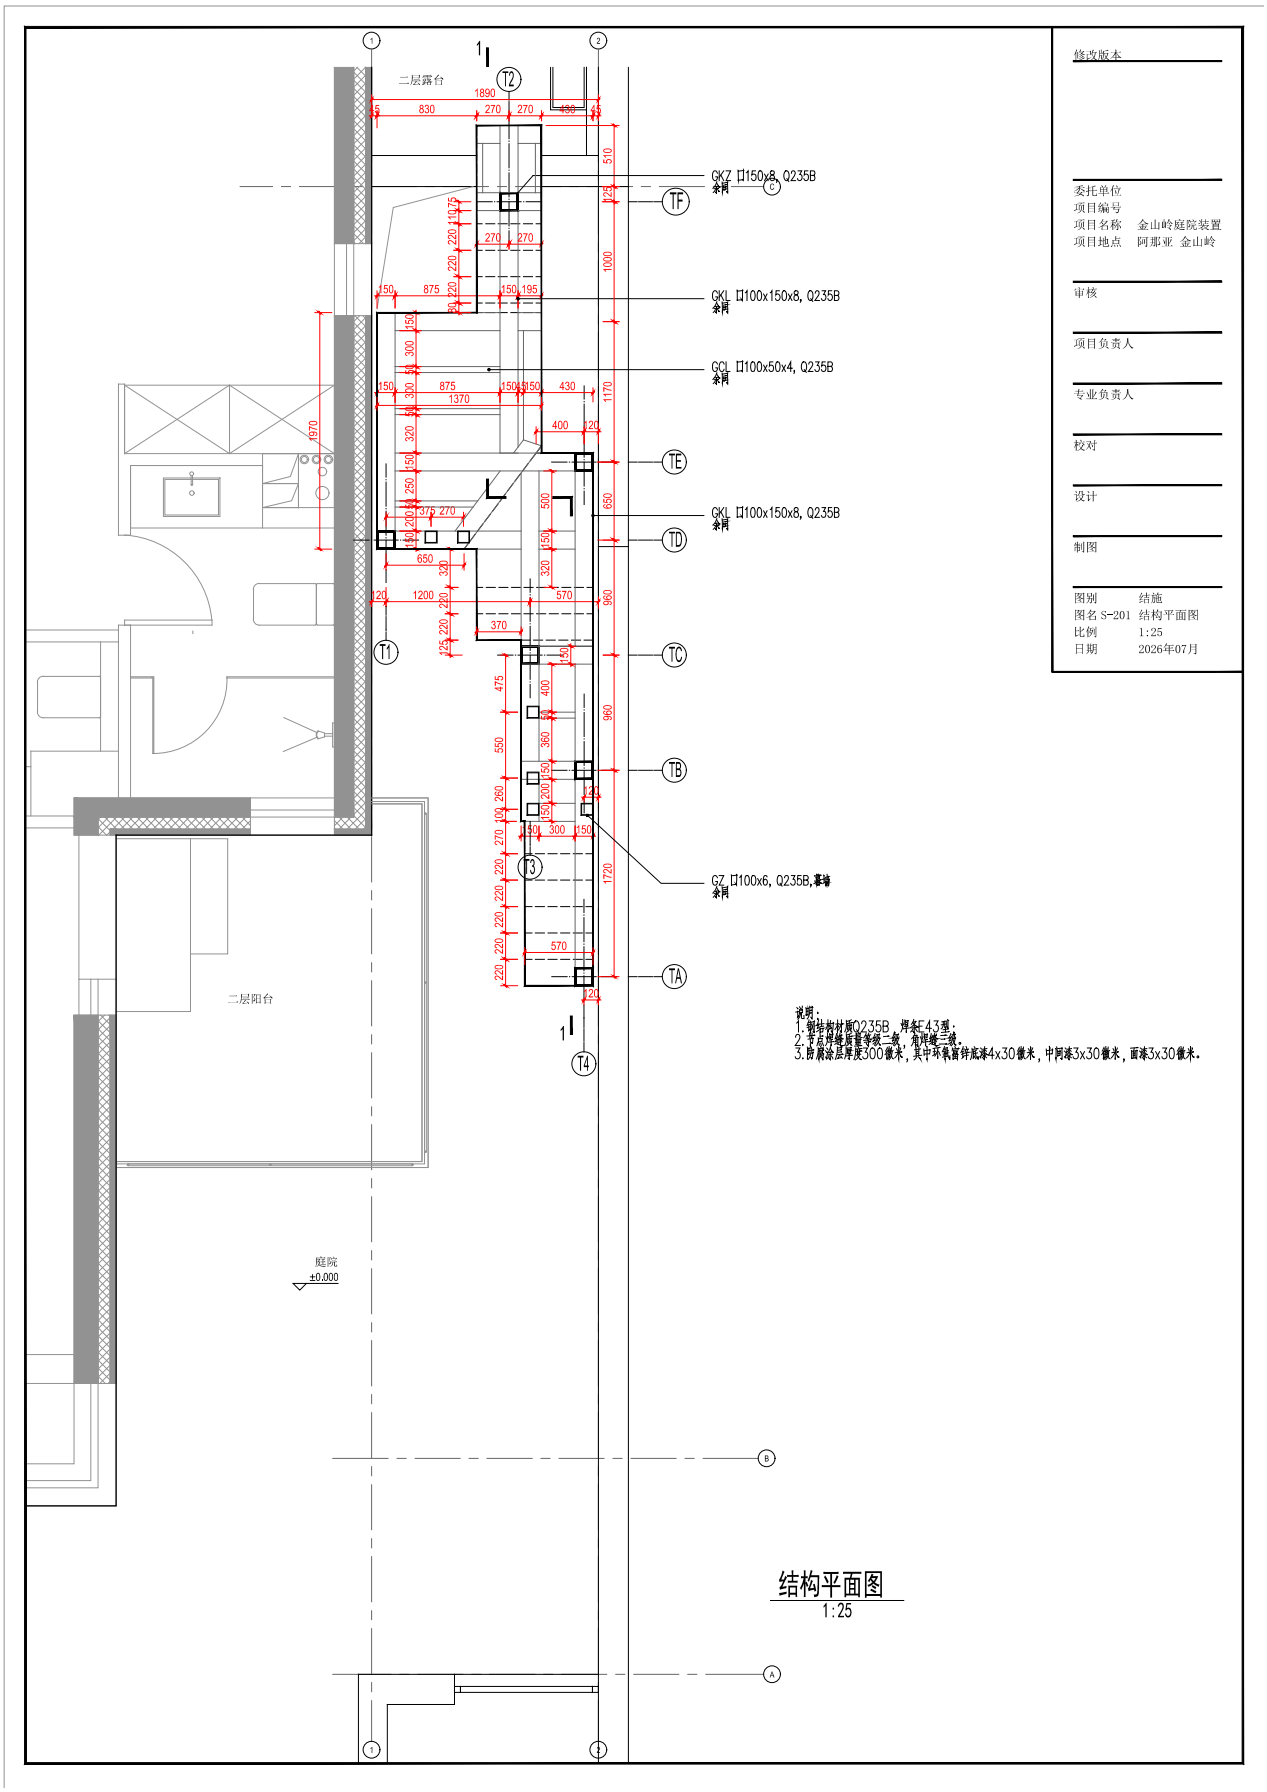
[picture p44: page 17]
CBA 二层阳台; 委托单位 项目编号 项目名称 项目地点 图名比例日期; 2026年07月 审核项目负责人 专业负责人 校对设计制图; 1:25 修改版本; 金山岭庭院装置 阿那亚 金山岭 图别 二层露台375 270; 125 120 TDTATBTCTETF T2 T1 T3 T4; 110 220 220 220 80 1:25 结构平面图 结构平面图 1 1 75 370 570 1370 45 830 430 45 1890 1970 270 270 结施 S-201

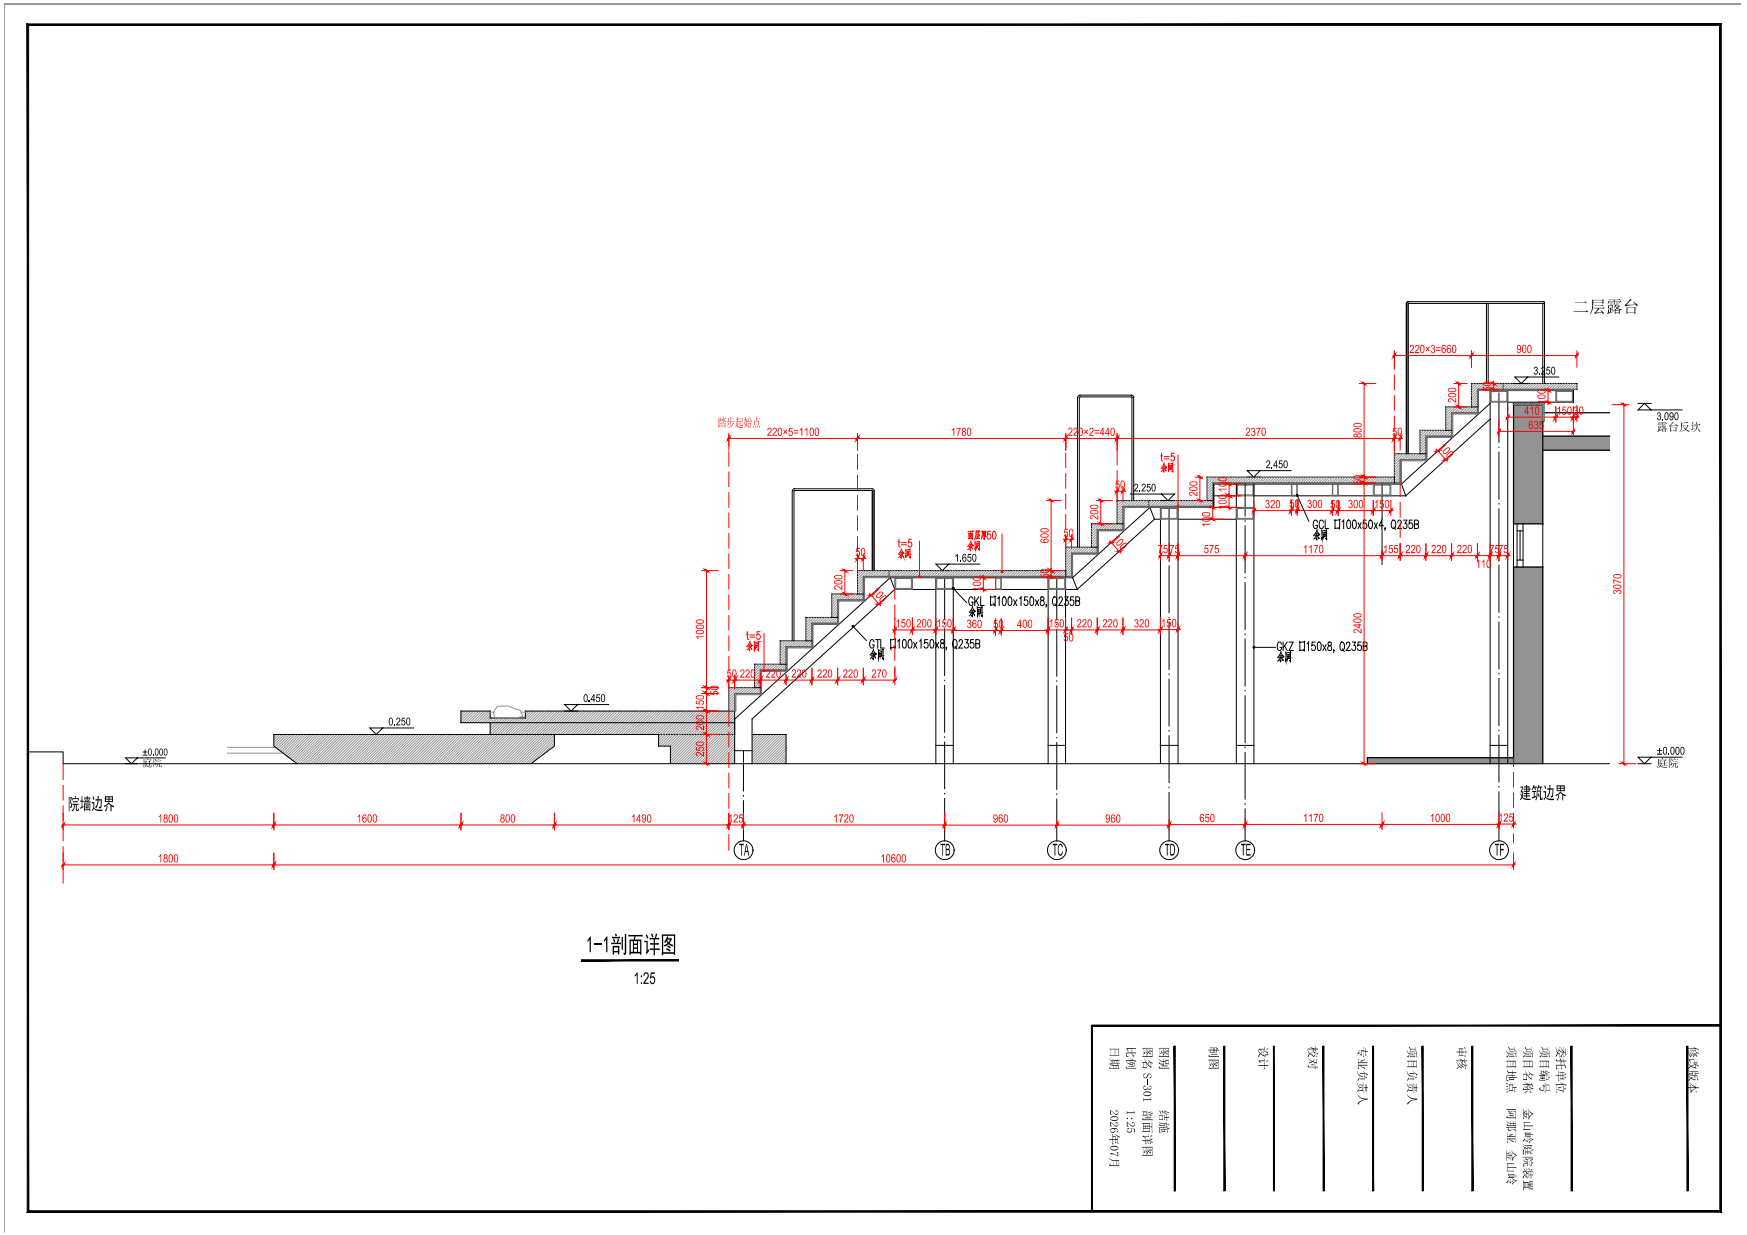
[picture p45: page 18]
建筑边界 院墙边界; 结施 S-301 剖面详图

审核 1:25 修改版本 阿那亚 金山岭 金山岭庭院装置 图别

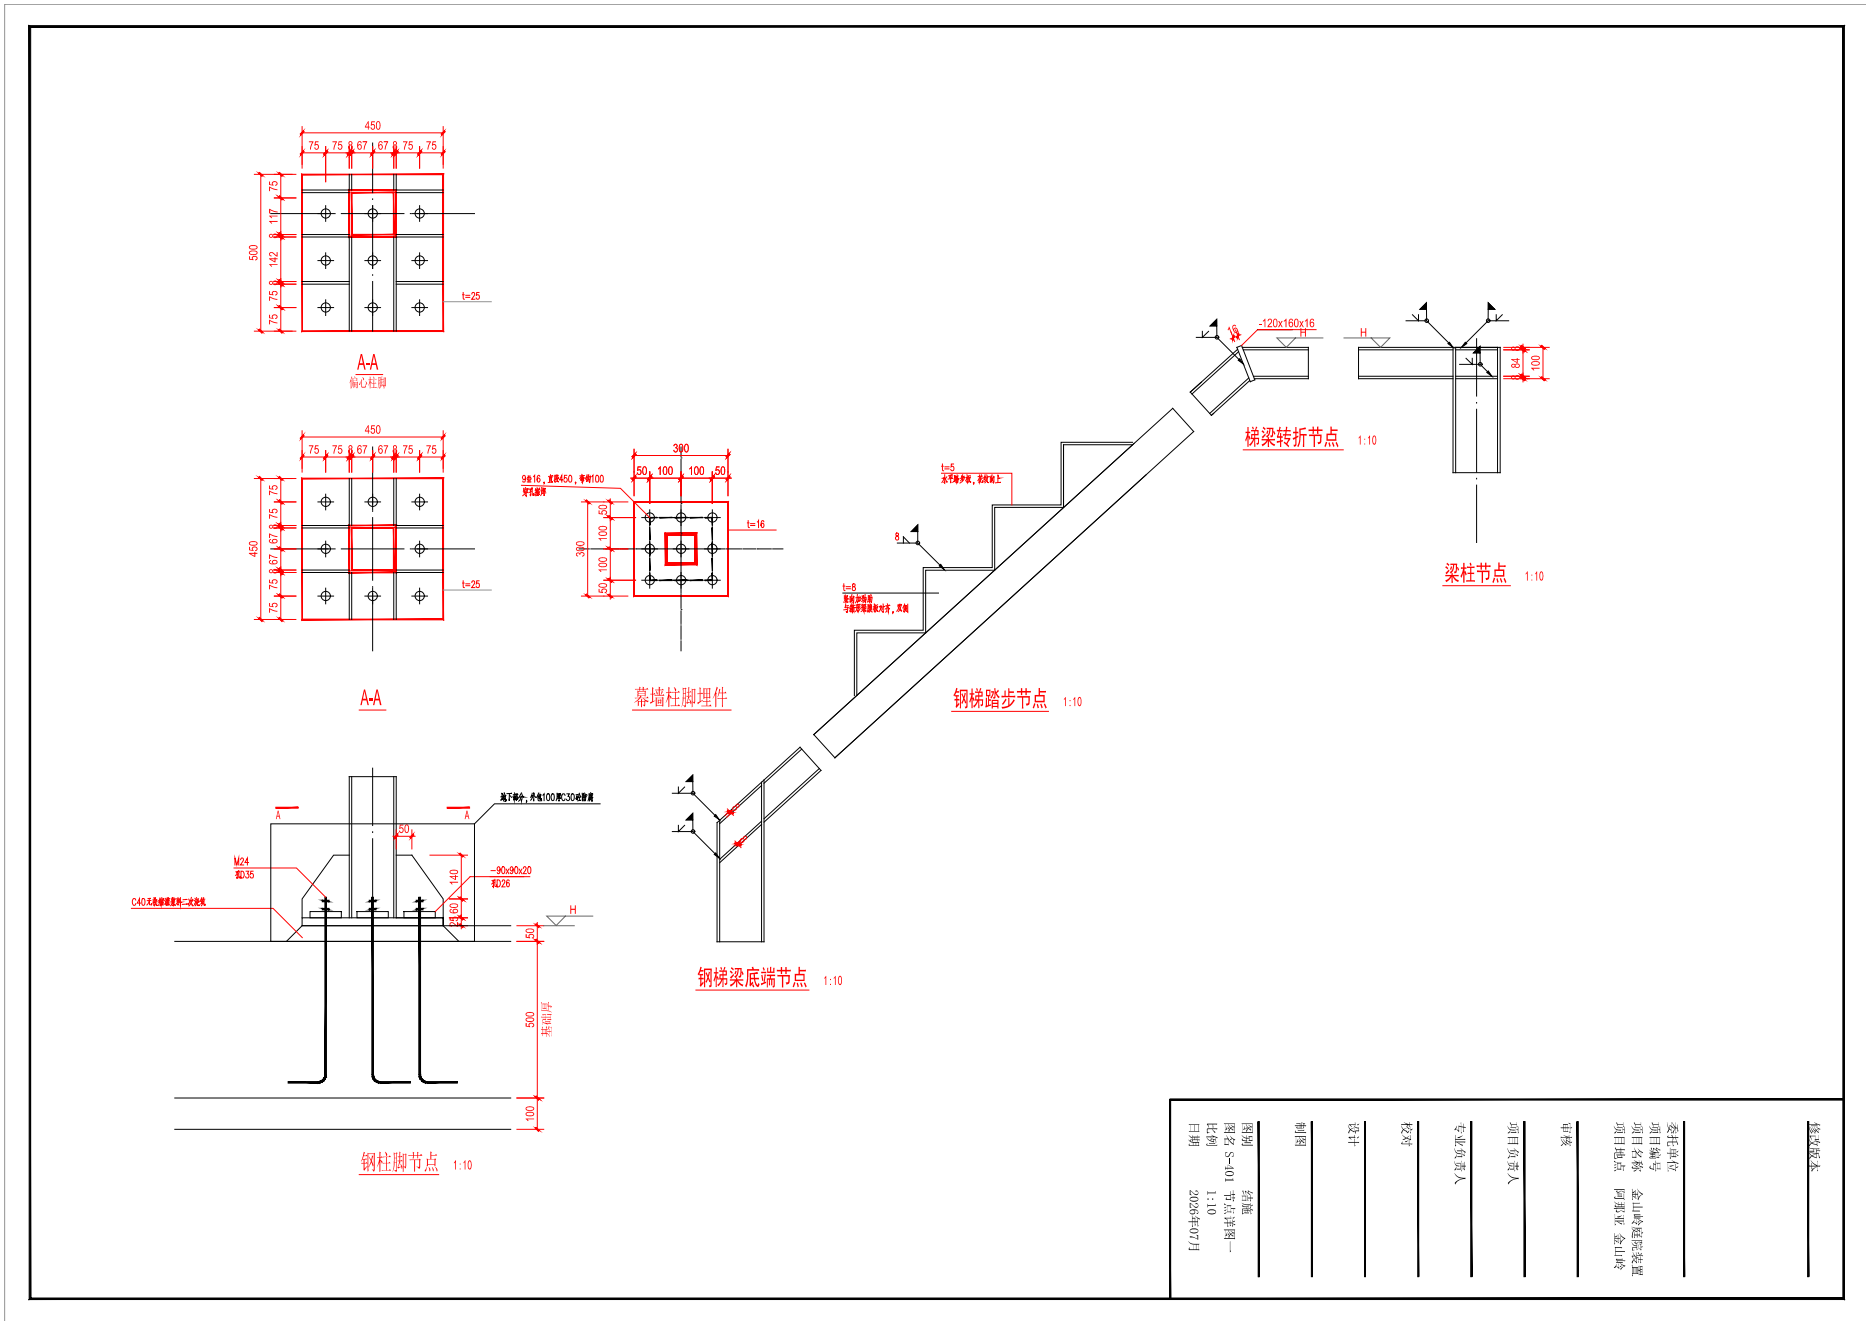
[picture p46: page 19]
钢梯梁底端节点

审核 1:10 修改版本 阿那亚 金山岭 金山岭庭院装置 图别 节点详图一 结施 S-401

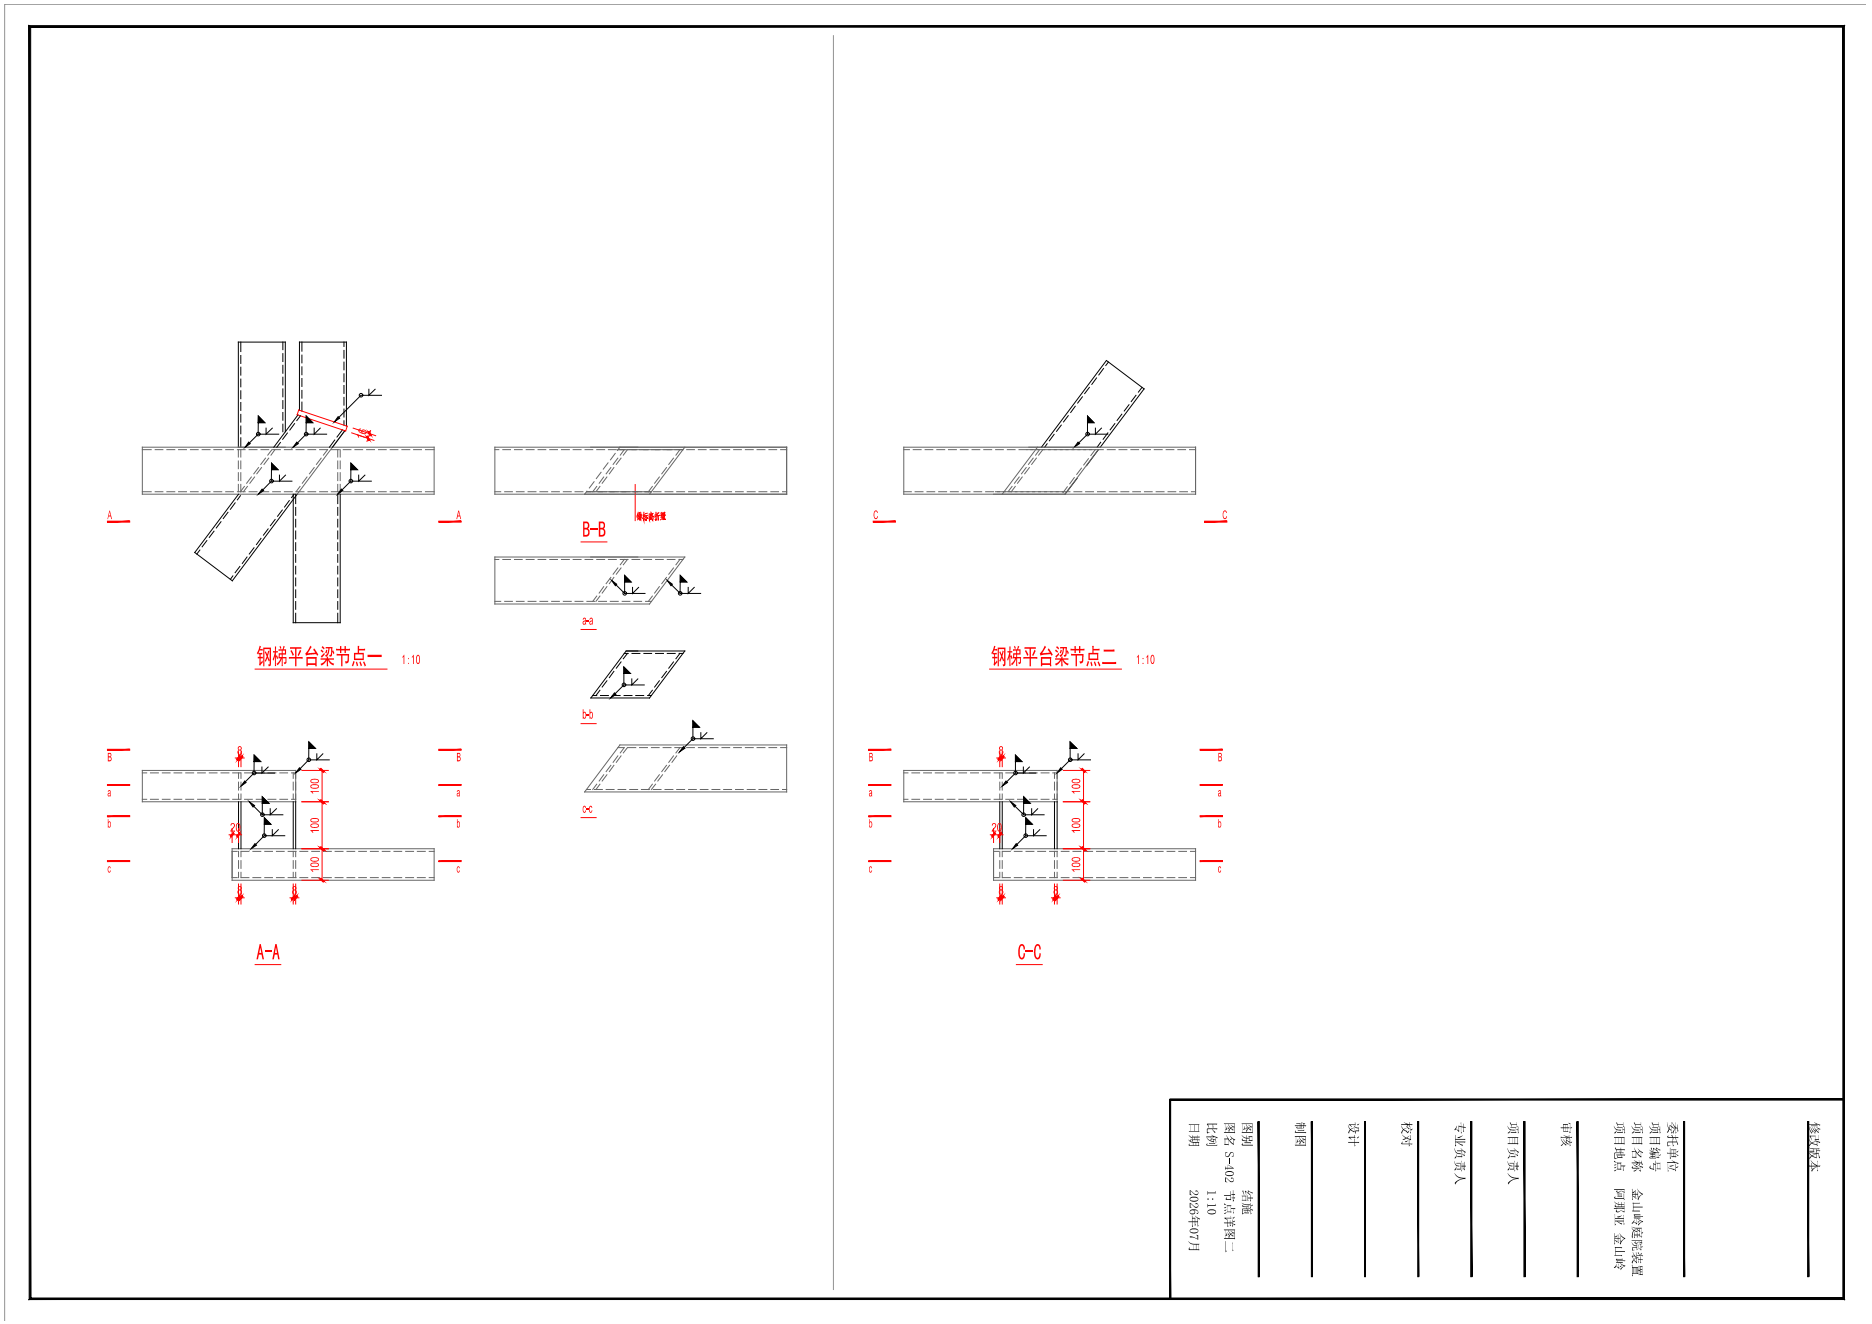
[picture p47: page 20]
钢梯平台梁节点一 A; 钢梯平台梁节点二 C

审核 1:10 修改版本 阿那亚 金山岭 金山岭庭院装置 图别 节点详图二 结施 S-402

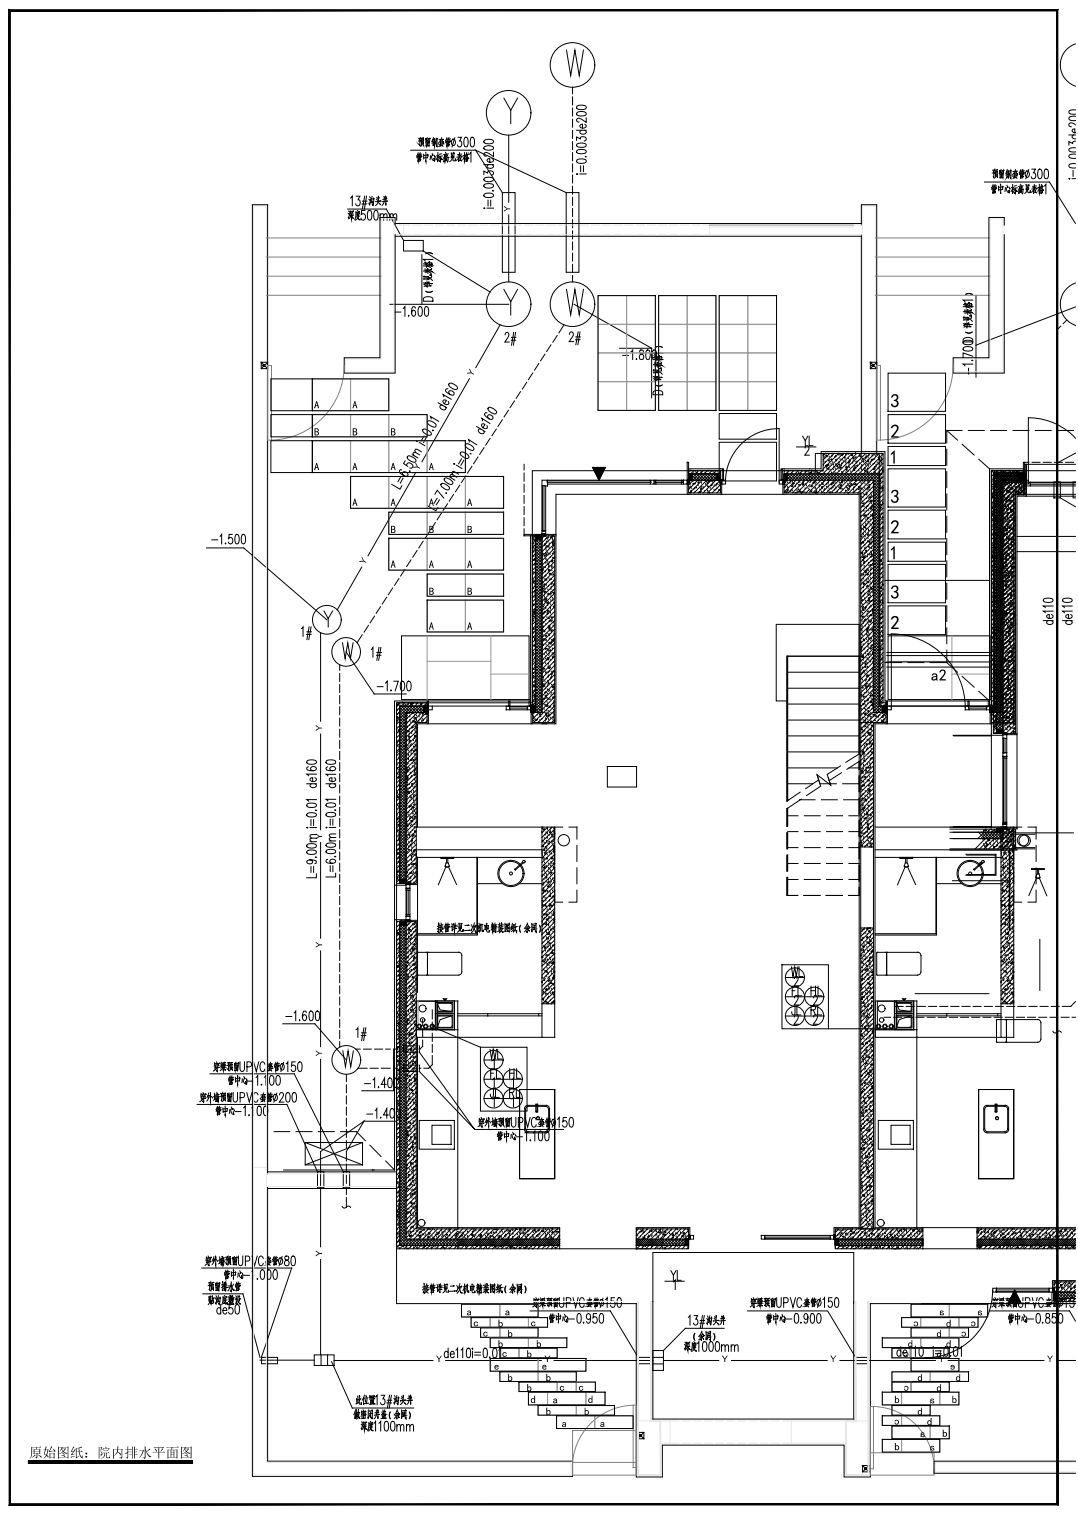
[picture p48: page 21]
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
