streamy2008/jinshanling-yard-dashboard/(commit log)

2026-08-30 feat: initial commit with interactive dashboard and netlify redirect
    [01-1_建筑专业施工图_202607.dwg, 01-2_结构专业施工图_202607.dwg, 01-3_原始图纸_院内排水平面图.dwg, 报价清单对比_20260624_vs_20260829.xlsx, 里山墨石—阿那亚报价清单_按金额排序.xlsx, 里山墨石—阿那亚报价清单对比_20260829_vs_20260830.xlsx, 金山岭小院_9月3日现场交底智能BOM协同表.xlsx, 金山岭小院_完整施工与采购工程量清单汇总表.xlsx]
2026-08-30 ui: redesign dashboard as mobile-first card UI with accordion and filters
2026-08-30 feat: replace horizontal text tab bar with interactive visual grid cards, add sample checklist, and move audit log to bottom
2026-08-30 ui: remove emojis from bottom action bar buttons, keeping text only
2026-08-30 fix: clarify Sept 3 as hand-over交底日 and update construction start dates to post-Sept 3 across WBS and checklist
2026-09-01 feat: add courtyard stone elevation & bedding thickness sample S-06 to on-site sample confirmation list
2026-09-01 feat: add whole-yard stone specification & dimension sample S-07 to on-site sample confirmation list
2026-09-01 feat: add 7 sample items S-08~S-14 (butterfly tenon, gravel gradations, device stone, lichee-face joint, steel rail combo, punched plate, bolt selection) to sample list
2026-09-01 fix: change on-site handover date from Sept 3 to Sept 4 across titles, checklist, samples, WBS and meeting minutes
2026-09-01 fix: rename responsible personnel 员工 to 袁工 in meeting minutes and todo list
2026-09-01 feat: add water-ripple sculpture flow+mirror fabrication plan as technical attachment to meeting minutes module
2026-09-01 feat: add cross-point 6 - physical tool room installation sequencing vs steel frame construction to collision control module
2026-09-01 fix: correct cross-point 5 - steel frame welding precedes stone paving, revise to weld slag cleanup sequencing
2026-09-01 fix: cross-point 2 clarify all large stones hoisted to ground-level skywell only, no second-floor hoisting clearance needed
2026-09-01 refactor: move dashboard HTML files into dedicated folder 金山岭小院施工协同网页 and update netlify redirect
2026-09-04 feat: add section 5 handover checklist - new/old stone junction & finish details (door/window, entrance, 1F exit, steel hoist vs weld, junction sweep)
2026-09-04 feat: expand section 5 into 10 standalone junction/finish checklist items (5.5-5.14) covering curb, pool wall, column base, lighting, gravel edge, stair, rail base, well cover, planter, rolling sweep
2026-09-05 feat: add Plan D Rain-on-Lotus 3D interactive viewer (three.js local libs, orbit controls, ripple flow animation)
2026-09-05 fix: self-contained planD-3d page (local model-viewer+model.glb+sky, English path), point iframe to it, remove X-Frame-Options DENY to allow embedding
2026-09-05 feat: regenerate clean web-first Three.js 3D designs for Plan C (Far Mountain) & Plan D (Rain Drop) with real-time water wave animation and day/night toggles
2026-09-05 refactor: update 3D pool bottom to 3-5cm natural gravel particles and remove simulated tree branches from Plan C
2026-09-05 feat: 1:1 rebuild 3D model according to uploaded VR photo - brick wall, two natural stones with controlled waterfall flow, black mirror pillar, 3-5cm gravel, no plants
2026-09-05 feat: rebuild photoreal PBR materials for granite, brick wall, and black mirror pillar with realistic lighting and waterfall dynamics
